JavierPerez24/Escaner3D/imagenes libro/comparacion de caracteristicas.PNG

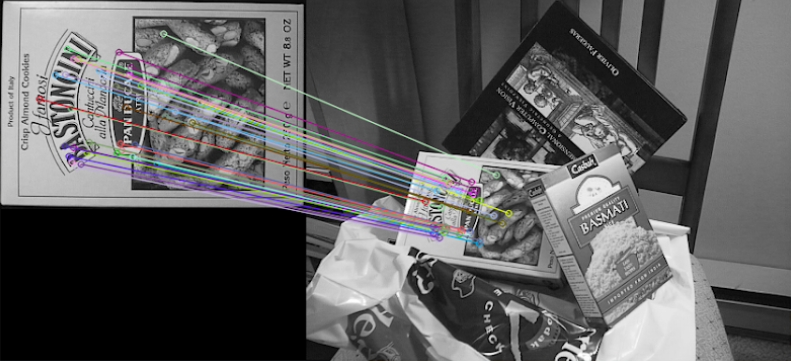
imagenes libro/comparacion de caracteristicas.PNG
