JavierPerez24/Escaner3D/imagenes libro/cnc_shield_v3_para_arduino_mexico_jalisco_guadalajara_1800x1800.jpg

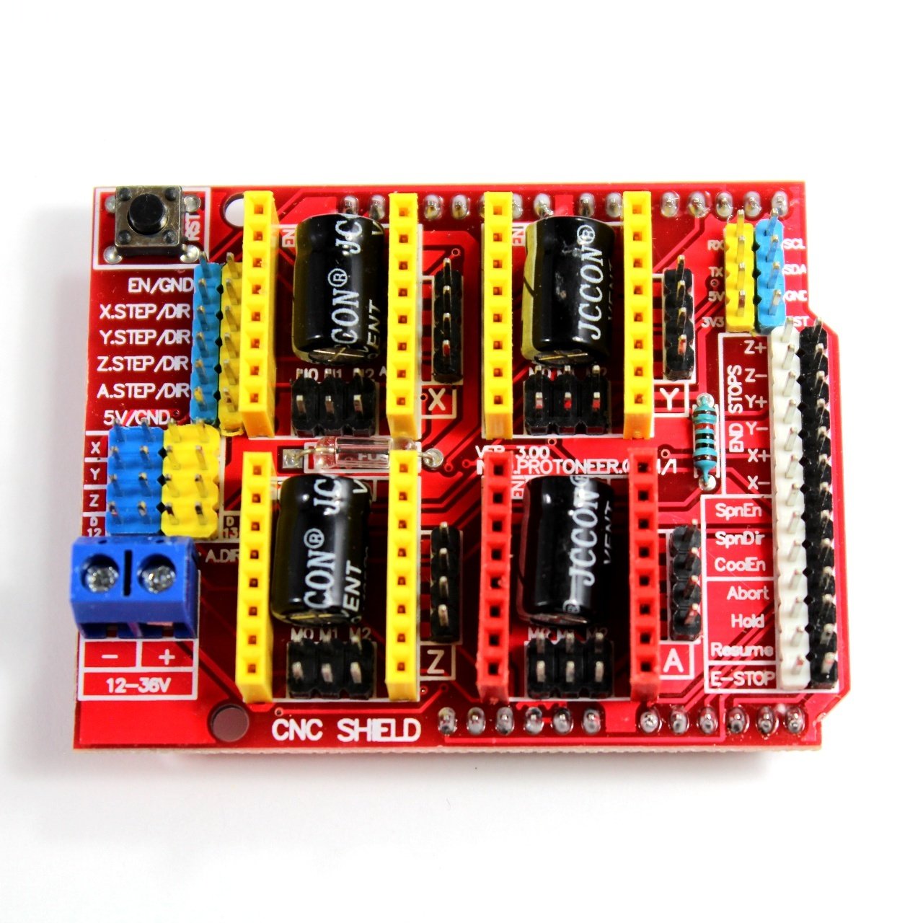
imagenes libro/cnc_shield_v3_para_arduino_mexico_jalisco_guadalajara_1800x1800.jpg
