JavierPerez24/Escaner3D/documentación/Nueva carpeta/Plantilla_Apa/Plantilla_UIS.tex

% ------------------------------------------------------------------------
%
% -------------------      Plantilla_UIS.tex       -----------------------
%
% ------------------------------------------------------------------------
% ------------------------------------------------------------------------
% ------------------------------------------------------------------------
% Versión de plantilla para realización de informes de trabajo de grado
% construida para uso de la Universidad Industrial de Santander.
%
% Reservados todos los derechos
%
% Bucaramanga, Colombia
%
% Febrero 03 de 2019
%
% ------------------------------------------------------------------------
% ------------------------------------------------------------------------
% ------------------------------------------------------------------------
%
% ------------------------------------------------------------------------
\documentclass[letter,oneside,12pt,spanish]{report}          % Encabezados
% ------------------------------------------------------------------------
\usepackage{uislatexstyleAPA}                           % Libreria UIS APA
% ------------------------------------------------------------------------
% Ingrese en este punto las librerías específicas de usuario
% ------------------------------------------------------------------------
\usepackage{epsfig}
\usepackage{amsmath}
\usepackage{amssymb}
\usepackage{subfigure}
% ------------------------------------------------------------------------
\begin{document}                                     % Inicio de documento
% ------------------------------------------------------------------------
% Definición silábica de palabras
% ------------------------------------------------------------------------
\hyphenation{pro-por-cio-nal di-se-ño}
% ------------------------------------------------------------------------
% Titulo resumido del trabajo que aparecerá en cornisa
% ------------------------------------------------------------------------
\title{CONJUNTOS ESTABILIZANTES EN CONTROLADORES PI}
% ------------------------------------------------------------------------
% Elementos previos al contenido del trabajo
% ------------------------------------------------------------------------
\include{Secs/P0}             % Portadilla, formato de nota y autorización
% ------------------------------------------------------------------------
\include{Secs/dedicatoria}                                   % Dedicatoria
% ------------------------------------------------------------------------
\include{Secs/agradecimientos}                           % Agradecimientos
% ------------------------------------------------------------------------
\tableofcontents                                      % Tabla de contenido
% ------------------------------------------------------------------------
\listoffigures                         % Lista de figuras, tablas y anexos
\listoftables
\listofanexo
% ------------------------------------------------------------------------
\include{Secs/glosario}                             % Glosario de términos
% ------------------------------------------------------------------------
% Contenido del Informe
% ------------------------------------------------------------------------
\include{Secs/res}                                               % Resumen
\include{Secs/abs}                                              % Abstract
% ------------------------------------------------------------------------
% Capítulos
% ------------------------------------------------------------------------
\input{Secs/T0}   % Introducción
\include{Secs/T1}   % Objetivos
\include{Secs/T2}   % Conjunto estabilizante para sistemas LTI
\input{Secs/T3}   % Modelo matemático del DRON
\input{Secs/T4}   % Controladores PI y su conjunto estabilizante
\input{Secs/T5}   % Recomendaciones
\input{Secs/T6}   % Trabajo futuro
\input{Secs/T7}   % Conclusiones
% ------------------------------------------------------------------------
% Bibliografía
% ------------------------------------------------------------------------
\addcontentsline{toc}{chapter}{Referencias Bibliográficas}\newpage
\bibliographystyle{apalike}
\bibliography{xbib}
% ------------------------------------------------------------------------
% Anexos
% ------------------------------------------------------------------------
\input{Secs/anexoA} % Fundamentos de sólidos rígidos
\input{Secs/anexoB} % Función ode45 de MATLAB
\input{Secs/anexoC} % Interfaz de animación de la dinámica del sistema
% ------------------------------------------------------------------------
\end{document}                                          % Fin de documento
% ------------------------------------------------------------------------
