JavierPerez24/Escaner3D/documentación/Nueva carpeta/Plantilla_Apa/Secs/P0.tex

% ------------------------------------------------------------------------
%                               Portadilla
% ------------------------------------------------------------------------

\begin{center}

Verificación de Conjuntos Estabilizantes para el Método de Diseño de Controladores PI de Ziegler \& Nichols \vspace{2.3cm}

Emerson Rey Ardila\\ \vspace{2.3cm}

Trabajo de Grado para optar al título de Ingeniero Electrónico\\ \vspace{2.3cm}

Director\\
Ricardo Alzate Castaño\\
Doctorado en Ingeniería Informática y Automática \vspace{2.4cm}

Universidad Industrial de Santander\\
Facultad de Ingenierías Fisicomecánicas\\
Escuela de Ingenierías Eléctrica, Electrónica y de Telecomunicaciones\\
Bucaramanga\\
2019\\

\end{center}

% ------------------------------------------------------------------------
%                             Nota de proyecto
% ------------------------------------------------------------------------

\newpage

\begin{figure}
\begin{center}

\end{center}
\end{figure}

% ------------------------------------------------------------------------
%                             Autorización
% ------------------------------------------------------------------------

\newpage

\begin{figure}
\begin{center}

\end{center}
\end{figure}
% ------------------------------------------------------------------------
