JavierPerez24/Escaner3D/documentación/Nueva carpeta/Plantilla_Apa/Secs/agradecimientos.tex

% ------------------------------------------------------------------------
% ------------------------------------------------------------------------
% ------------------------------------------------------------------------
%                             AGRADECIMIENTOS
% ------------------------------------------------------------------------
% ------------------------------------------------------------------------
% ------------------------------------------------------------------------
\chapter*{Agradecimientos}

\noindent Agradezco a mi familia por el apoyo ecónomico y moral que tuvieron para conmigo
durante el desarrollo de mi carrera. También agradezco a mis amigos y
compañeros por las vivencias de estos inolvidables años de universidad.\\

Un reconocimiento y agradecimiento importante lo realizo a mi director de
trabajo de grado, por dedicar su tiempo, experiencia y conocimiento en la guía
de mi proyecto.
% ------------------------------------------------------------------------
\newpage
