JavierPerez24/Escaner3D/documentación/Nueva carpeta/Plantilla_Apa/Secs/dedicatoria.tex

% ------------------------------------------------------------------------
% ------------------------------------------------------------------------
% ------------------------------------------------------------------------
%                               Dedicatoria
% ------------------------------------------------------------------------
% ------------------------------------------------------------------------
% ------------------------------------------------------------------------
\chapter*{Dedicatoria}

\noindent Este trabajo viene dedicado para todas aquellas personas que apoyaron el desarrollo
y ejecución de este trabajo de grado.\\

En especial reconozco la permanente presencia de Dios en mi camino de vida.
% ------------------------------------------------------------------------
