JavierPerez24/Escaner3D/documentación/Nueva carpeta/Plantilla_Apa/Secs/res.tex

% ------------------------------------------------------------------------
% ------------------------------------------------------------------------
% ------------------------------------------------------------------------
%                                Resumen
% ------------------------------------------------------------------------
% ------------------------------------------------------------------------
% ------------------------------------------------------------------------
\chapter*{Resumen}

\footnotesize{
\begin{description}
  \item[Título:] Verificación de Conjuntos Estabilizantes para Diseño de Controladores PI de Ziegler \& Nichols \astfootnote{Trabajo de grado}
  \item[Autor:] Emerson Rey Ardila \asttfootnote{Facultad de Ingenierías Físico-Mecánicas. Escuela de Ingenierías Eléctrica, Electrónica y telecomunicaciones. Director: Ricardo Alzate Castaño, Doctorado en Ingeniería Informática y Automática.}
  \item[Palabras Clave:] Conjunto Estabilizante, Controladores PI, Diseño Gráfico de Compensadores, Método de Ziegler \& Nichols.
  \item[Descripción:] El presente proyecto presenta el cálculo de conjuntos estabilizantes para sistemas SISO LTI controlados por compensadores de estructura simple. Se estudia la fragilidad de controladores PI calculados empleando el método \emph{Ziegler \& Nichols}, técnica de referencia en múltiples aplicaciones de ambito industrial. A partir de la definición para una métrica basada en la interpretación geométrica para los márgenes de estabilidad del sistema controlado, se verifica que el controlador diseñado con el método en cuestión no necesariamente tolera variaciones significativas en sus valores de parámetro. Por el contrario, asume comportamientos cercanos a los límites de estabilidad proporcionados mediante el cálculo de su conjunto estabilizante. Lo anterior se convierte en información importante tomando en cuenta que generalmente los métodos de diseño se someten a un ajuste fino. Como métrica, se define el espacio planar correspondiente con la intersección entre una elipse y una línea recta que representan lugares geométricos de márgen de fase y/o ganancia constantes. Adicional a lo anterior, se desarrolló una interfaz en MATLAB que permite calcular gráficamente los parámetros del controlador a partir de un conjunto admisible de especificaciones con base en su conjunto estabilizante. Trabajo complementario incluye la utilización de técnicas computacionales para el cálculo de
conjuntos estabilizantes sobre plantas arbitrarias.
\end{description}}\normalsize
% ------------------------------------------------------------------------
