JavierPerez24/Escaner3D/documentación/Nueva carpeta/Plantilla_Apa/Secs/T1.tex

% ------------------------------------------------------------------------
% ------------------------------------------------------------------------
% ------------------------------------------------------------------------
%                              Objetivos
% ------------------------------------------------------------------------
% ------------------------------------------------------------------------
% ------------------------------------------------------------------------

\chapter{Objetivos}
% ------------------------------------------------------------------------
% ------------------------------------------------------------------------

\section*{Objetivo general}

\begin{itemize}
   \item[ ] Analizar las condiciones de estabilidad del conjunto de parámetros PI calculados
   empleando el método de diseño de controladores de Ziegler \& Nichols.
\end{itemize}

\section*{Objetivos específicos}

\begin{itemize}
    \item[ ] Interpretar las tablas de diseño de parámetros PI de Ziegler \& Nichols en términos de conjuntos estabilizantes;
    \item[ ] Desarrollar un algoritmo que permita verificar las condiciones de estabilidad para controladores PI diseñados mediante dicho método;
    \item[ ] Implementar una interfaz para cálculo de controladores PI a partir de selección de parámetros en el dominio del tiempo, admisibles respecto al conjunto estabilizante correspondiente.
\end{itemize}
% ------------------------------------------------------------------------
% ------------------------------------------------------------------------
