JavierPerez24/Escaner3D/documentación/Nueva carpeta/Plantilla_Apa/Secs/T5.tex

% ------------------------------------------------------------------------
% ------------------------------------------------------------------------
% ------------------------------------------------------------------------
%                            Recomendaciones
% ------------------------------------------------------------------------
% ------------------------------------------------------------------------
% ------------------------------------------------------------------------

\chapter{Recomendaciones}
% ------------------------------------------------------------------------
\noindent Al momento de ejecutar la interfaz desarrollada es importante que el usuario tenga una noción respecto al rango de valores que desea visualizar, pues esto hace más fino el detalle de los puntos sobre los cuales se calcula el conjunto estabilizante y por ende, la exploración de los valores admisibles para el control en la práctica.
% ------------------------------------------------------------------------
