JavierPerez24/Escaner3D/documentación/Nueva carpeta/Plantilla_Apa/Secs/T6.tex

% ------------------------------------------------------------------------
% ------------------------------------------------------------------------
% ------------------------------------------------------------------------
%                            Trabajo futuro
% ------------------------------------------------------------------------
% ------------------------------------------------------------------------
% ------------------------------------------------------------------------

\chapter{Trabajo futuro}
% ------------------------------------------------------------------------
\noindent Actividades complementarias a los desarrollos presentados, incluyen el cálculo automático para conjuntos estabilizantes en plantas arbitrarias empleando el \emph{método de la signatura} desarrollado por Keel y Bhattacharyya en \citep{keel2008}.\\

Asimismo es importante explorar otras topologias de compensador y controladores PID, en sus versiones de tiempo continuo y discreto.
% ------------------------------------------------------------------------
