JavierPerez24/Escaner3D/Entrega/CartaAutorizacion.pdf

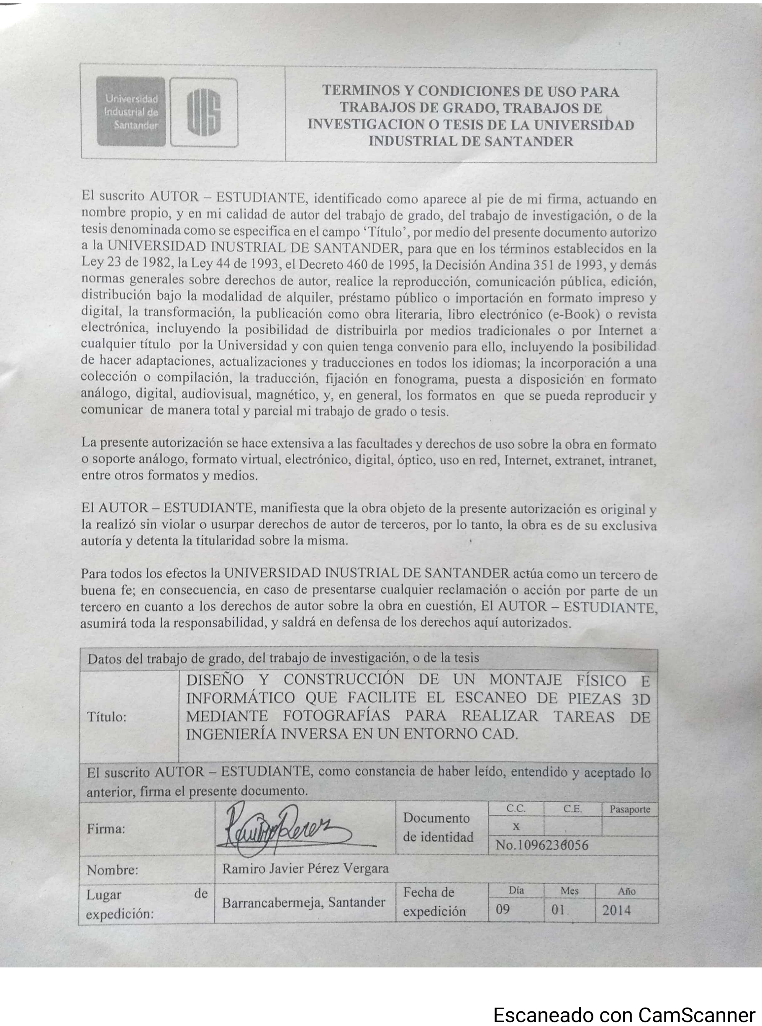
[picture p50: page 1]
