JavierPerez24/Escaner3D/Entrega/Ficha Ramiro Pérez.pdf

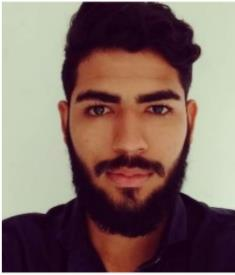
[picture p51: figure]

RAMIRO JAVIER PÉREZ VERGARA

3194591198
3214230738

Ramirojavierperezvergara@gmail.com

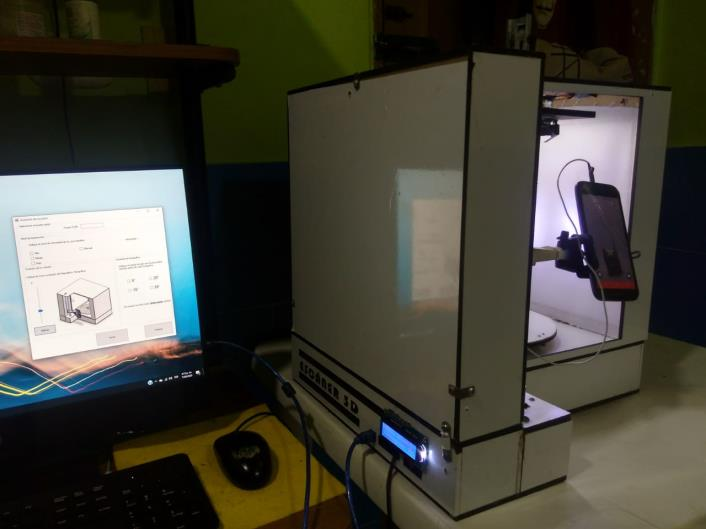
[picture p52: figure]

UNIVERSIDAD INDUSTRIAL DE SANTANDER

ESCUELA DE INGENIERÍA MECÁNICA

25 DE NOVIEMBRE DE 2020

DISEÑO Y CONSTRUCCIÓN DE UN MONTAJE FÍSICO E INFORMÁTICO QUE FACILITE EL ESCANEO DE PIEZAS 3D MEDIANTE FOTOGRAFÍAS PARA REALIZAR TAREAS DE INGENIERÍA INVERSA EN UN ENTORNO CAD.
