JavierPerez24/Escaner3D/documentación/Sistema de seguimiento de caras y estimación de pose con modelado automático 3D.pdf

## REF.: TRANSP_UAH_01

### SECTOR

INDUSTRIAL | Industria y Transporte
INVESTIGADOR | Luis Miguel Bergasa Pascual
DEPARTAMENTO | Electrónica
DATOS DE CONTACTO | + 34 91 885 65 69 + 34 91 885 65 41
| @ luism.bergasa@uah.es
PÁGINA WEB | Robótica de Servicios y Tecnologías para la
| Seguridad Vial (https://portal.uah.es/portal/page/portal/grupos_de_investigacion/83)

## DESCRIPCIÓN DEL RESULTADO DE INVESTIGACIÓN

### TÍTULO

Sistema de seguimiento de caras y estimación de pose con modelado automático 3D

### RESUMEN

El grupo Robesafe de la Universidad de Alcalá ha desarrollado un método que realiza el seguimiento y estimación de las poses de la cara de una persona, usando visión estéreo. Este método no necesita identificar previamente a la persona y no requiere un entrenamiento previo.

El modelo de cara se construye automáticamente on-line. Este método podría servir como la base de un sistema de supervisión de conducción o de análisis de la conducta de conductores y ha sido probado sobre secuencias registradas en un simulador naturalista y en un coche en movimiento.

El grupo está interesado en alcanzar acuerdos comerciales con asistencia técnica con empresas del sector de los componentes para la automoción, diseñadoras de simuladores y electrónica de entretenimiento (interfaces para PCs, TVs, videojuegos, etc).

### DESCRIPCIÓN Y CARACTERÍSTICAS FUNDAMENTALES

El modelo está formado por un conjunto de puntos tridimensionales 3D de la cara. Estos puntos son automáticamente seleccionados en la primera imagen obtenida por las cámaras. La cara es localizada usando el método de Viola&Jones y los puntos de la cara que presentan adecuadas características para el seguimiento se encuentran con el detector de puntos de Harris. Se usan hasta 30 puntos.

Los parches de imagen alrededor de las proyecciones 2D de estos puntos en cada cámara son rastreados en cada imagen usando el algoritmo Simultaneous Modelling and Tracking (SMAT). Este algoritmo construye un modelo con los cambios de la apariencia o la textura alrededor de cada punto.

La pose en 3D se obtiene de puntos en 2D usando el algoritmo POSIT de manera redundante por ambas cámaras con el fin de mejorar la solidez del sistema.

El tracking puede fallar para algunos puntos en cada frame. El algoritmo RANSAC se usa entonces para desechar puntos erróneos en la valoración de la pose. Después de obtener un set de puntos correctamente localizados (inliers), la posición de los puntos outlier es reinicializada en función de la pose estimada.

Algunos puntos se ocluyen cuando la cabeza de la persona gira y no pueden ser entonceslocalizados. Este sistema sin embargo es capaz de estimar la pose de la cara de manera fiable en giros de entre +/- 90º. Para ello utiliza una novedosa técnica que va completando el modelo según la cara va girando y emplea el método de bundle adjustment para ajustar el modelo.

El sistema funciona ya en condiciones reales y ha sido validado en un simulador naturalita y en un vehículo de demostración. Los resultados experimentales y el análisis del funcionamiento se encuentran listos para ser presentados.

### ASPECTOS INNOVADORES

Este sistema de visión artificial es capaz de reconocer por primera vez la orientación de la cara humana, sin necesidad de identificar previamente a la persona ni de realizar entrenamientos previos. Además, es capaz de realizar seguimiento con bajas condiciones de iluminación y alcanza un rango de funcionamiento entre +/- 90º.

Este sistema es innovador en cuanto a la forma de juntar los tres algoritmos con los que funciona: SMAT, RANSAC, Levenberg-Marquardt y Bundle Adjustment. Se desconoce la existencia de un sistema anterior que los haya utilizado de esta manera y que logre un rango de funcionamiento de giro total en condiciones de baja iluminación.

### PALABRAS CLAVE

Visión artificial, tracking 3D, seguimiento de caras, estimación de poses, seguridad transporte y conducción

### DISCIPLINAS CIENTÍFICAS EN LAS QUE SE ENCUADRA EL RESULTADO DE INVESTIGACIÓN

Tecnologías de la Información y las
Telecomunicaciones

Fabricación Industrial, tecnologías de los Materiales y el Transporte

Tecnologías Industriales

Energía

Ciencias Físicas y Exactas

Ciencias Biológicas

Agricultura y Recursos Marinos

Industria de la Agroalimentación

Medidas y estándares

Medioambiente y prevención de riesgos

Socioeconomía

### GRADO DE DESARROLLO DEL RESULTADO DE INVESTIGACIÓN

En fase de desarrollo

Desarrollada, lista para demostración

En el mercado

### FUENTE DE FINANCIACIÓN DE LA INVESTIGACIÓN

Proyecto Europeo

Proyecto Nacional

Proyecto Regional

Financiación Privada

## ASPECTOS COMERCIALES

### VENTAJAS COMPETITIVAS

Este método funciona en tiempo real (30 imágenes por segundo) y tarda 33 milisegundos para ejecutar los algoritmos.

Es un sistema muy robusto que continua funcionando incluso ante situaciones para las cuales el modelo no ha sido específicamente diseñado (contrates de luz, giros bruscos de cara, etc). El sistema funciona con más error pero sin perderse.

### ESTADO DE LA PROPIEDAD INDUSTRIAL E INTELECTUAL

Patente solicitada

Patente concedida

Software registrado

Derechos exclusivos

Secreto industrial

Copyright

### COMENTARIOS

El grupo de investigación posee el secreto industrial de la tecnología

### TIPO DE COLABORACIÓN SOLICITADA

Cooperación técnica

Acuerdo de joint venture

Acuerdo de fabricación

Acuerdo comercial con asistencia técnica

Acuerdo de licencia

### COMENTARIOS

El grupo de investigación busca alcanzar acuerdos comerciales con asistencia técnica con empresas del sector de los componentes para automóviles, compañías que desarrollen video juegos, realidad virtual, interfaz de control de robots, simuladores de conducción para el sector aeronáutico, etc.

### INFORMACIÓN ADICIONAL

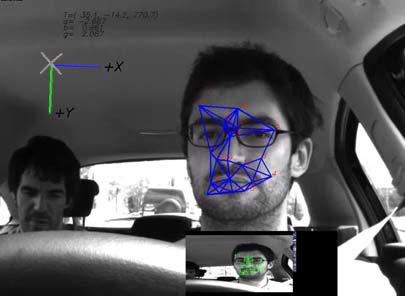
[picture p68: figure]
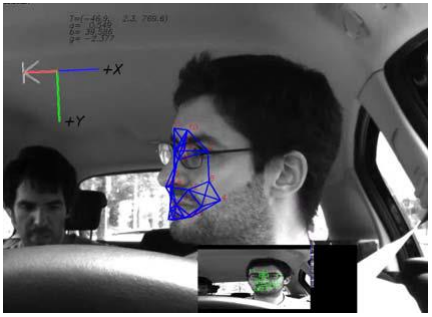
[picture p69: figure]

## DATOS DE CONTACTO OTRI

UNIVERSIDAD DE ALCALÁ-OFICINA DE TRANSFERENCIA DE RESULTADOS DE INVESTIGACIÓN (OTRI)

### - Edifício Politécnico Campus Externo UAH 28871 Alcalá de Henares (Madrid)

- + 34 91 885 45 68 / 45 61
- + 34 91 885 48 46

### @ otriuah@uah.es
