JavierPerez24/Escaner3D/cronograma etapa final.PNG

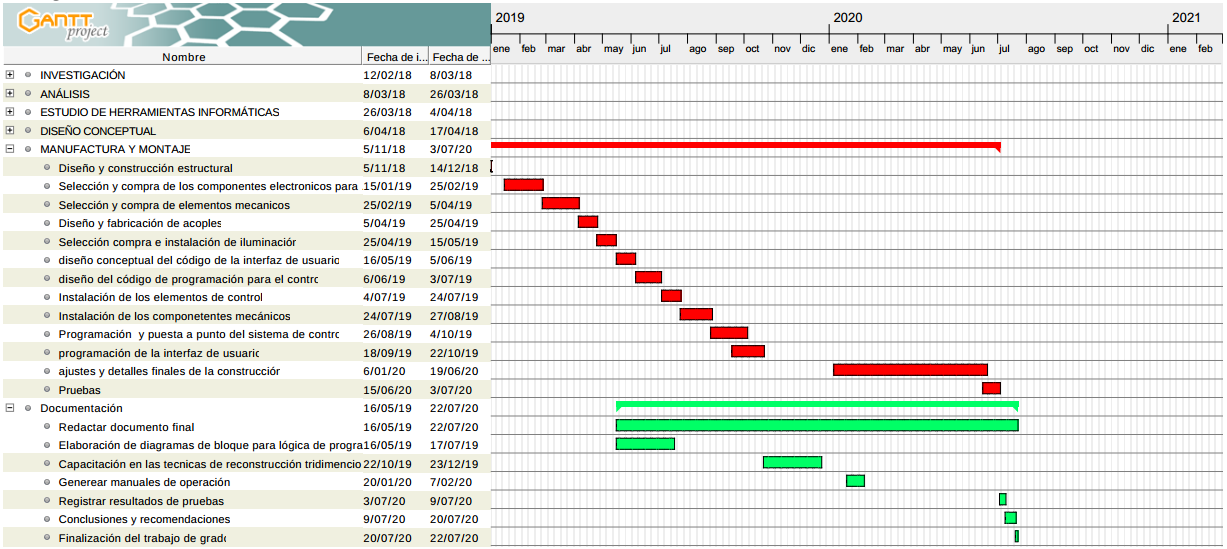
cronograma etapa final.PNG
