JavierPerez24/Escaner3D/Diagramas/4 iluminacion_ino.PNG

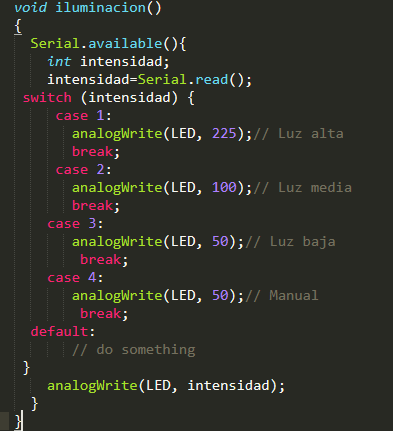
Diagramas/4 iluminacion_ino.PNG
