JavierPerez24/Escaner3D/Diagramas/Posición.png

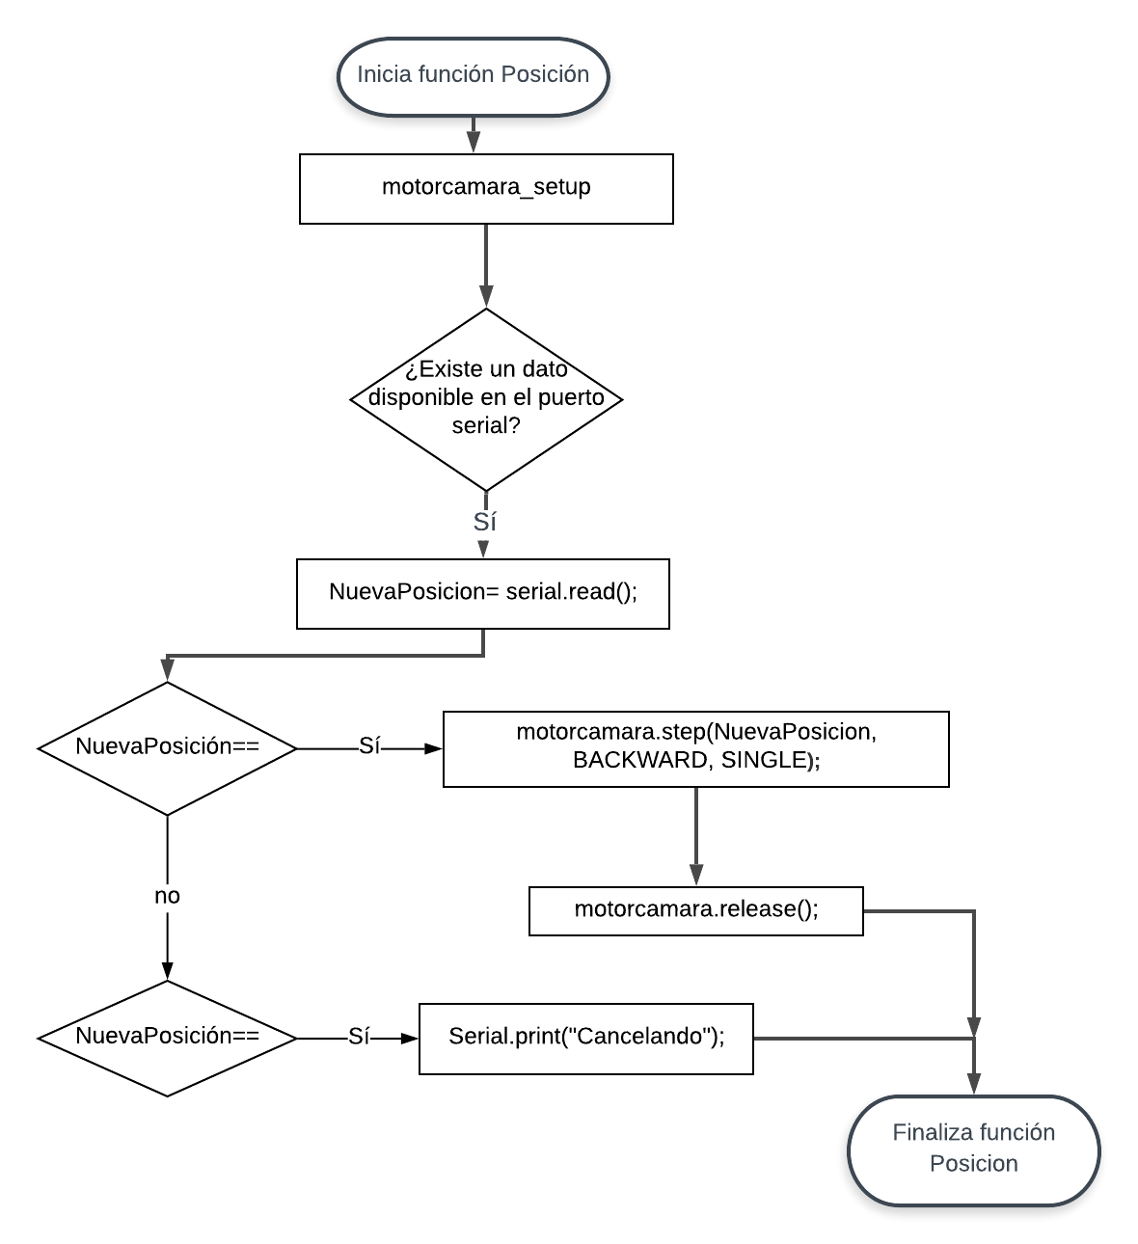
Diagramas/Posición.png
