JavierPerez24/Escaner3D/documentación/F0E7L8AIN9438H5.LARGE.jpg

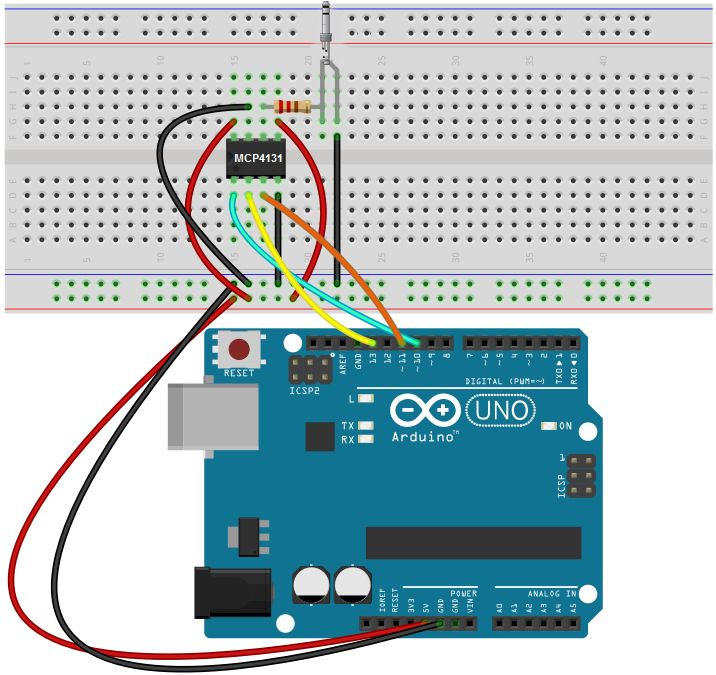
documentación/F0E7L8AIN9438H5.LARGE.jpg
