JavierPerez24/Escaner3D/imagenes libro/1 resumen rojo.png

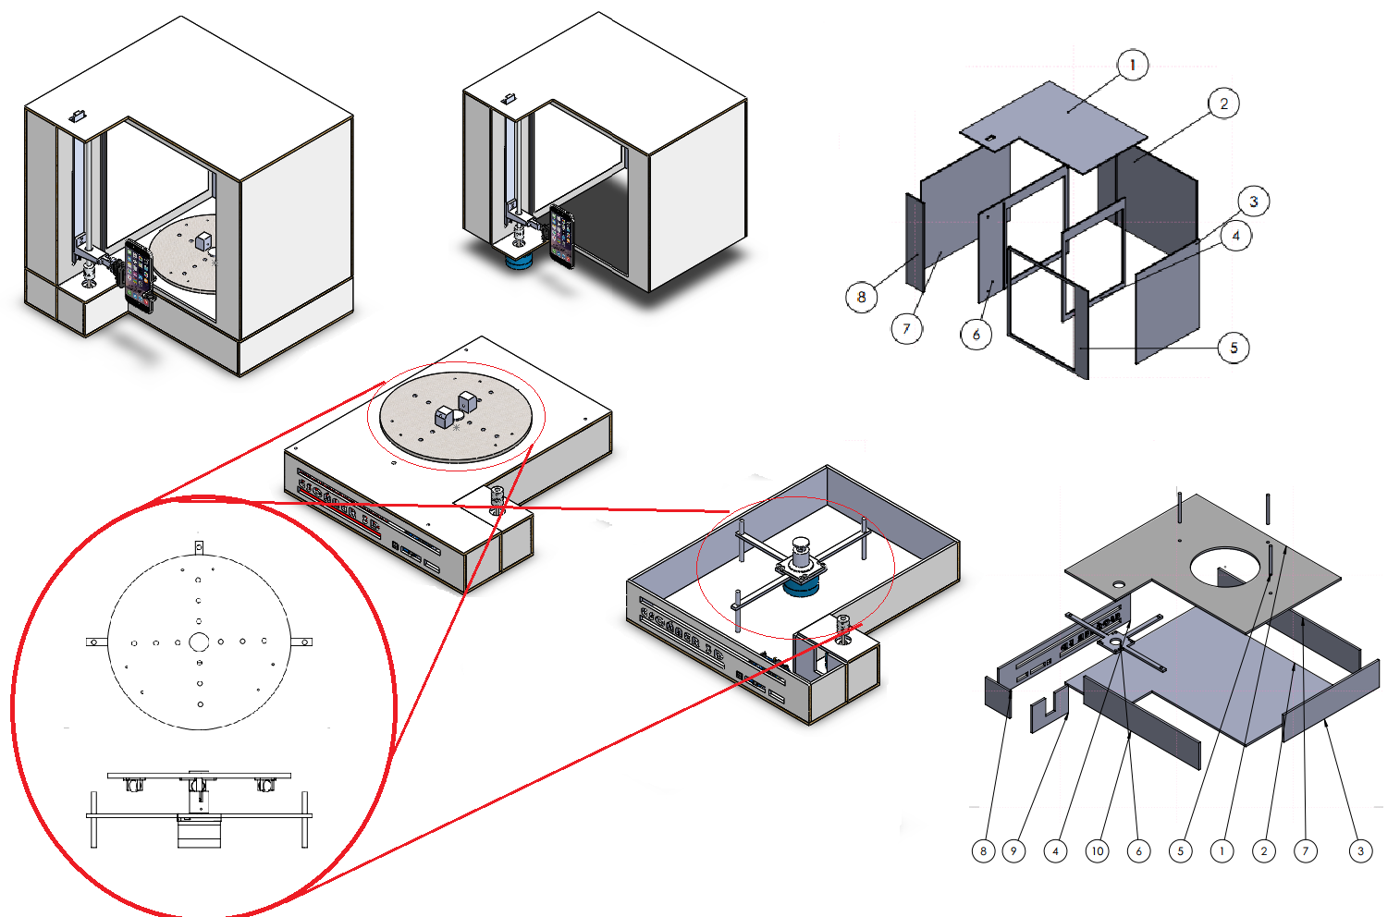
imagenes libro/1 resumen rojo.png
