JavierPerez24/Escaner3D/imagenes libro/4 sup.PNG

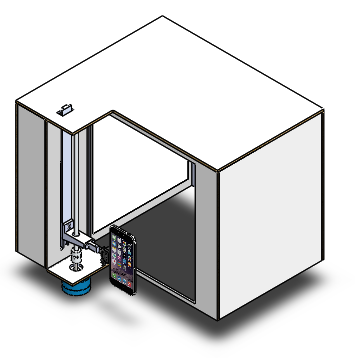
imagenes libro/4 sup.PNG
