JavierPerez24/Escaner3D/imagenes libro/5054-3-m-dulos-de-iluminaci-n-LED-para-se-al-DC12V-m-dulos-led-smd.jpg_q50.jpg

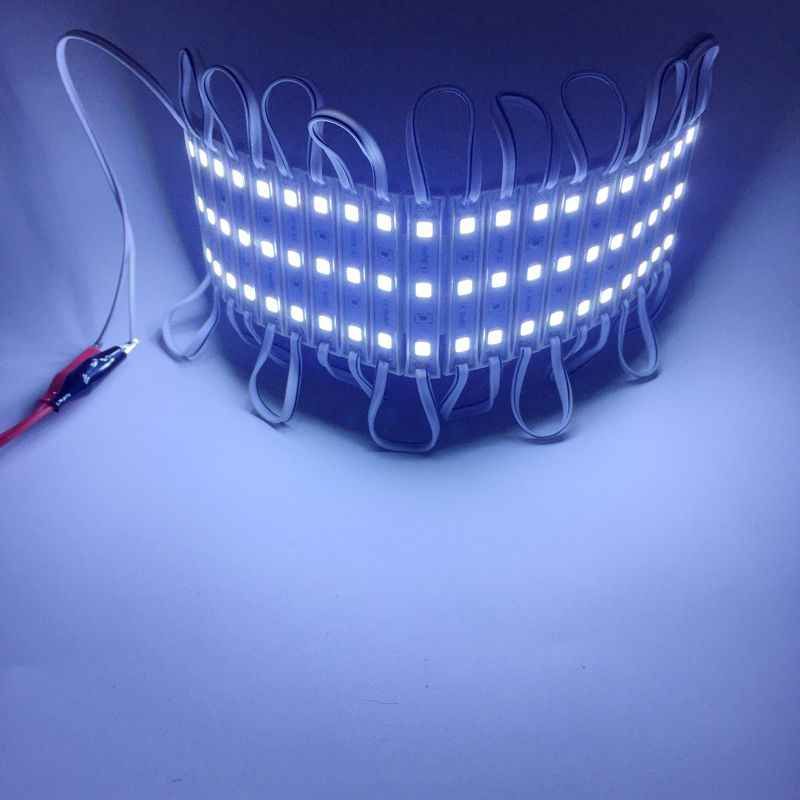
imagenes libro/5054-3-m-dulos-de-iluminaci-n-LED-para-se-al-DC12V-m-dulos-led-smd.jpg_q50.jpg
