JavierPerez24/Escaner3D/imagenes libro/a4988.PNG

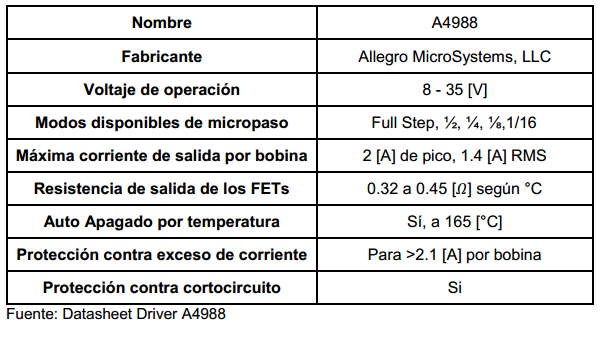
imagenes libro/a4988.PNG
