JavierPerez24/Escaner3D/imagenes libro/acople m ca1.PNG

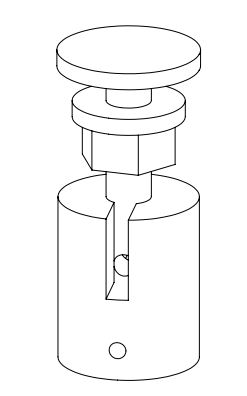
imagenes libro/acople m ca1.PNG
