JavierPerez24/Escaner3D/imagenes libro/acople m ca.PNG

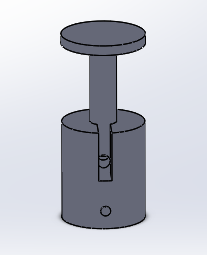
imagenes libro/acople m ca.PNG
