JavierPerez24/Escaner3D/imagenes libro/Acople motor camara.PNG

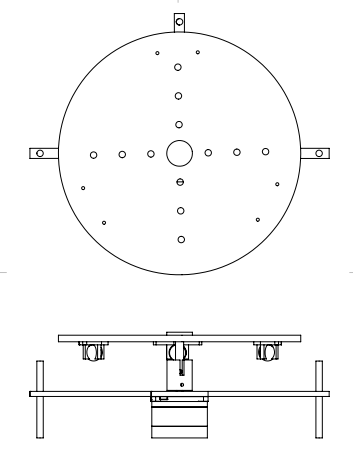
imagenes libro/Acople motor camara.PNG
