JavierPerez24/Escaner3D/imagenes libro/arduino-cnc-shield-v3.jpg

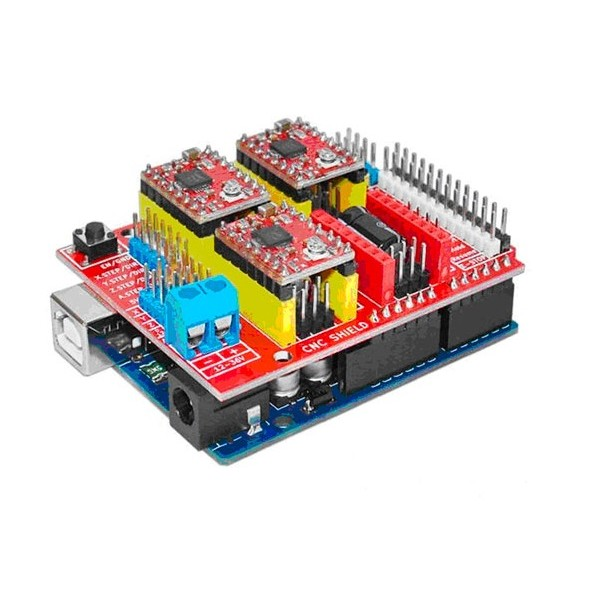
imagenes libro/arduino-cnc-shield-v3.jpg
