JavierPerez24/Escaner3D/imagenes libro/arduinounogbrl.png

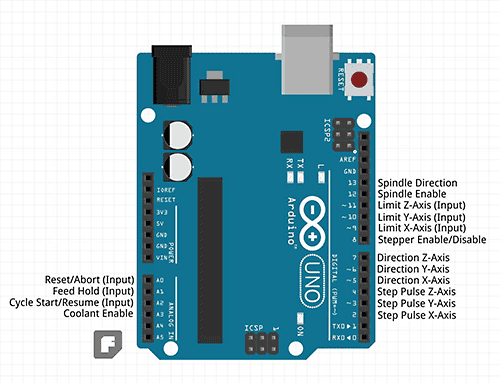
imagenes libro/arduinounogbrl.png
