JavierPerez24/Escaner3D/imagenes libro/base motorpi 2.PNG

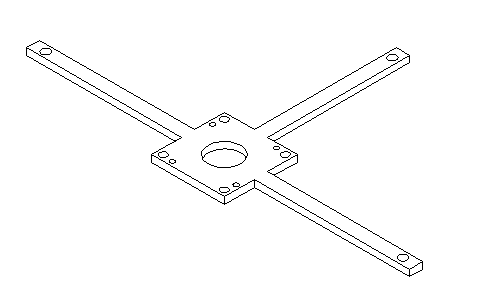
imagenes libro/base motorpi 2.PNG
