JavierPerez24/Escaner3D/imagenes libro/base motorpi.PNG

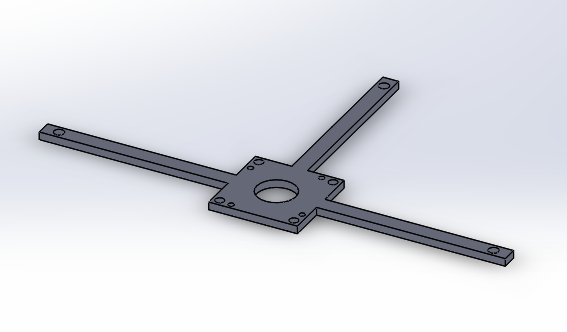
imagenes libro/base motorpi.PNG
