JavierPerez24/Escaner3D/imagenes libro/bordes.PNG

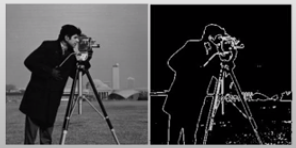
imagenes libro/bordes.PNG
