JavierPerez24/Escaner3D/imagenes libro/caracteristicas locales y globales.PNG

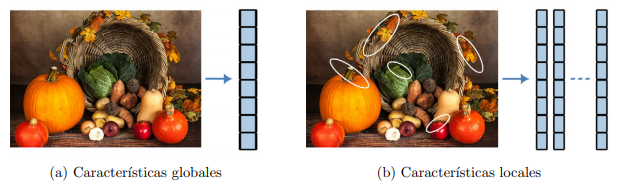
imagenes libro/caracteristicas locales y globales.PNG
