JavierPerez24/Escaner3D/imagenes libro/cnc-shield-NAYLAMP.jpg

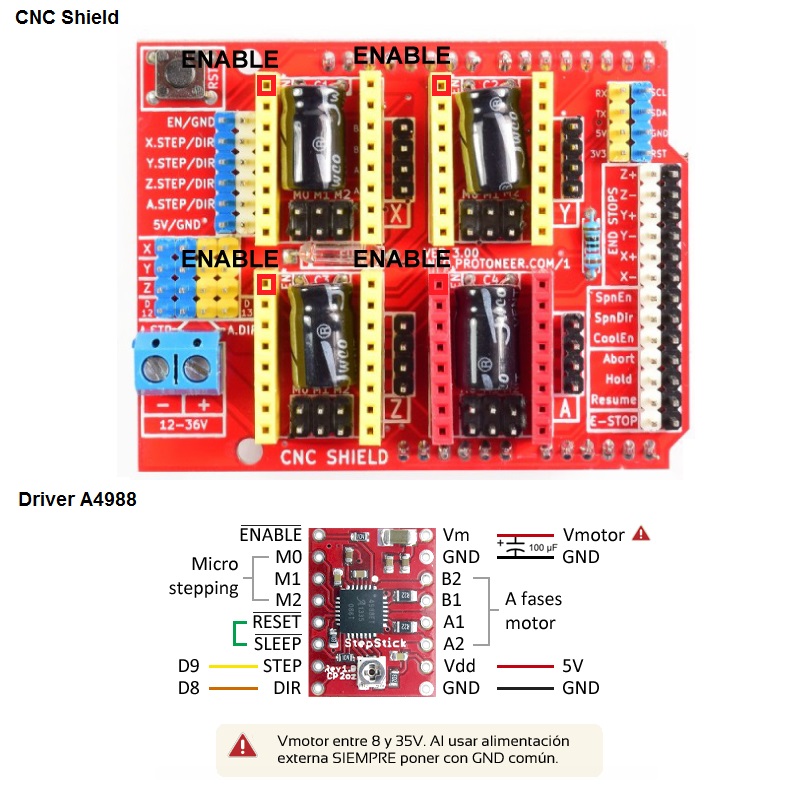
imagenes libro/cnc-shield-NAYLAMP.jpg
