JavierPerez24/Escaner3D/imagenes libro/correspondencia de puntos2.PNG

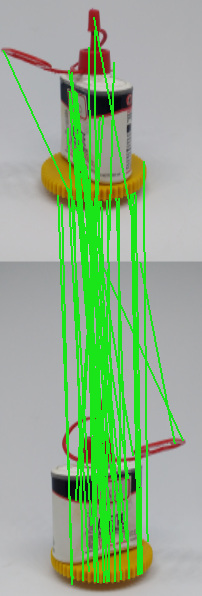
imagenes libro/correspondencia de puntos2.PNG
