JavierPerez24/Escaner3D/imagenes libro/corte plato motor 1.PNG

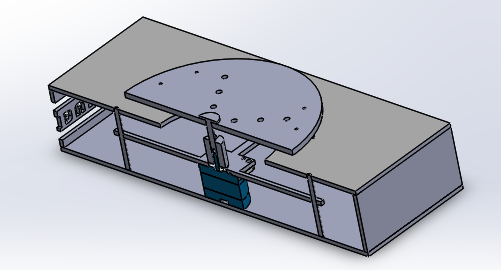
imagenes libro/corte plato motor 1.PNG
