JavierPerez24/Escaner3D/imagenes libro/corte plato motor.PNG

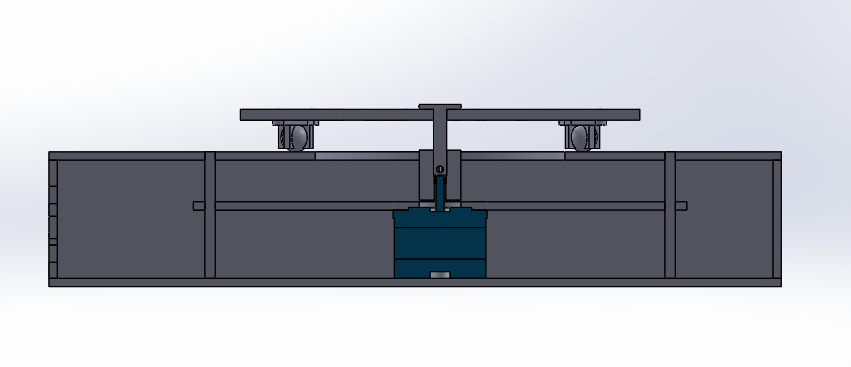
imagenes libro/corte plato motor.PNG
