JavierPerez24/Escaner3D/imagenes libro/cronograma2.PNG

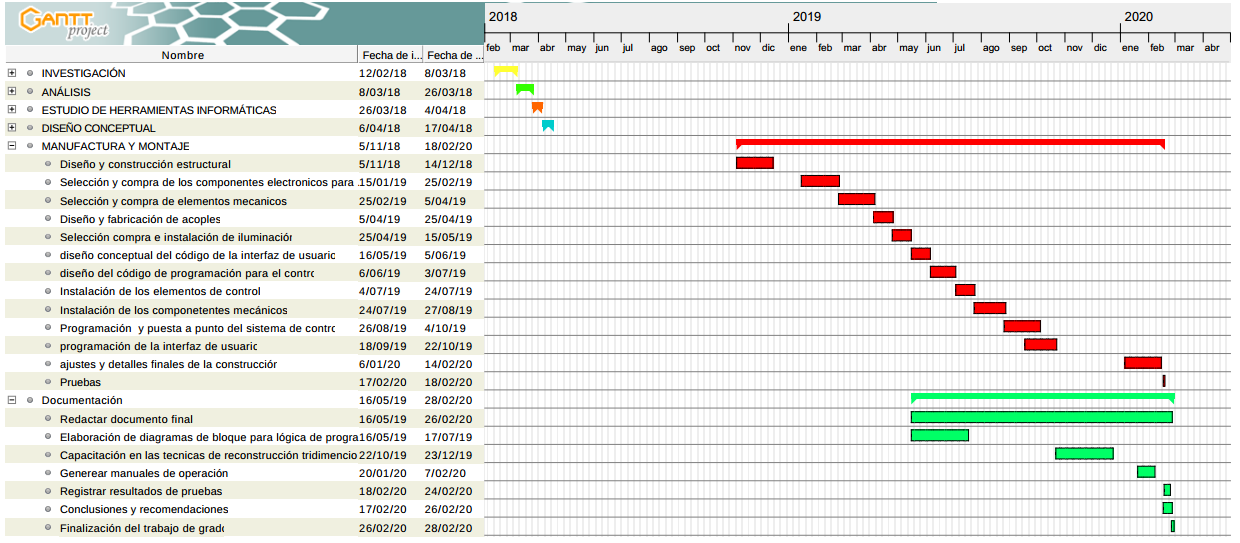
imagenes libro/cronograma2.PNG
