JavierPerez24/Escaner3D/imagenes libro/cronograma 3.PNG

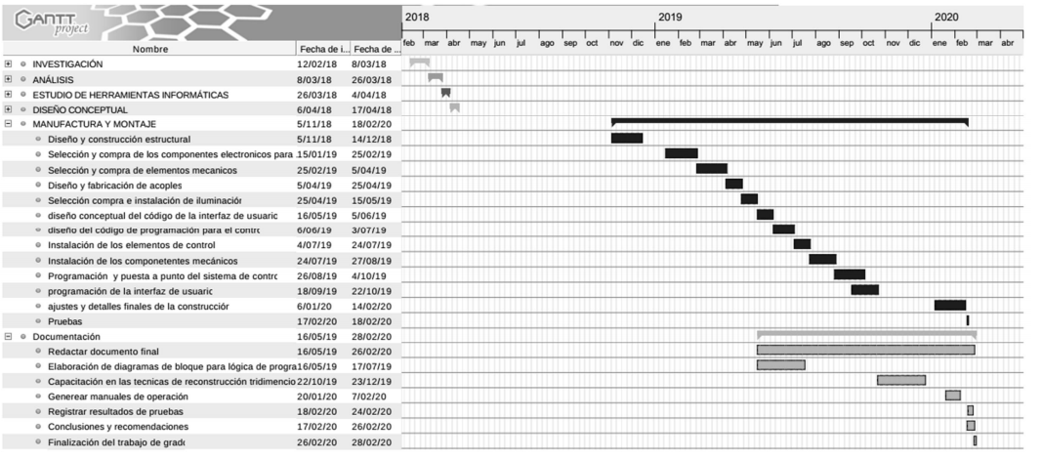
imagenes libro/cronograma 3.PNG
