JavierPerez24/Escaner3D/imagenes libro/cronograma actual.PNG

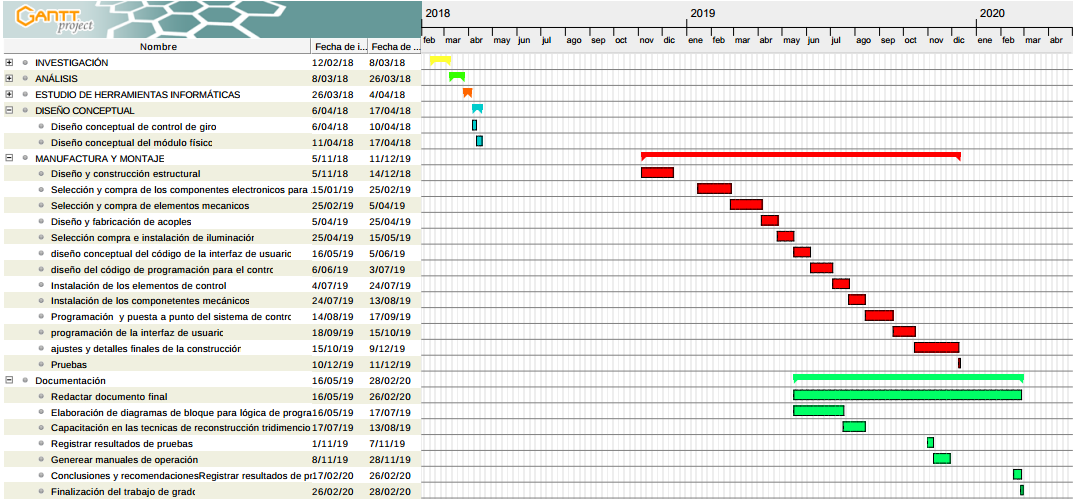
imagenes libro/cronograma actual.PNG
