JavierPerez24/Escaner3D/imagenes libro/cronograma.PNG

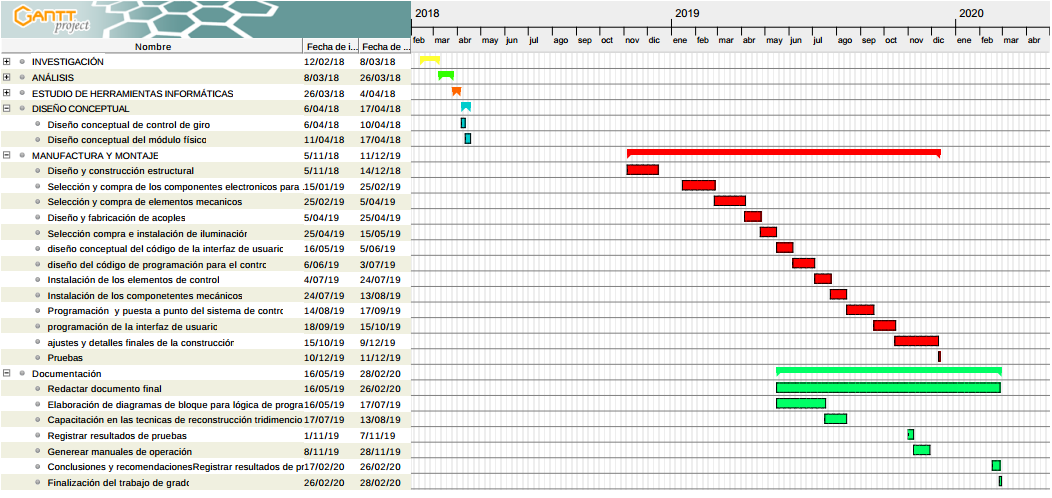
imagenes libro/cronograma.PNG
