JavierPerez24/Escaner3D/imagenes libro/esqueletonizacion.PNG

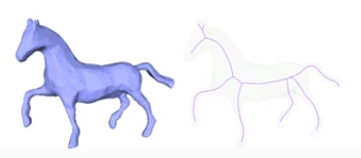
imagenes libro/esqueletonizacion.PNG
