JavierPerez24/Escaner3D/imagenes libro/estado de escaneo finalizado.PNG

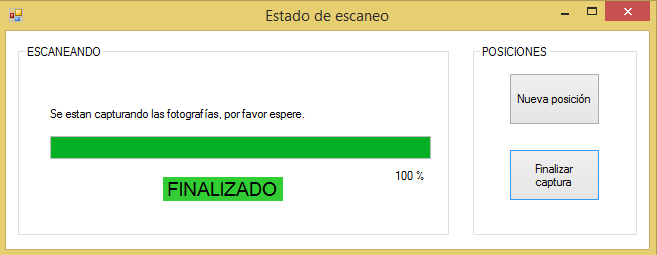
imagenes libro/estado de escaneo finalizado.PNG
