JavierPerez24/Escaner3D/imagenes libro/estado de escaneo.PNG

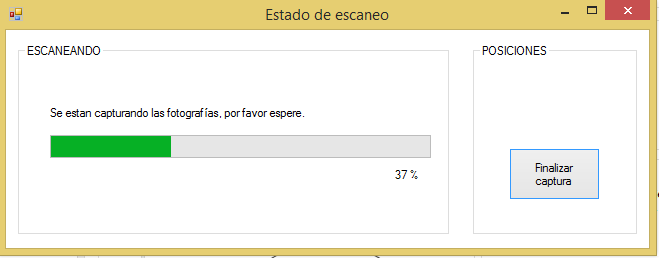
imagenes libro/estado de escaneo.PNG
