JavierPerez24/Escaner3D/imagenes libro/estructura completa 2.PNG

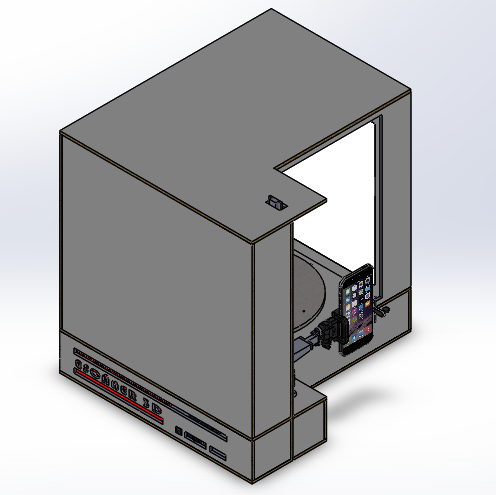
imagenes libro/estructura completa 2.PNG
