JavierPerez24/Escaner3D/imagenes libro/estructura completa 3.PNG

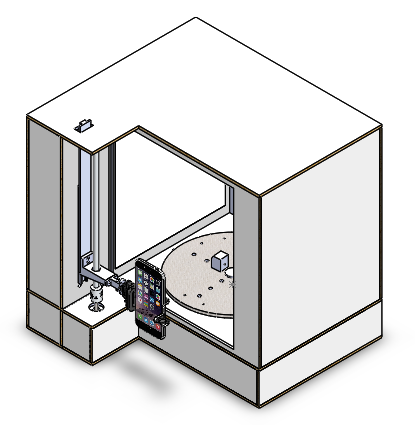
imagenes libro/estructura completa 3.PNG
