JavierPerez24/Escaner3D/imagenes libro/Extracccion de caracteristicas.PNG

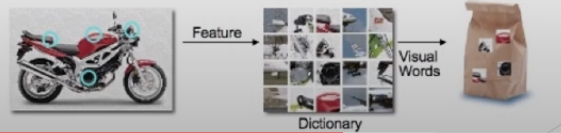
imagenes libro/Extracccion de caracteristicas.PNG
