JavierPerez24/Escaner3D/imagenes libro/final-de-carrera-con-palanca-3a-250v.jpg

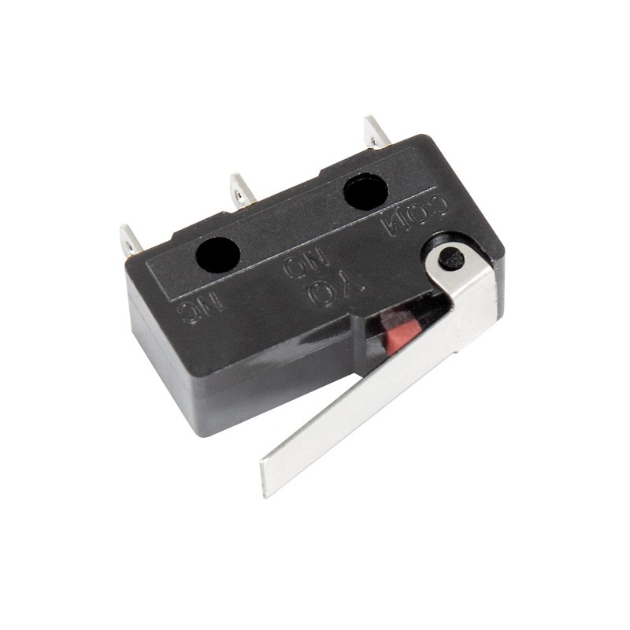
imagenes libro/final-de-carrera-con-palanca-3a-250v.jpg
