JavierPerez24/Escaner3D/imagenes libro/final.PNG

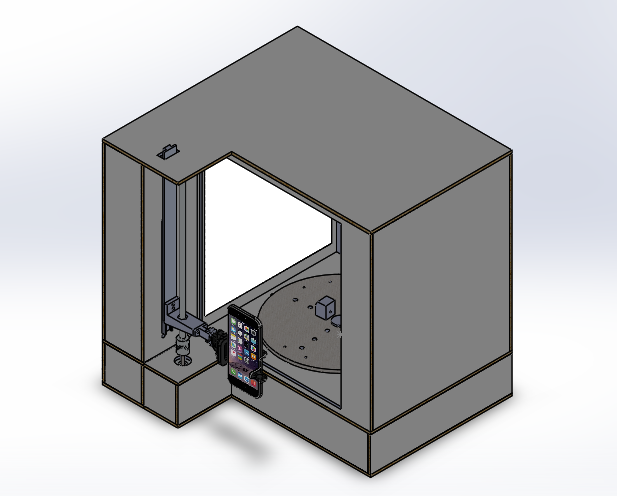
imagenes libro/final.PNG
