JavierPerez24/Escaner3D/imagenes libro/geometria epipolar.PNG

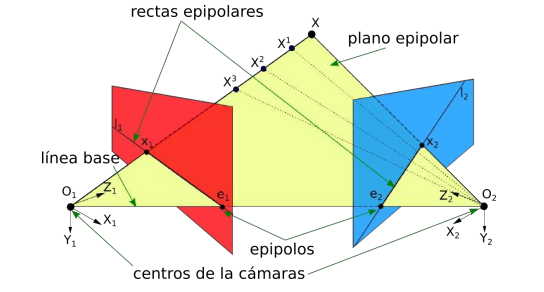
imagenes libro/geometria epipolar.PNG
