JavierPerez24/Escaner3D/imagenes libro/HTB1n6MdaE_rK1Rjy0Fcq6zEvVXac.jpg_q50.jpg

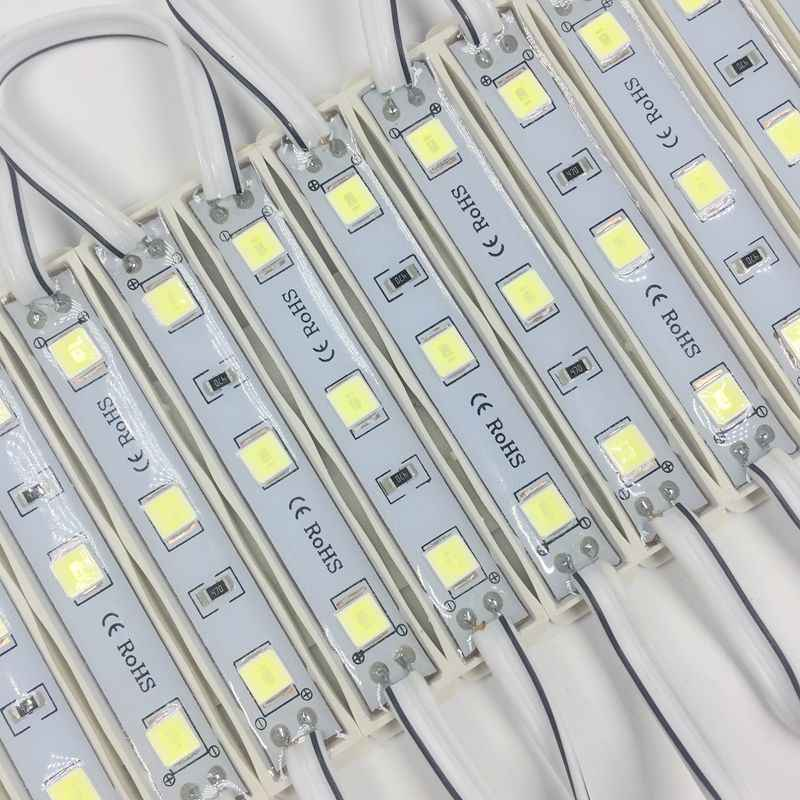
imagenes libro/HTB1n6MdaE_rK1Rjy0Fcq6zEvVXac.jpg_q50.jpg
