JavierPerez24/Escaner3D/imagenes libro/inf.PNG

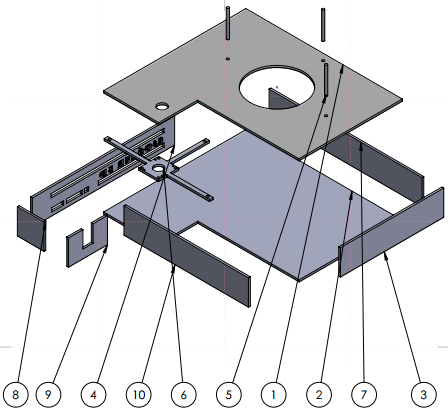
imagenes libro/inf.PNG
