JavierPerez24/Escaner3D/imagenes libro/infer blanco.PNG

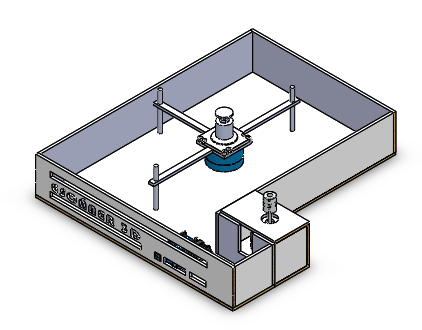
imagenes libro/infer blanco.PNG
