JavierPerez24/Escaner3D/imagenes libro/inferior blanco.PNG

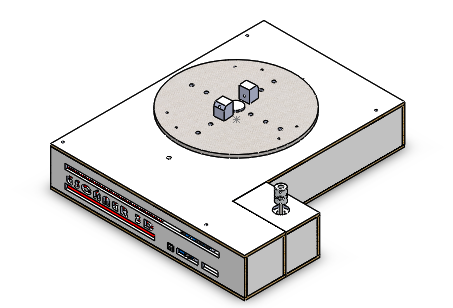
imagenes libro/inferior blanco.PNG
