JavierPerez24/Escaner3D/imagenes libro/inferior.PNG

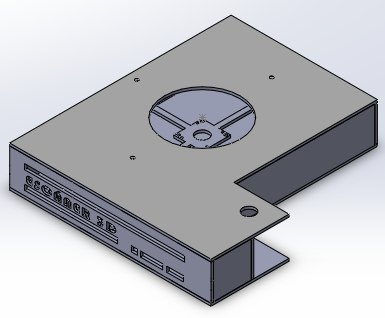
imagenes libro/inferior.PNG
