JavierPerez24/Escaner3D/imagenes libro/interfaz de usuario.PNG

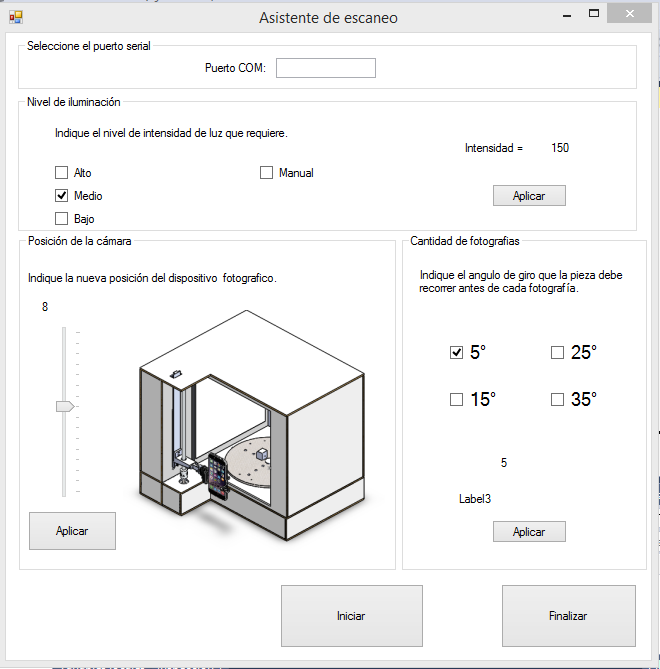
imagenes libro/interfaz de usuario.PNG
