JavierPerez24/Escaner3D/imagenes libro/interfaz.PNG

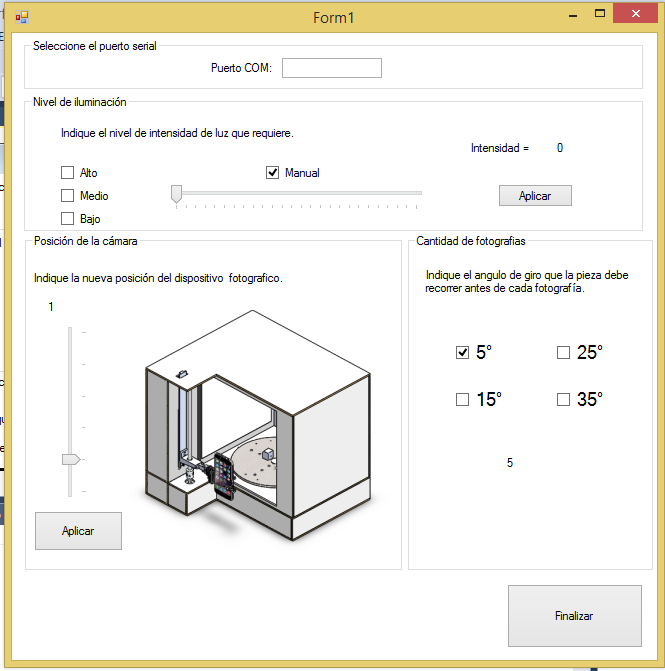
imagenes libro/interfaz.PNG
