JavierPerez24/Escaner3D/imagenes libro/MotorPP.jpg

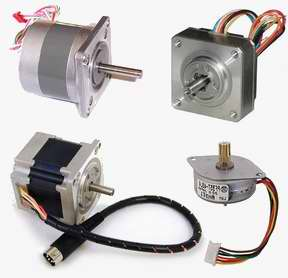
imagenes libro/MotorPP.jpg
