JavierPerez24/Escaner3D/imagenes libro/nube de puntos.PNG

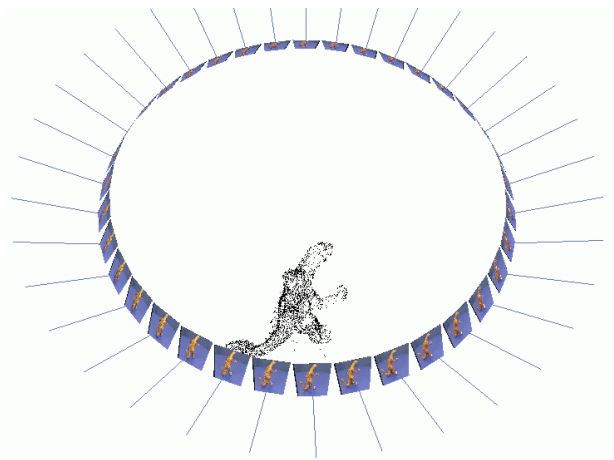
imagenes libro/nube de puntos.PNG
