JavierPerez24/Escaner3D/imagenes libro/resumen.png

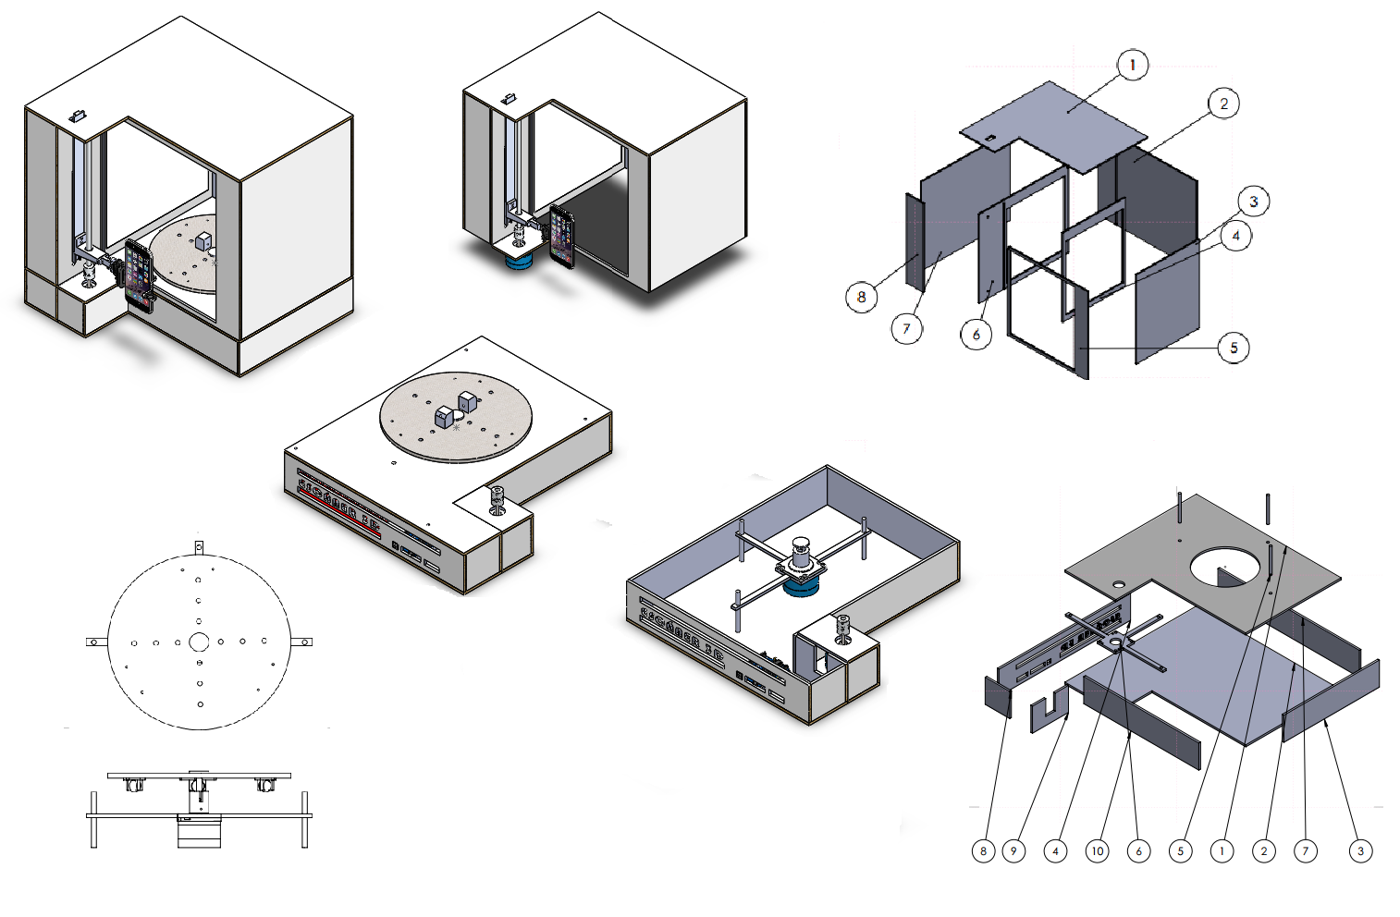
imagenes libro/resumen.png
