JavierPerez24/Escaner3D/imagenes libro/riel.PNG

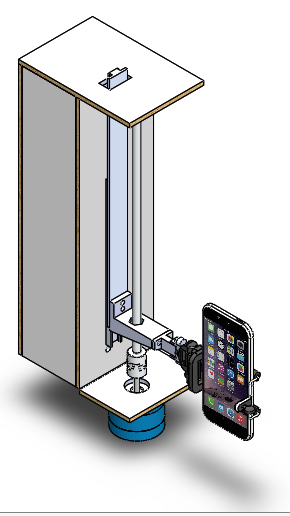
imagenes libro/riel.PNG
