JavierPerez24/Escaner3D/imagenes libro/rieles.PNG

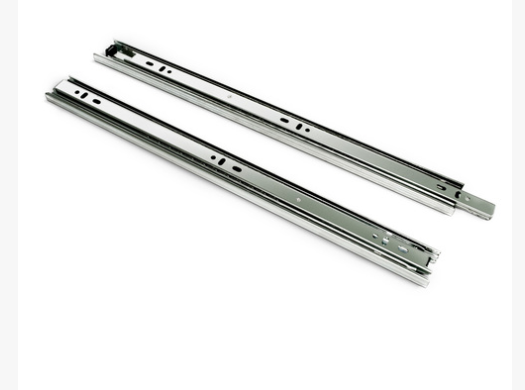
imagenes libro/rieles.PNG
