JavierPerez24/Escaner3D/imagenes libro/rodamiento 1.PNG

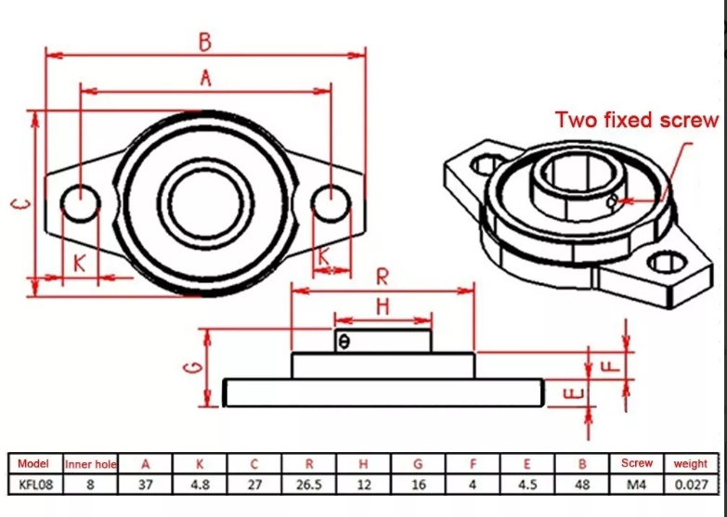
imagenes libro/rodamiento 1.PNG
