JavierPerez24/Escaner3D/imagenes libro/rodamiento 2.PNG

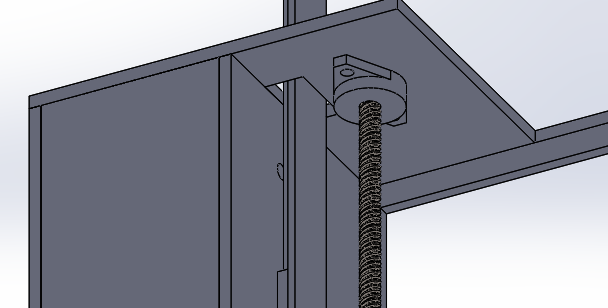
imagenes libro/rodamiento 2.PNG
