JavierPerez24/Escaner3D/imagenes libro/rosca1.PNG

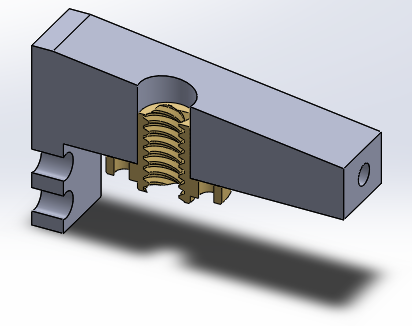
imagenes libro/rosca1.PNG
