JavierPerez24/Escaner3D/imagenes libro/rosca2.PNG

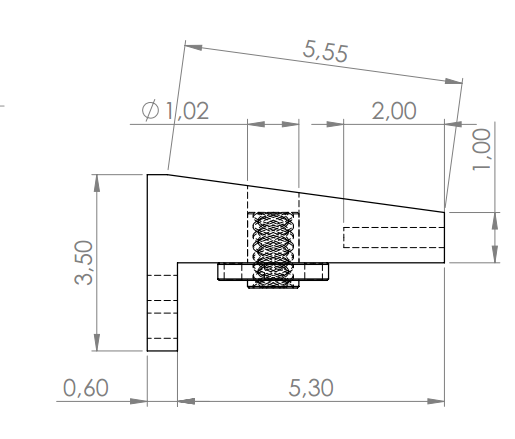
imagenes libro/rosca2.PNG
