JavierPerez24/Escaner3D/imagenes libro/rosca3.PNG

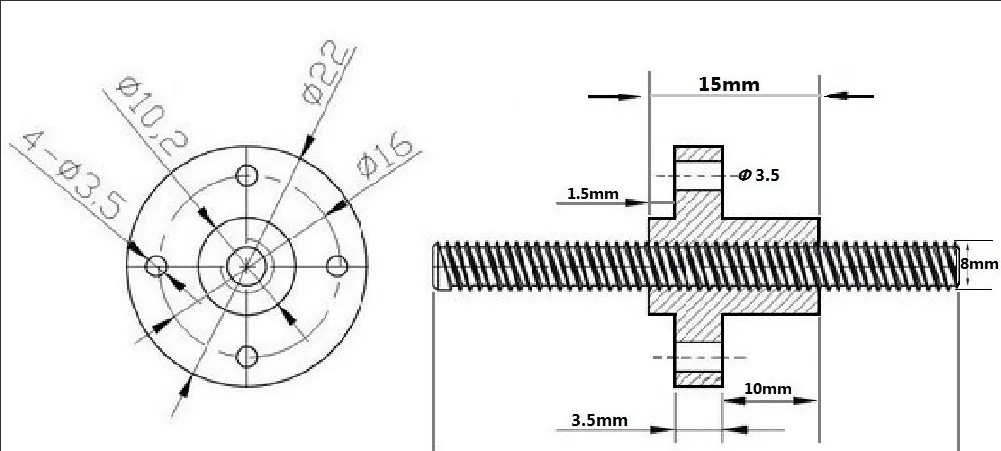
imagenes libro/rosca3.PNG
