JavierPerez24/Escaner3D/imagenes libro/rueda loca.PNG

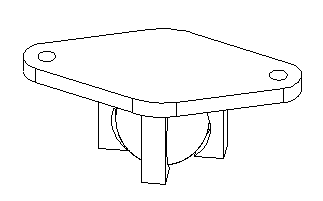
imagenes libro/rueda loca.PNG
