JavierPerez24/Escaner3D/imagenes libro/segmentacion.PNG

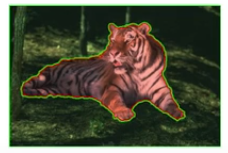
imagenes libro/segmentacion.PNG
