JavierPerez24/Escaner3D/imagenes libro/SFM.PNG

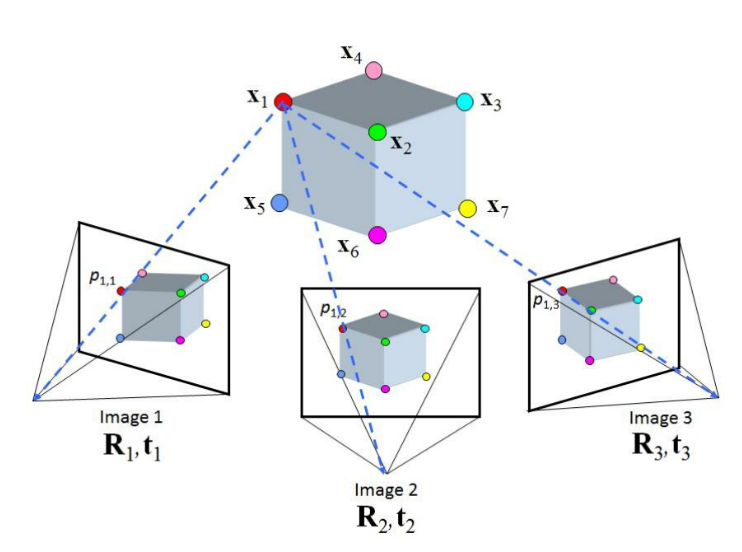
imagenes libro/SFM.PNG
