JavierPerez24/Escaner3D/imagenes libro/Sift.PNG

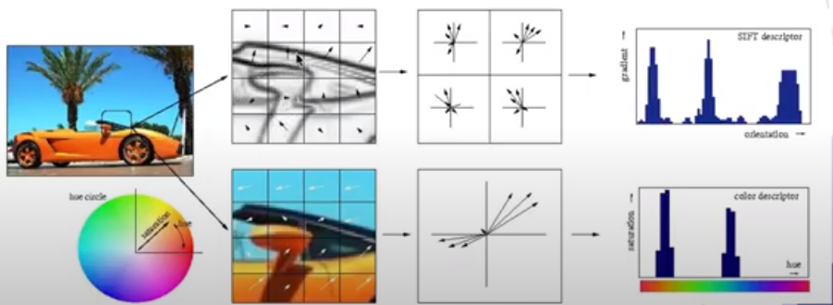
imagenes libro/Sift.PNG
