JavierPerez24/Escaner3D/imagenes libro/superior explo.PNG

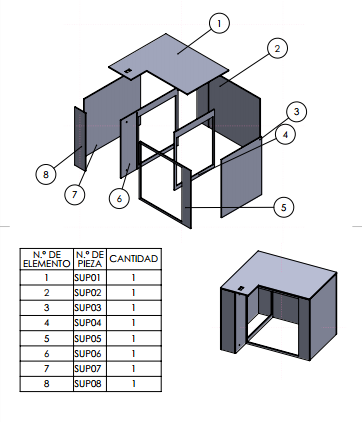
imagenes libro/superior explo.PNG
