JavierPerez24/Escaner3D/imagenes libro/supexplo.PNG

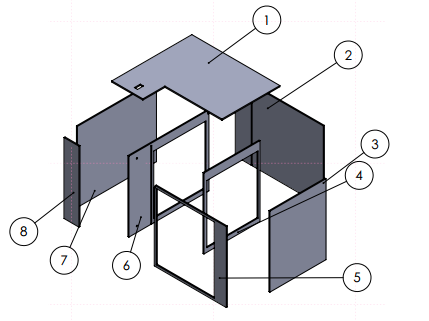
imagenes libro/supexplo.PNG
