JavierPerez24/Escaner3D/imagenes libro/Tecnicas de iluminación.PNG

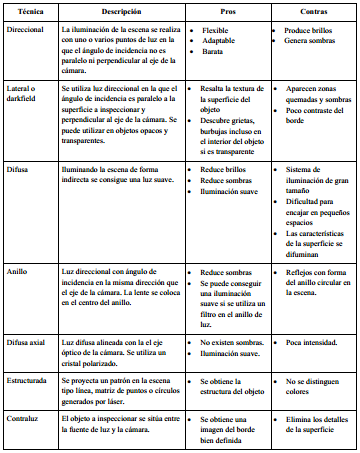
imagenes libro/Tecnicas de iluminación.PNG
