JavierPerez24/Escaner3D/imagenes libro/tipos de iluminación.PNG

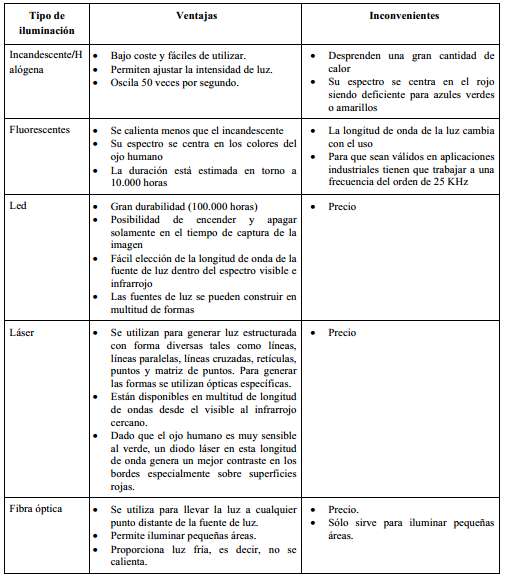
imagenes libro/tipos de iluminación.PNG
