JavierPerez24/Escaner3D/imagenes libro/vision estereo geometria.PNG

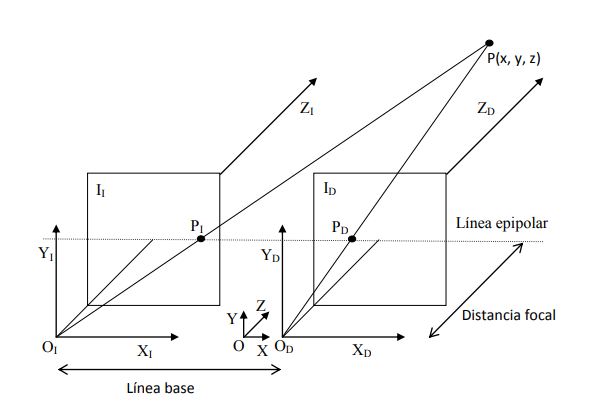
imagenes libro/vision estereo geometria.PNG
