JavierPerez24/Escaner3D/imagenes libro/VisualB.PNG

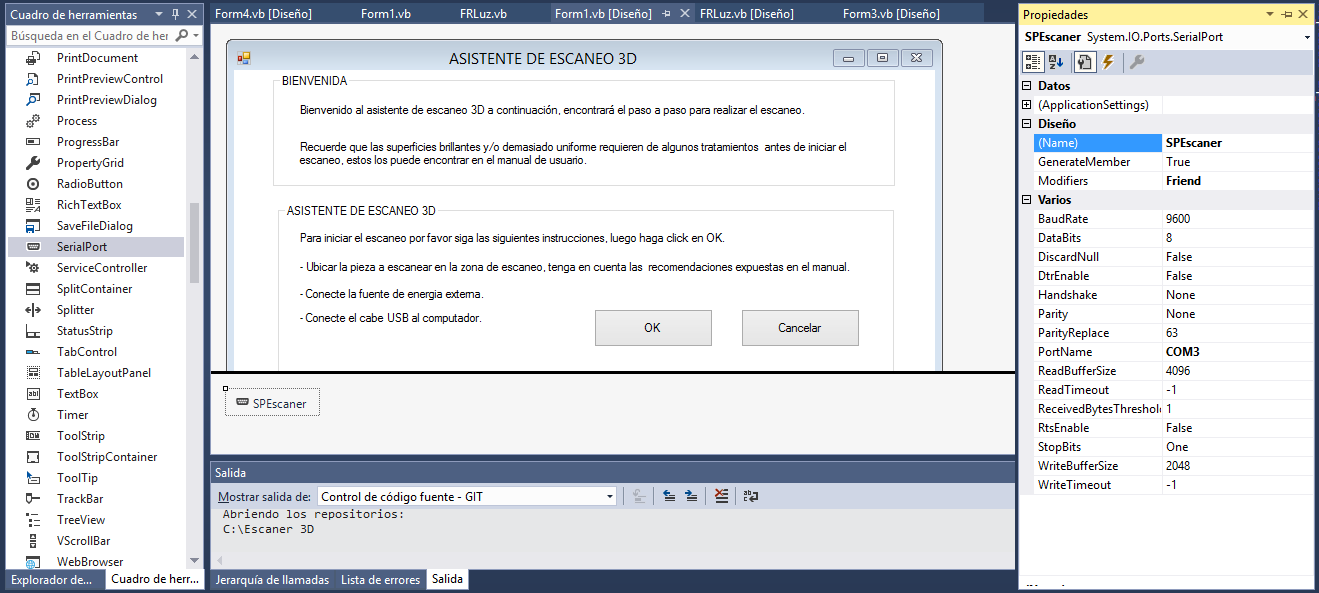
imagenes libro/VisualB.PNG
