JavierPerez24/Escaner3D/imagenes libro/WhatsApp Image 2019-11-23 at 7.57.34 PM.jpeg

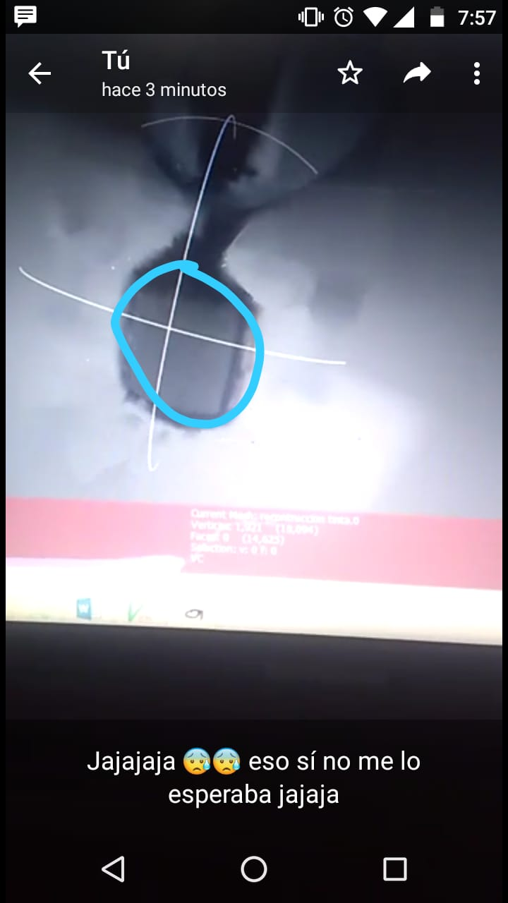
imagenes libro/WhatsApp Image 2019-11-23 at 7.57.34 PM.jpeg
