JavierPerez24/Escaner3D/imagenes libro/WhatsApp Image 2019-11-23 at 8.09.55 PM.jpeg

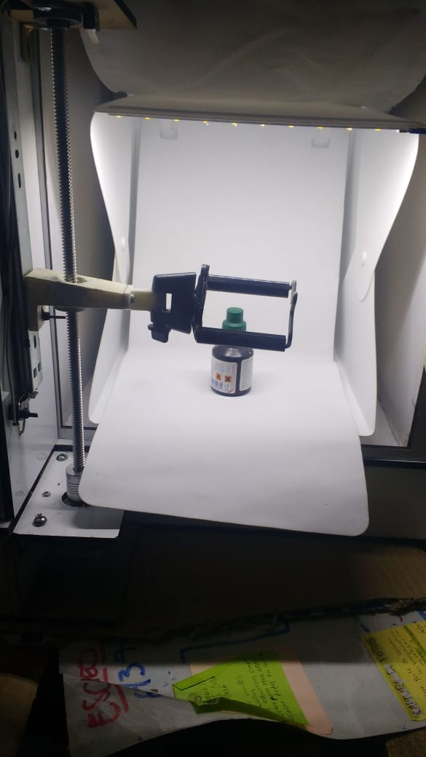
imagenes libro/WhatsApp Image 2019-11-23 at 8.09.55 PM.jpeg
