JavierPerez24/Escaner3D/Entrega/Anexos TG/ANEXO 1 MANUAL DE CONSTRUCCIÓN, PLANOS Y COMPONENTES ESTRUCTURALES.pdf

# MONTAJE FÍSICO PARA

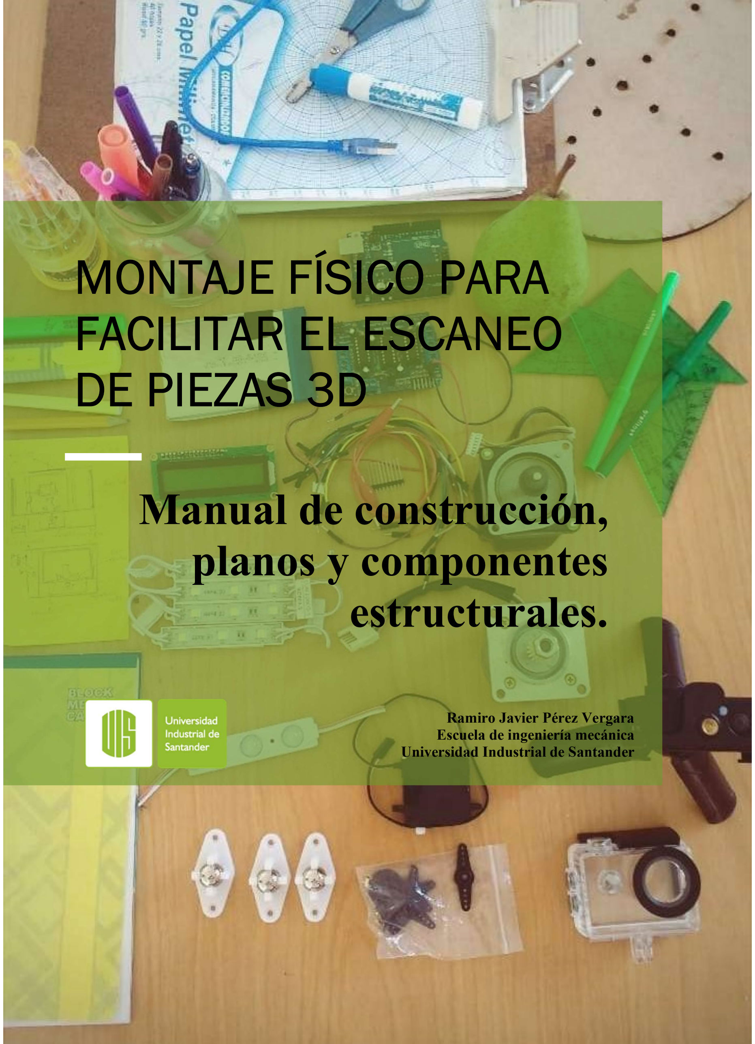
[picture p171: page 1]

1

Manual de construcción,

# planos y componentes

estructurales.

# FACILITAR EL ESCANEO DE PIEZAS 3D

Ramiro Javier Pérez Vergara Escuela de ingeniería mecánica Universidad Industrial de Santander

# MONTAJE FÍSICO PARA FACILITAR EL ESCANEO DE PIEZAS 3D

Consideraciones

En este documento se registran los planos utilizados para la construcción del módulo físico utilizado

para cumplir los objetivos del trabajo de grado para optar por el título de Ingeniero mecánico titulado

DISEÑO Y CONSTRUCCIÓN DE UN MONTAJE FÍSICO E INFORMÁTICO QUE

FACILITE EL ESCANEO DE PIEZAS 3D MEDIANTE FOTOGRAFÍAS PARA REALIZAR

TAREAS DE INGENIERÍA INVERSA EN UN ENTORNO CAD.

- Se presentarán vistas del dispositivo completo y ensamblado, posteriormente dividido en

módulos para observar con detalle cada una de las partes y componentes, mediante planos en

escala real utilizados para el proceso de corte laser, explosionados y planos acotados.

- Utilice los planos sin cotas en escala 1:1 para cortar sobre MDF de 3,5mm las partes para

construir la estructura, arme cada uno de los módulos según lo expuesto a continuación.

Modelo ensamblado

Figura 1
Ensamblaje final

Figura 2

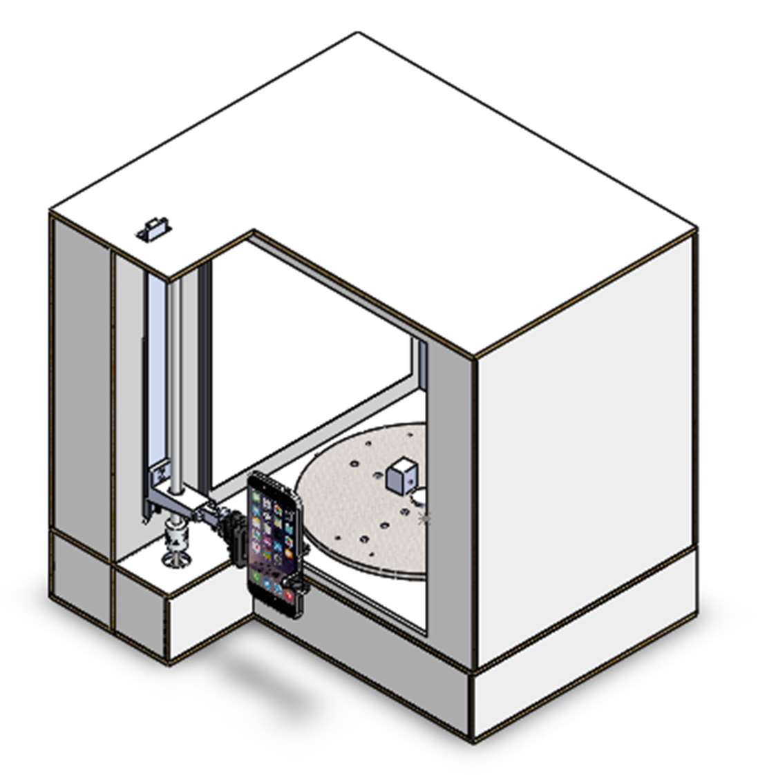
[picture p172: figure]

Detalle elementos de sujeción

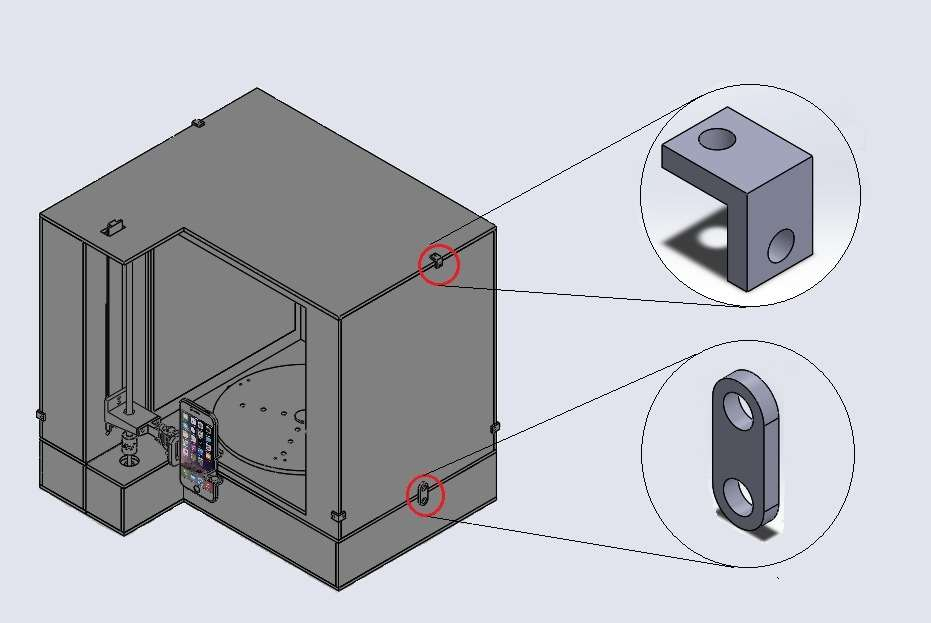
[picture p173: figure]

Nota. se utilizó pegamento y chapas metálicas en ángulo recto para unir las piezas de cada módulo,

la unión entre el modulo superior e inferior se hace por medio de una chapa metálica plana.

MÓDULO SUPERIOR

Figura 3 Módulo superior

Estructura

Figura 4 Estructura

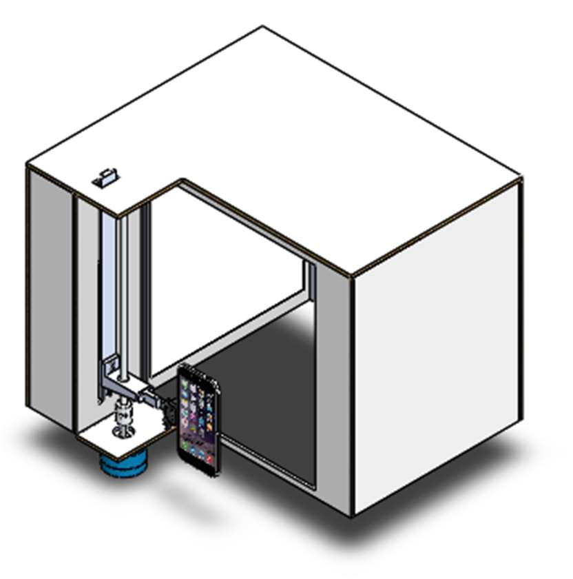
[picture p174: figure]
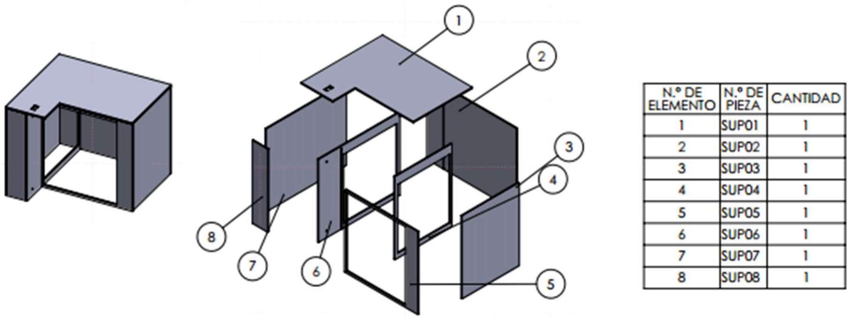
[picture p175: figure]

Planos para corte:

1

2

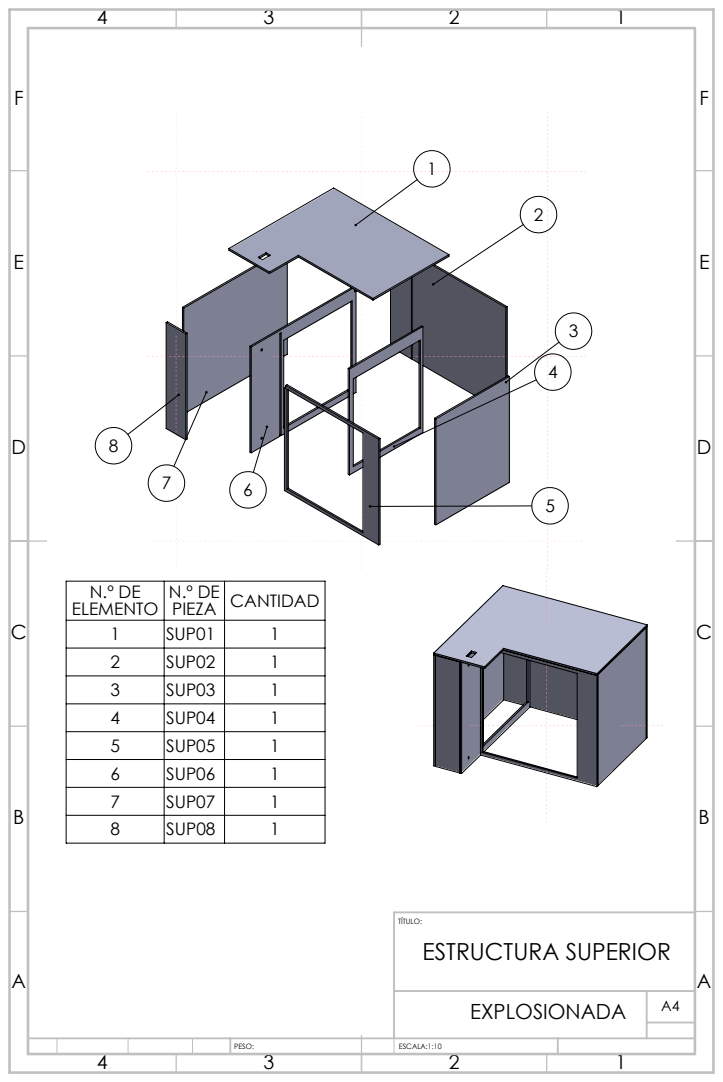
[picture p176: page 5]
TÍTULO:; ESCALA:1:10; PESO:; ESTRUCTURA SUPERIOR; EXPLOSIONADA

N.º DE ELEMENTO | N.º DE PIEZA | CANTIDAD
1 | SUP01 | 1
2 | SUP02 | 1
3 | SUP03 | 1
4 | SUP04 | 1
5 | SUP05 | 1
6 | SUP06 | 1
7 | SUP07 | 1
8 | SUP08 | 1

A | A
B | B
C | C
D | D
E | E
F | F
G | G
H | H
J | J
K | K
L | L
M | M
N | N
P | P
R | R
T | T

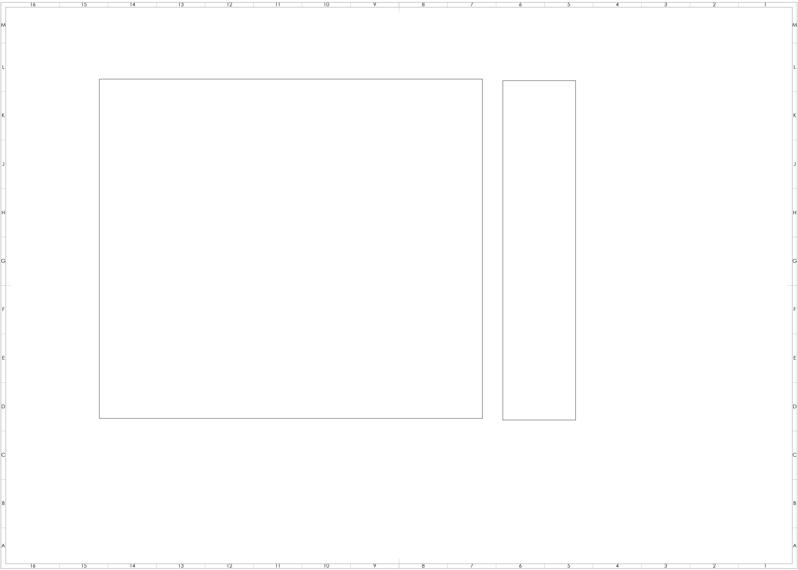
[picture p177: figure]

E | E
F | F

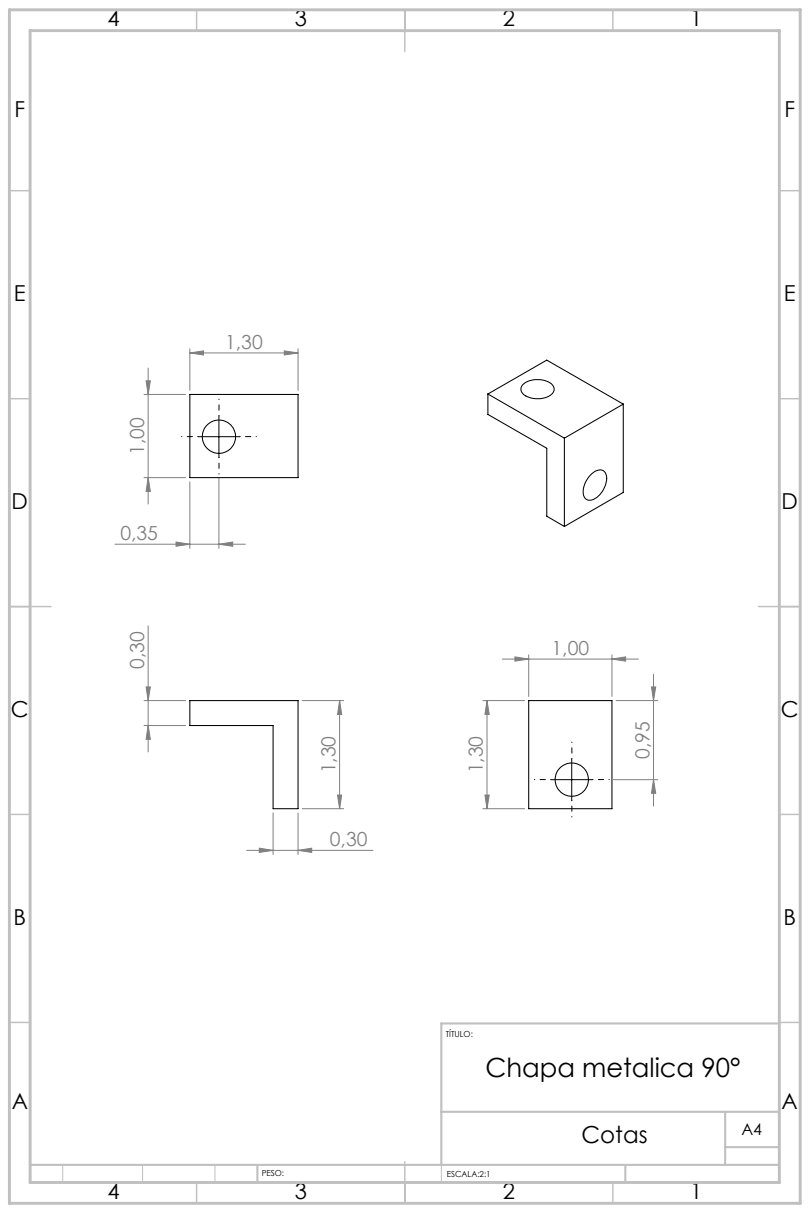
[picture p178: page 8]
TÍTULO:; ESCALA:2:1; PESO:; Chapa metalica 90°; Cotas

Riel de desplazamiento vertical

Figura 5 Riel de desplazamiento vertical

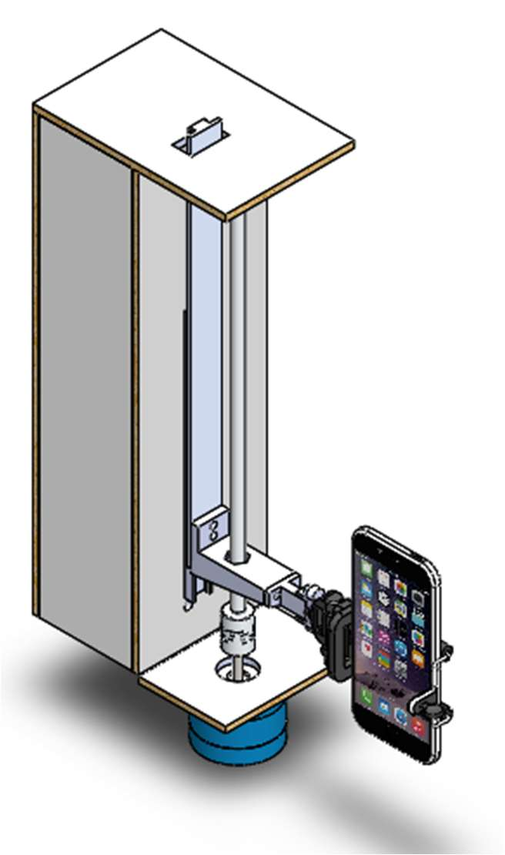
[picture p179: figure]

Detalles de construcción:

Figura 6 Riel guía extensible 45 cm

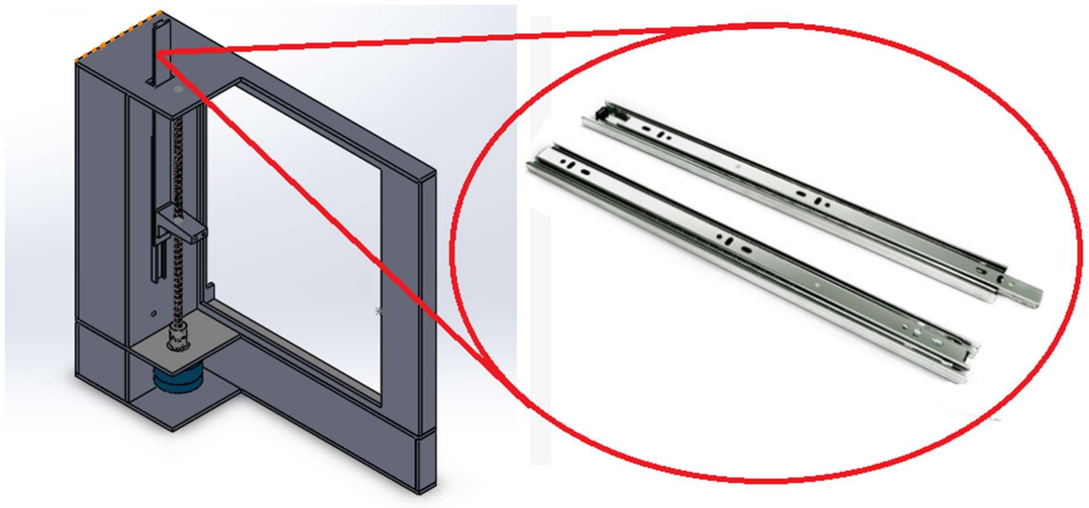
[picture p180: figure]
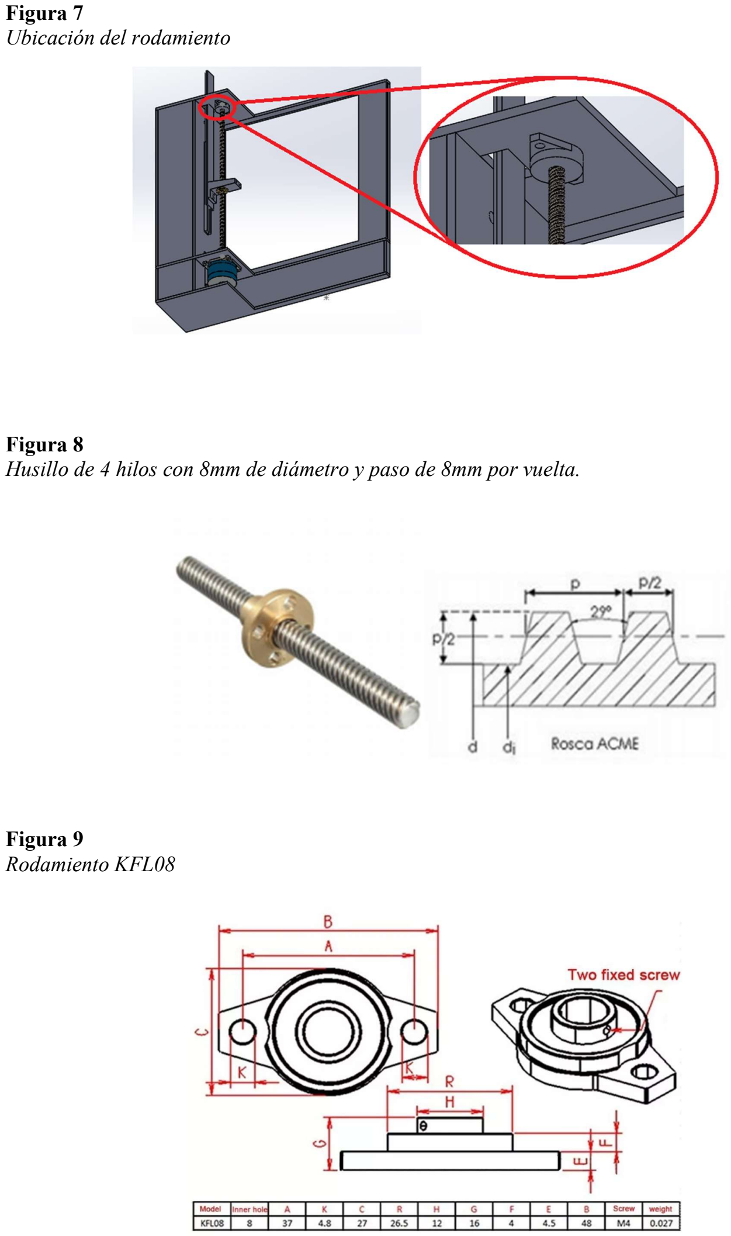
[picture p181: page 10]

Figura 7 Ubicación del rodamiento

Figura 8
Husillo de 4 hilos con 8mm de diámetro y paso de 8mm por vuelta.

Figura 9 Rodamiento KFL08

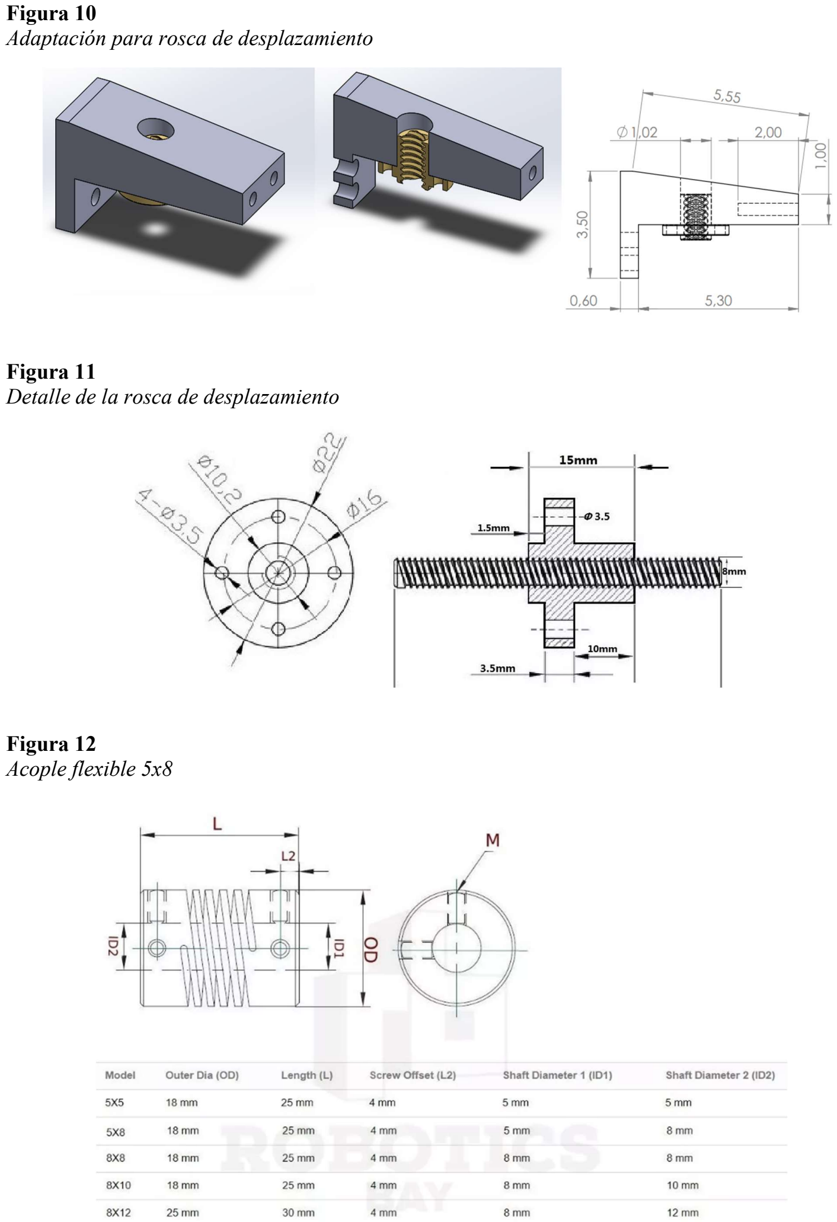
[picture p182: page 11]

Figura 10 Adaptación para rosca de desplazamiento

Figura 11 Detalle de la rosca de desplazamiento

Figura 12
Acople flexible 5x8

Figura 13
Detalle piezas para base del celular.

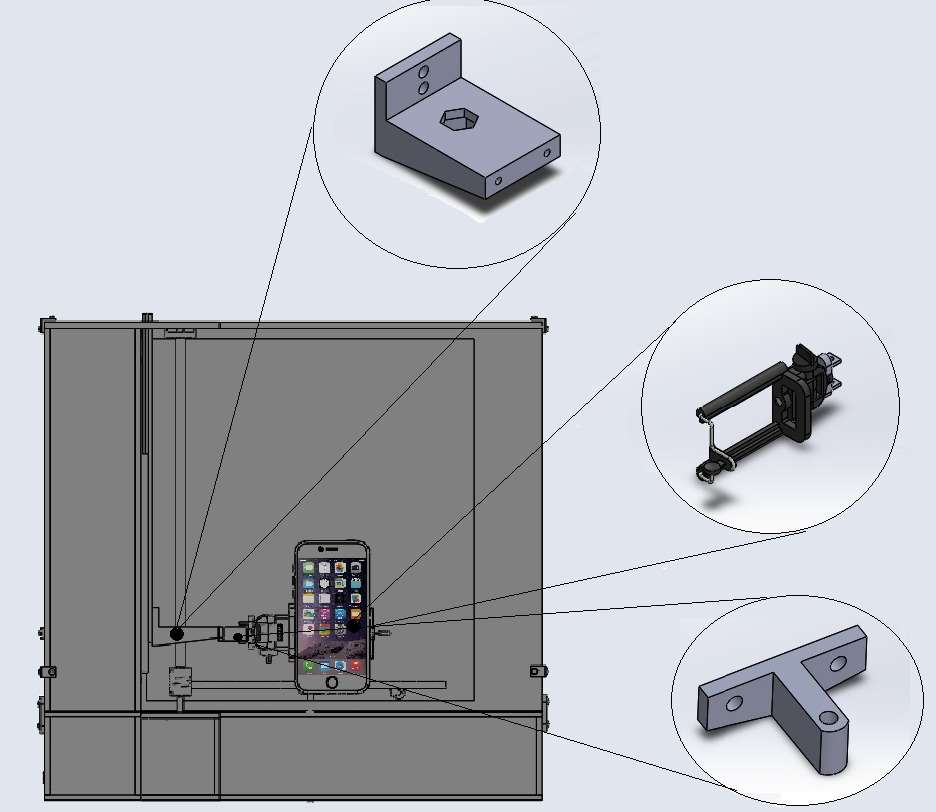
[picture p183: figure]

Resumen de piezas y componentes módulo superior

| Estructura | | Riel de desplazamiento vertical
1 | SUP01 | 1 | Riel guía extensible 45cm
1 SUP02 | 2 tornillos cabeza plana
1 | SUP03 | 1 | Rodamiento KFL08
1 SUP04 | 1 Adaptación para rosca de desplazamiento
1 | SUP05 | 1 | Rosca de desplazamiento
1 SUP06 | 1 Unión a base del celular
1 | SUP07 | 1 | Base comercial para celular, selfie Stick
1 SUP08 | 1 Husillo de 4 hilos, 8mm de diámetro
3 | Chapa metálica 90° | 1 | Acople flexible 5x8

### 2 Filtro de tela blanca 14 Tornillo M4x15 2 Tornillo autoperforante #8 1/2''

5,30
0,75

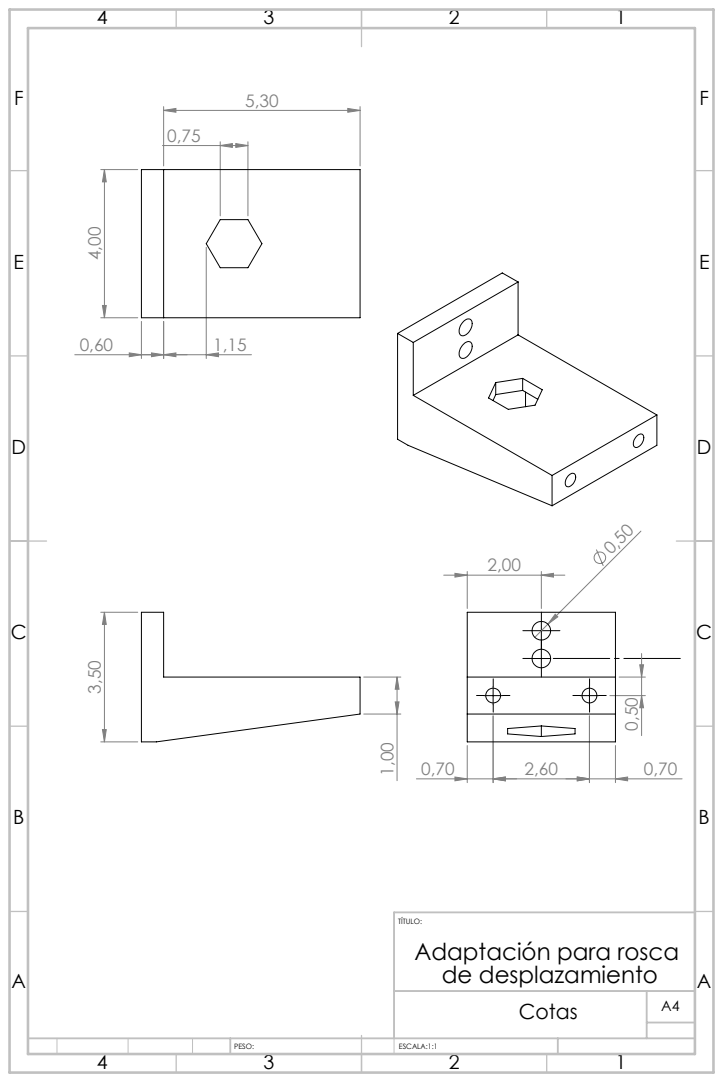
[picture p184: page 13]
PESO:

TÍTULO:
Adaptación para rosca
de desplazamiento
Cotas

0,40 | 2,07
E | E

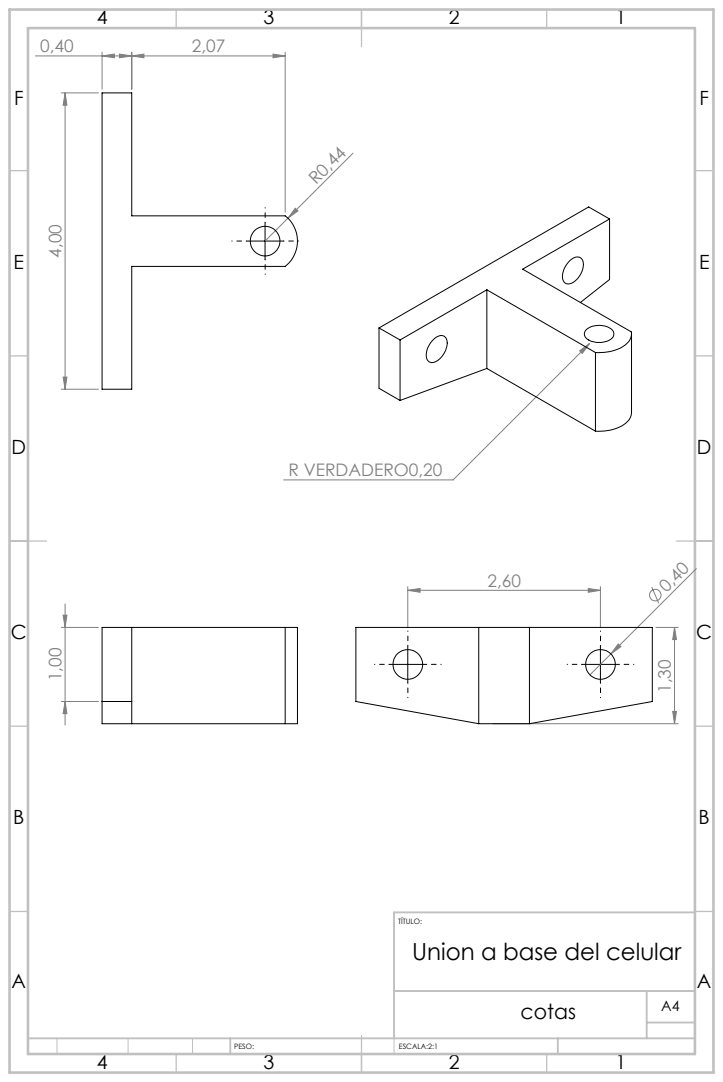
[picture p185: page 14]
R VERDADERO0,20; ESCALA:2:1; PESO:; cotas

TÍTULO:
Union a base del celular

E | E
F | F

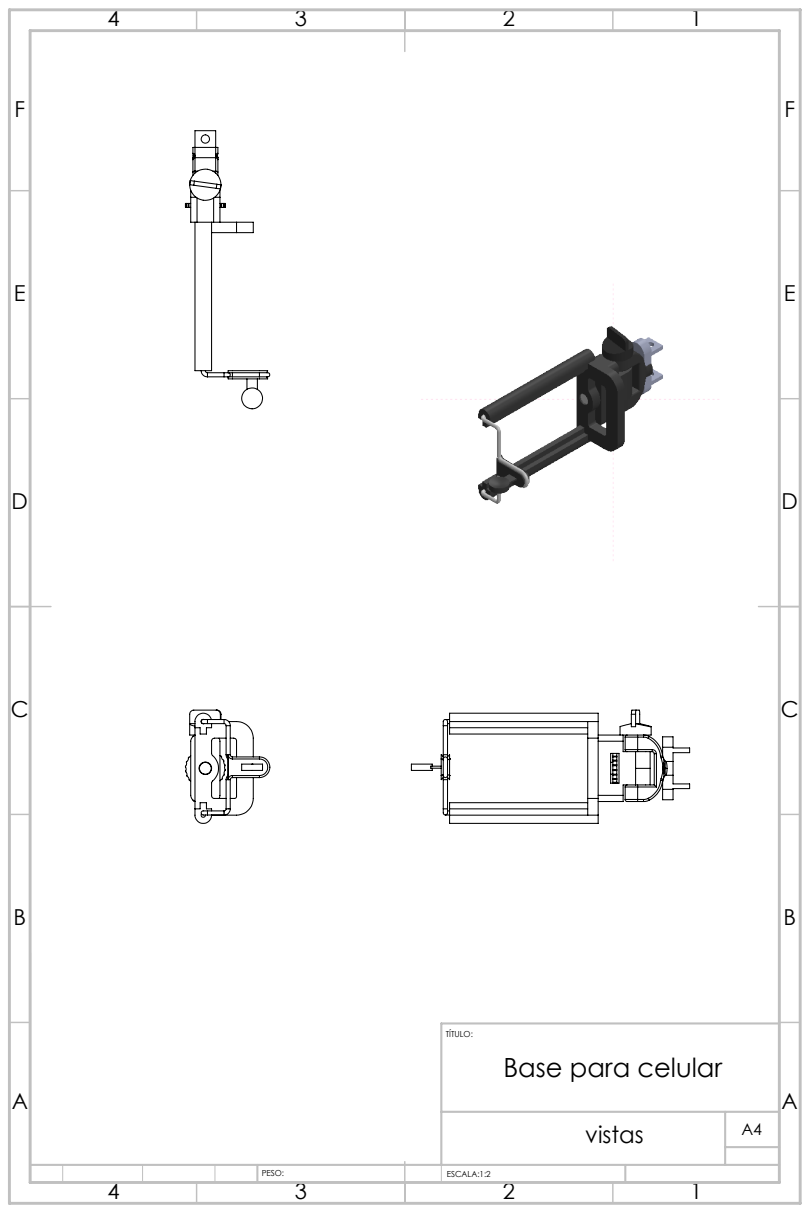
[picture p186: page 15]
PESO:; vistas

TÍTULO:
Base para celular

MÓDULO INFERIOR

Figura 14 Módulo inferior

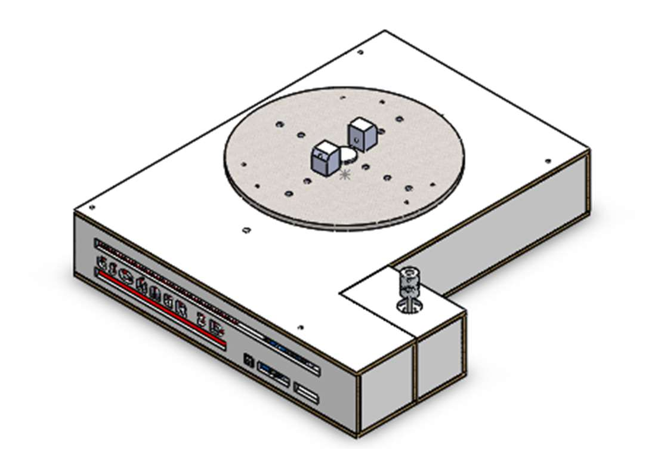
[picture p187: figure]

Estructura

Figura 15
Estructura

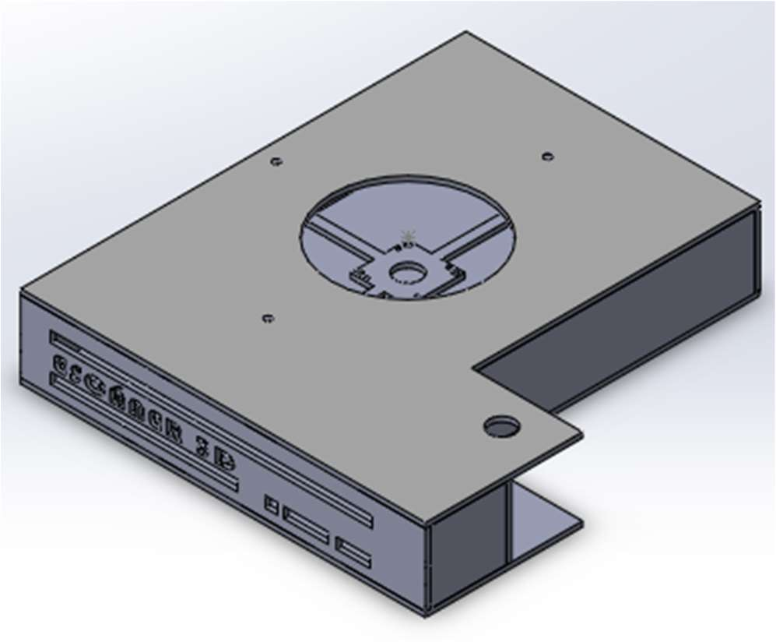
[picture p188: figure]

Planos para corte:

44,00
23,50

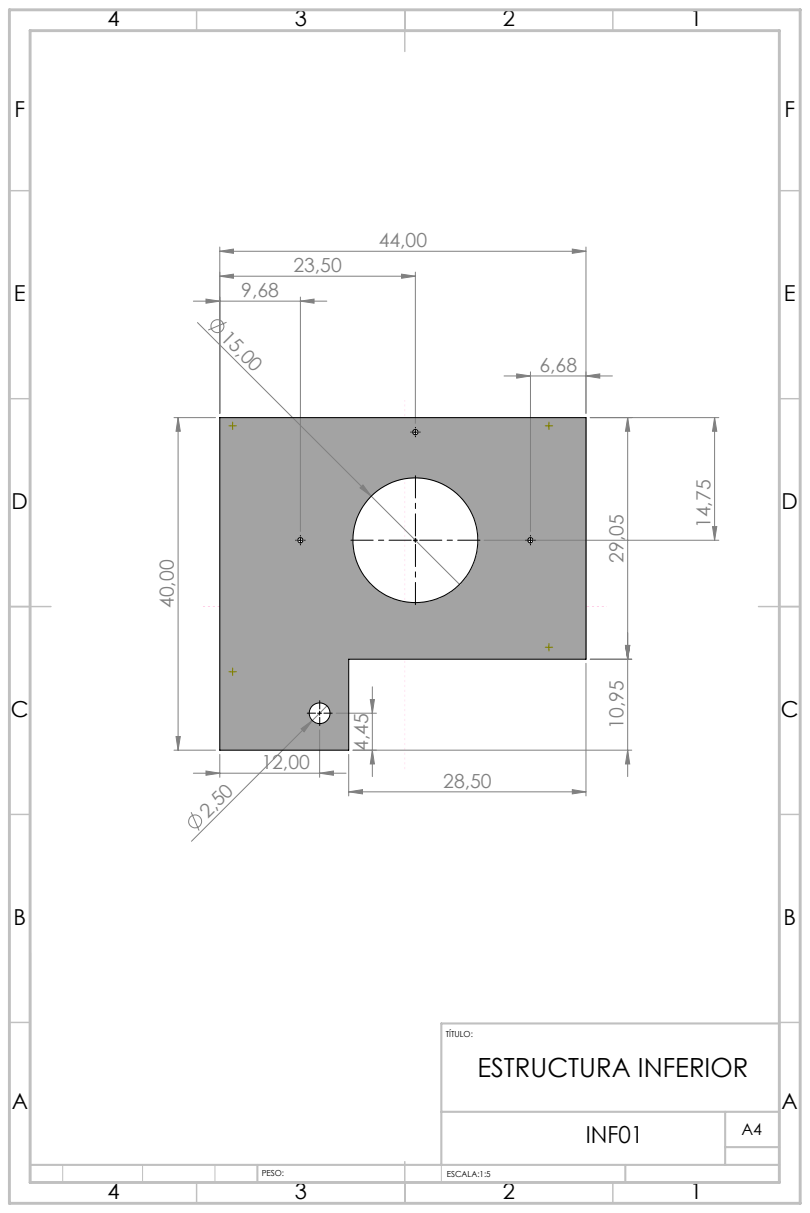
[picture p189: page 17]
TÍTULO:; PESO:; ESTRUCTURA INFERIOR; INF01

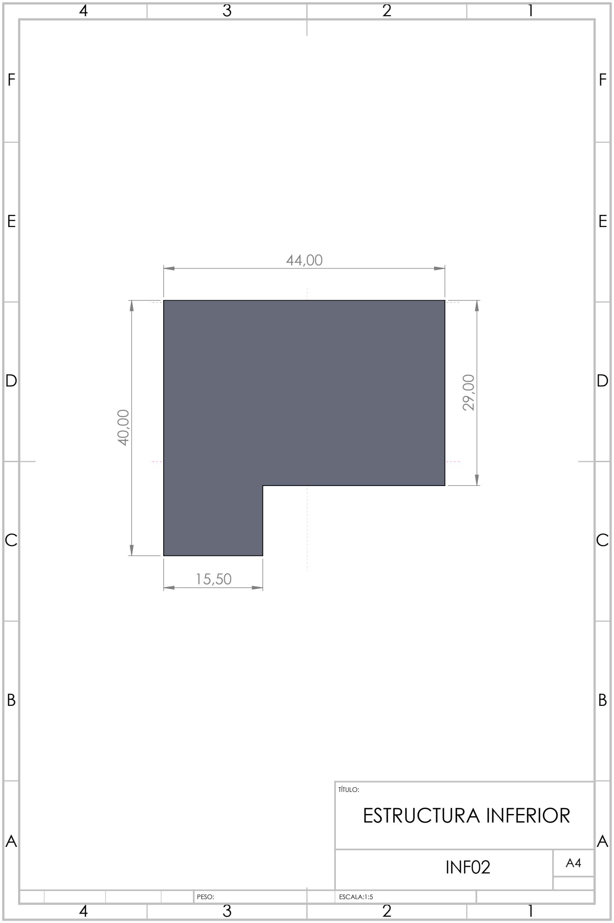
[picture p190: figure]
TÍTULO:; PESO:; ESTRUCTURA INFERIOR; INF02

29,05

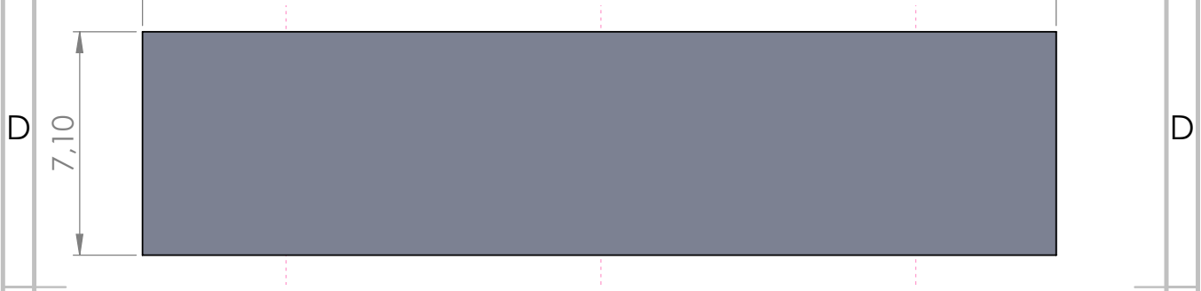
[picture p191: figure]

7,10

A | A
B | B
C | C
E | E
F | F

TÍTULO:

A4

PESO:

# ESTRUCTURA INFERIOR

# INF03

D | D

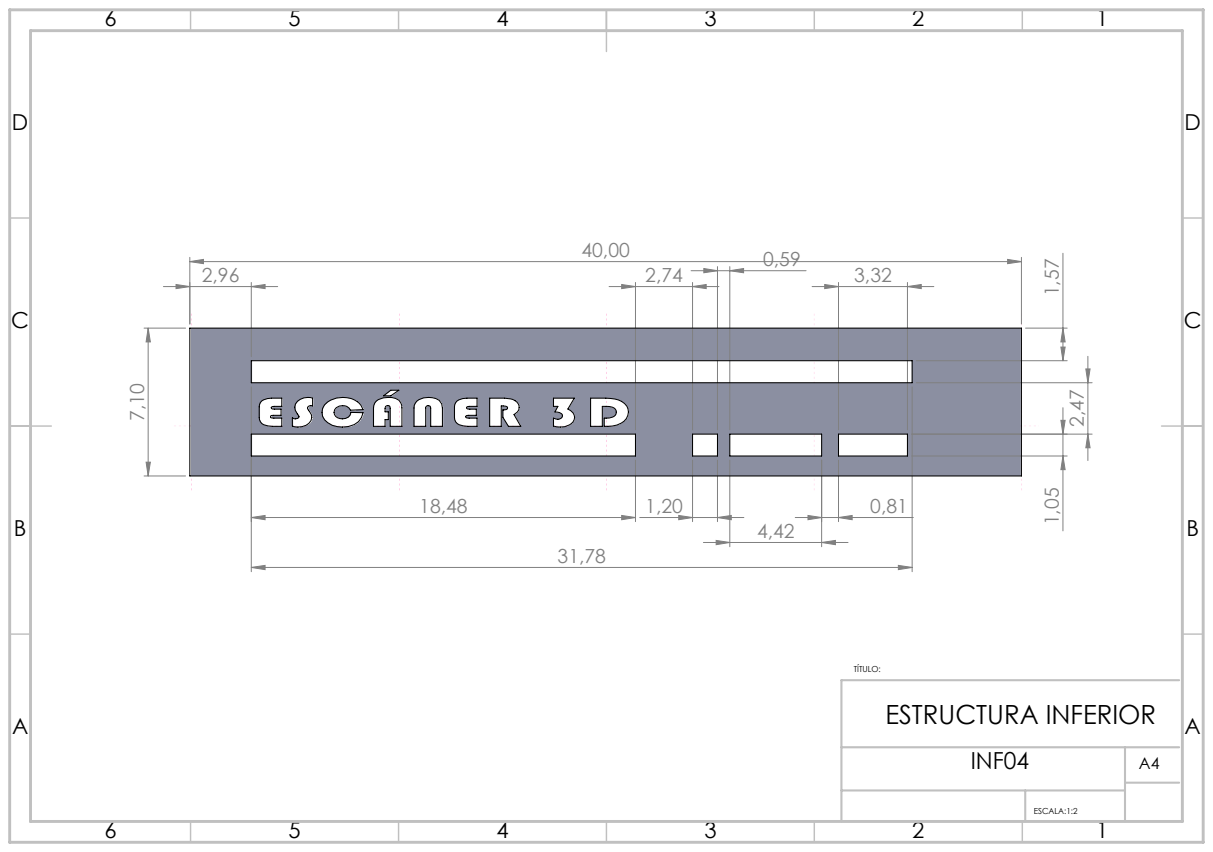
[picture p192: page 20]
TÍTULO:; ESTRUCTURA INFERIOR; INF04

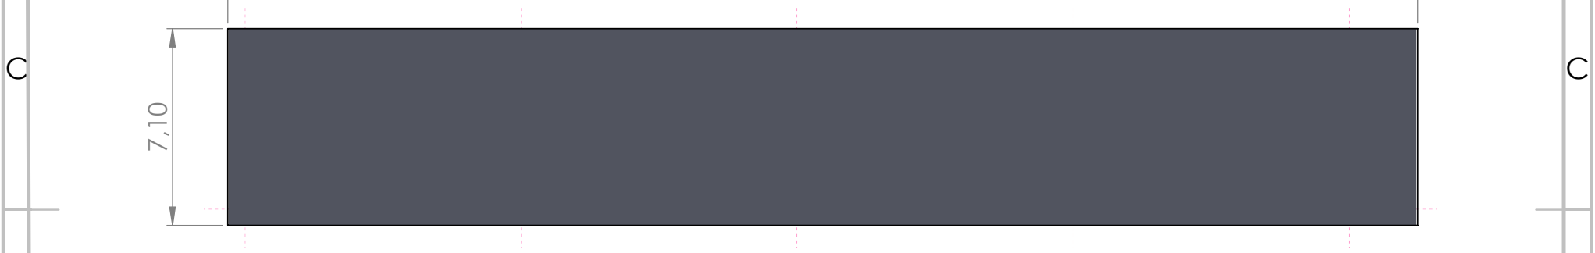
[picture p193: figure]

7,10

43,00

TÍTULO:

A4

# ESTRUCTURA INFERIOR

# INF07

A | A
B | B
D | D

7,50

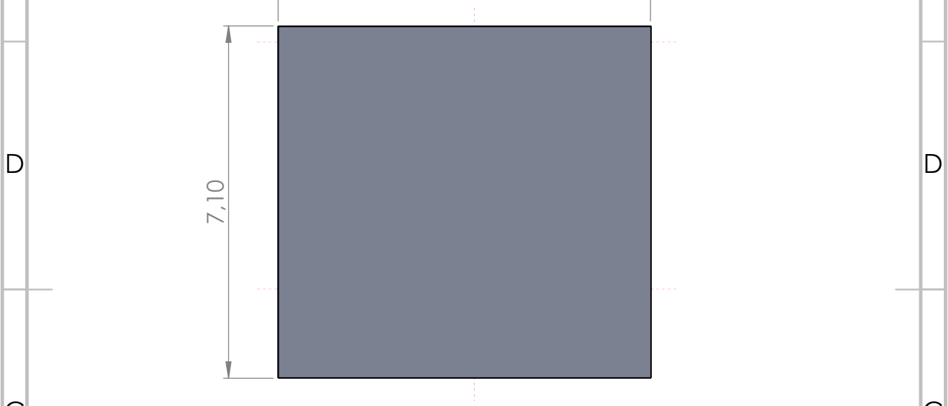
[picture p194: figure]

7,10

A | A
B | B
C | C
E | E
F | F

TÍTULO:

A4

PESO:

# ESTRUCTURA INFERIOR

# INF08

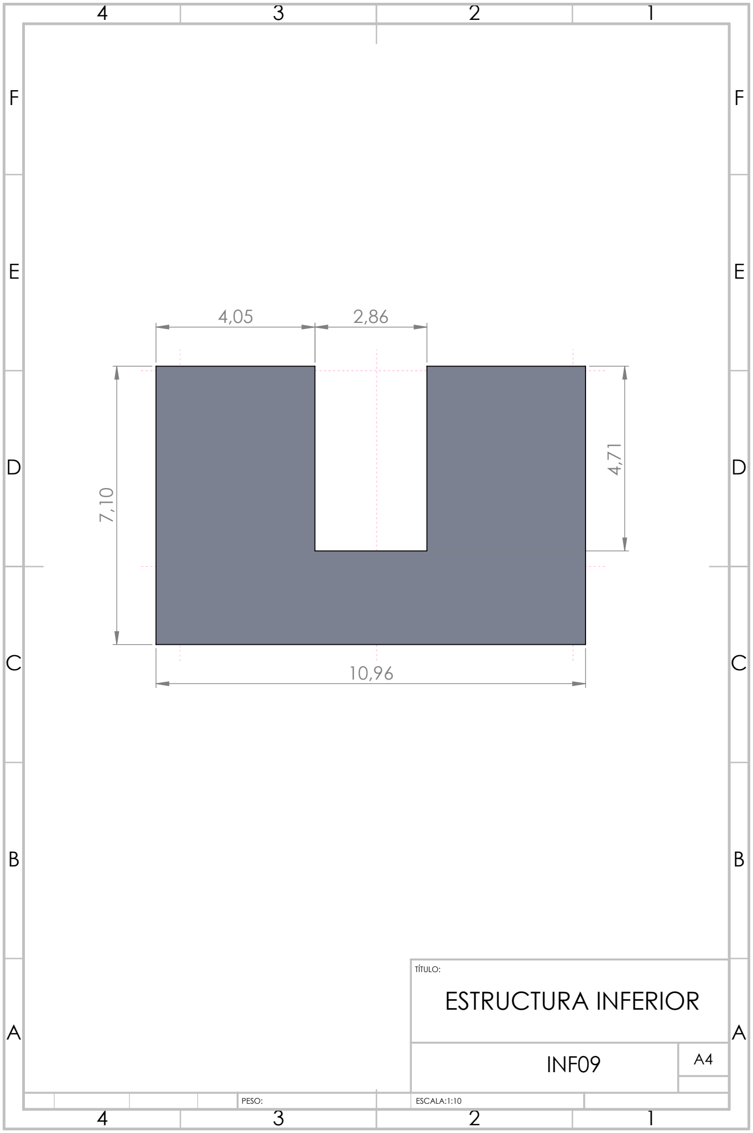
[picture p195: figure]
TÍTULO:; PESO:; ESTRUCTURA INFERIOR; INF09

35,00

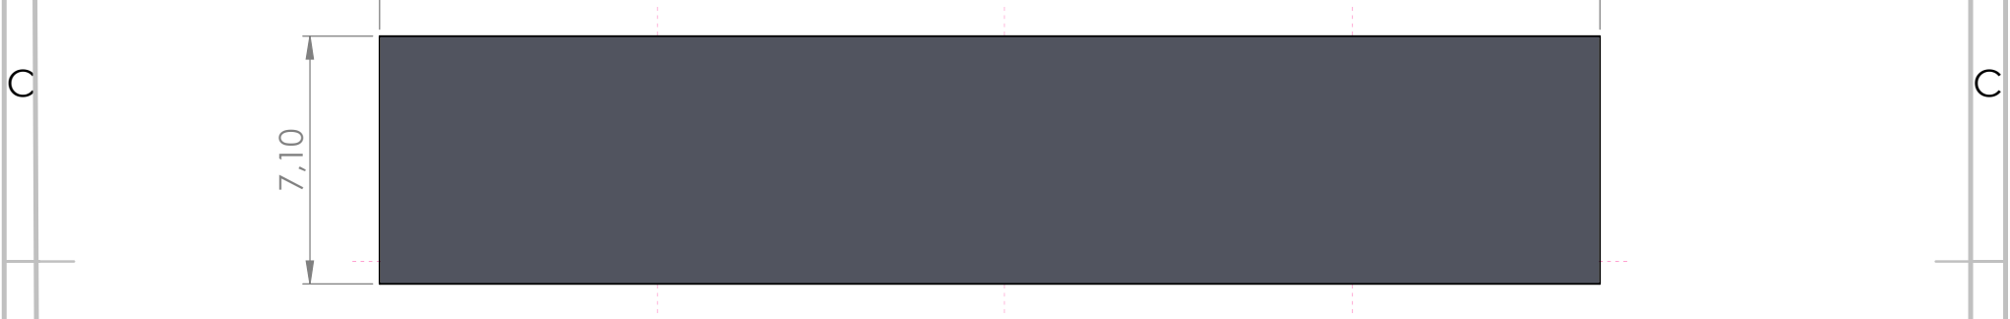
[picture p196: figure]

7,10

TÍTULO:

A4

# ESTRUCTURA INFERIOR

# INF10

A | A
B | B
D | D

Sistema de rotación

Figura 16
Sistema de rotación

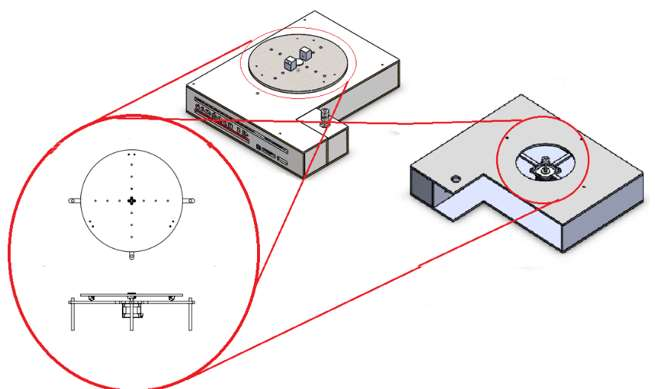
[picture p197: figure]

Detalles de construcción

Figura 17
Detalles plato giratorio

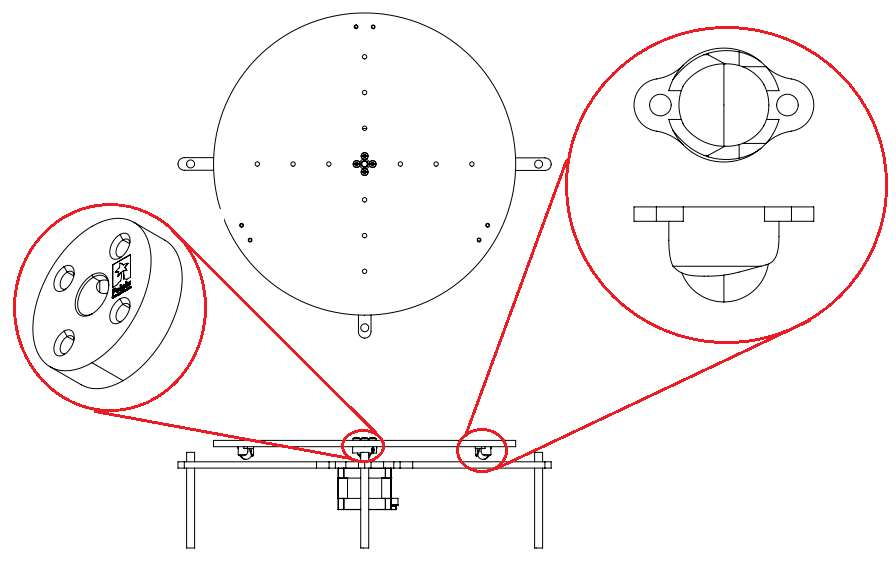
[picture p198: figure]

Nota. En detalle a la izquierda par hub 5mm, a la derecha rueda de apoyo

Planos para corte:

E | E
F | F

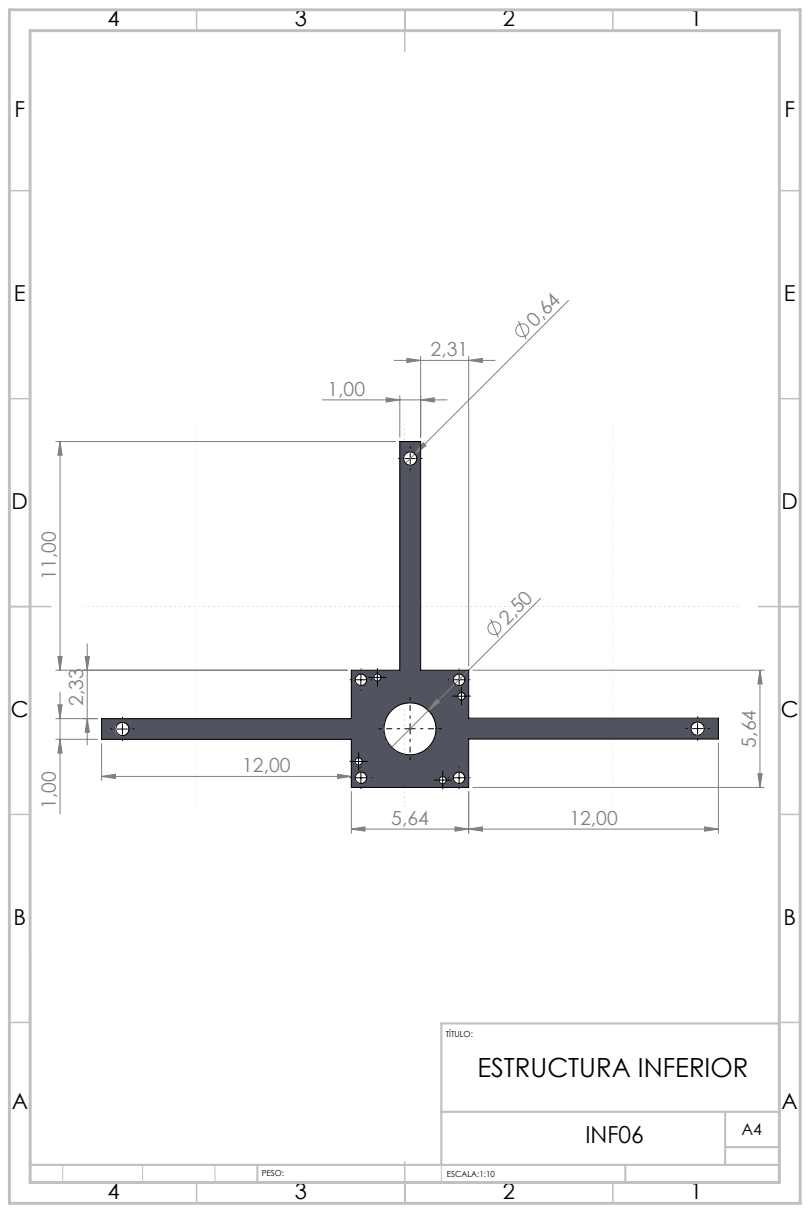
[picture p199: page 26]
TÍTULO:; PESO:; ESTRUCTURA INFERIOR; INF06

E

E

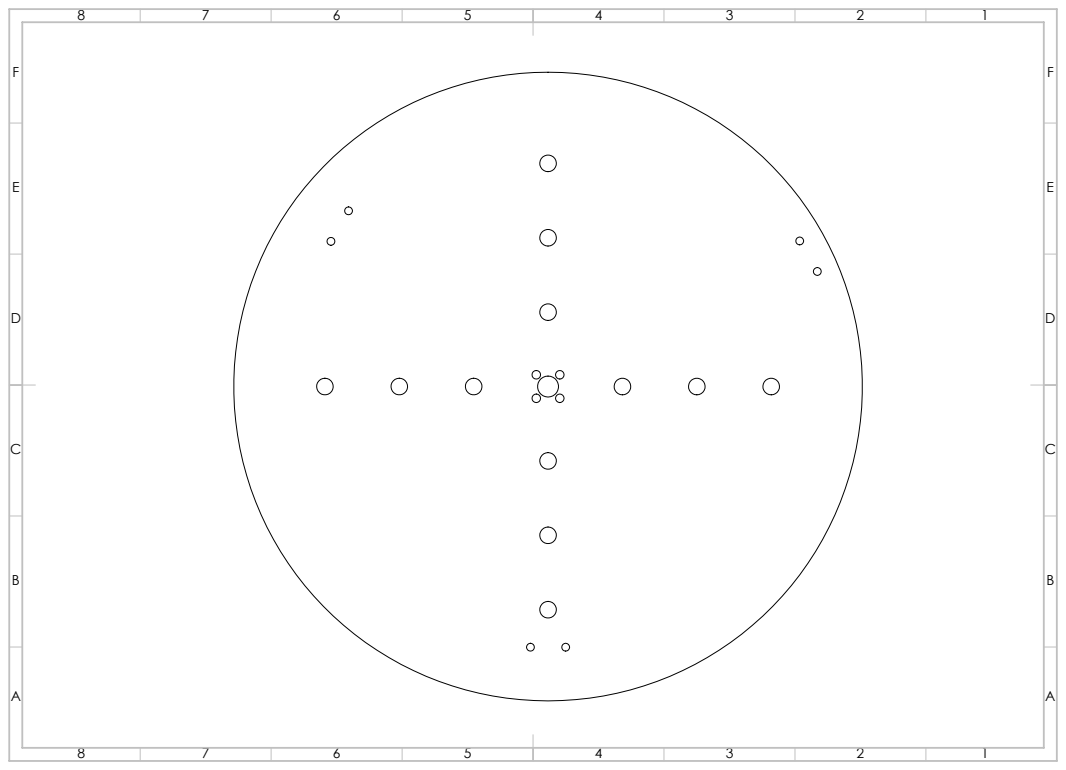
[picture p200: page 27]

Resumen de piezas y componentes módulo inferior

1 | INF01 | 1 | INF06
1 INF02 | 3 Tornillo cabeza hexagonal ¼’ x 2’
1 | INF03 | 1 | Plato perforado
1 INF04 | 1 Par hub 5mm
1 | INF05 | 3 | Ruedas de apoyo

### 1 INF07 1 INF08 1 INF09 1 INF10 2 Chapa metálica 90°
