JavierPerez24/Escaner3D/Modelado/mecanismo final escaner 3d.SLDASM

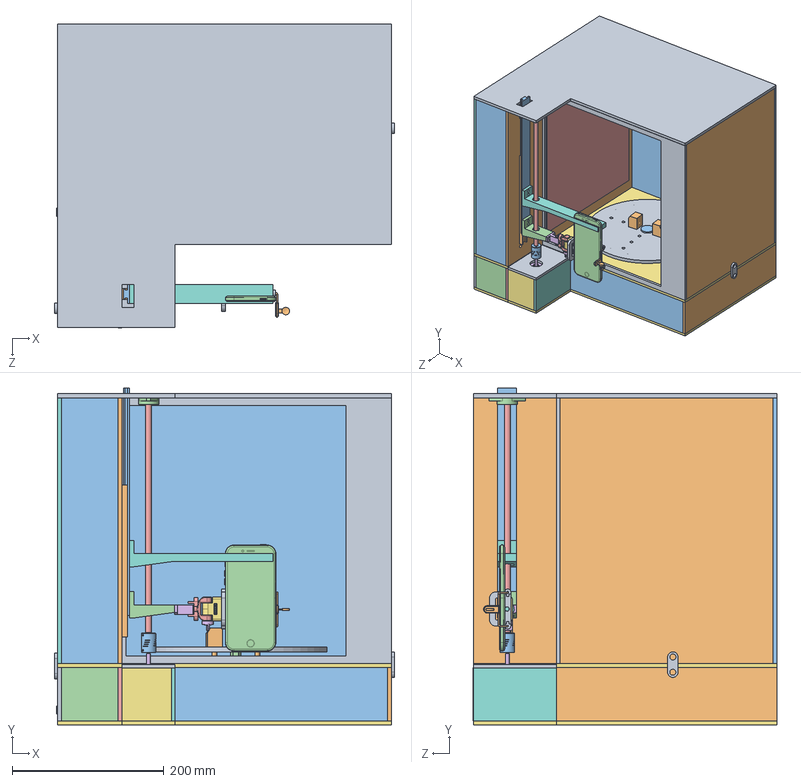
[picture p201: CAD file, 2020-03-01]
Modelado/mecanismo final escaner 3d.SLDASM
448.0 x 444.0 x 400.1 mm
gitproyectplato perforado
gitproyectbloque perforado x 2
gitproyectcentro plato
gitproyecttuerca1_4in
gitproyectacople 8mmx5mm
gitproyectNEMA Stepper x 2
gitproyectbase
gitproyectperno base motor x 3
A gitproyectfrontal
A gitproyectlateralderecha posiciones
A gitproyectposterior
gitproyectbase motor
gitproyectArduino UNO
gitproyectbase arduino
gitproyectbase mecanismo final
A gitproyectlateral ensamblajefinal
gitproyectparedbase
gitproyectlateral base derecha
gitproyectfrontal base
gitproyectfrontalpeqbase
gitproyectpared base
gitproyectposterior base
gitproyectbase motor tornillo
gitproyectlateral motor tornillo
gitproyectsuperior base motor tornillo
gitproyectguia riel
gitproyectRiel
gitproyectrosca con guia
gitproyecttornillo cnc
gitproyectpieza para celular
gitproyectfrontal motor cnc
A gitbase superior
SUP03
SUP08
iphone
pivot
clé de serrage
attache pivot
vis
support 1
support 2
Copple Flexible 5mm-8mm
rodamiento
difusor
SUP04
Pieza3
chapas x 2
