JavierPerez24/Escaner3D/Modelado/traslacion/Ensamblaje con riel.SLDASM

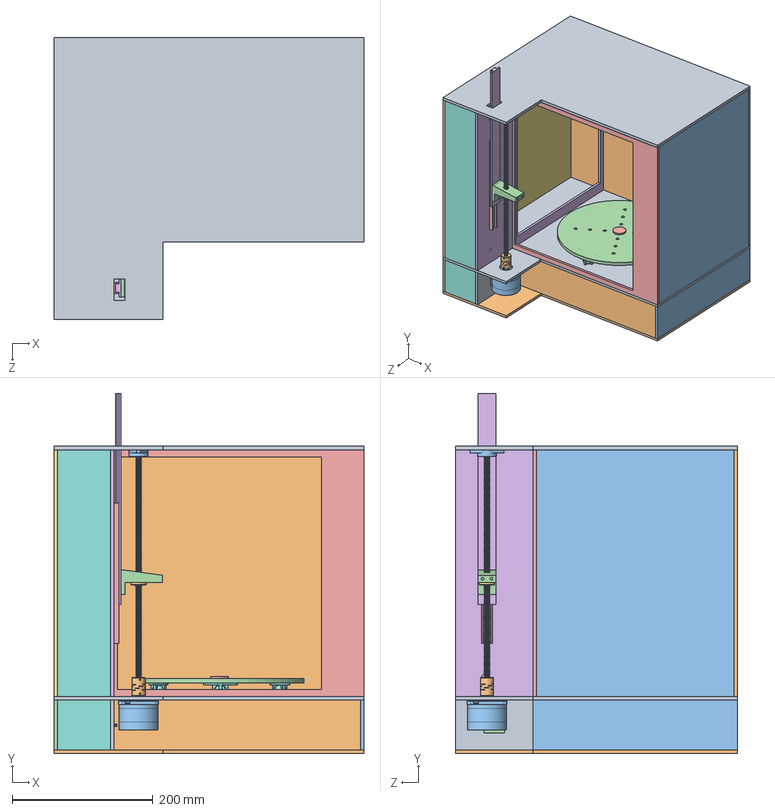
[picture p202: CAD file, 2020-02-08]
Modelado/traslacion/Ensamblaje con riel.SLDASM
440.0 x 511.3 x 400.0 mm
INF01
INF02
INF03
INF04
PERNO 8mm x 3
INF06
INF07
INF08
INF09
gitproyectNEMA Stepper x 2
gitproyectplato perforado
gitproyectcentro plato
ejemotor
acople motor pieza
rueda loca x 3
SUP02
SUP03
SUP04
SUP05
SUP06
SUP07
SUP08
Husillo ACME 5-16 (4 cuerdas) (200mm)
Copple Flexible 5mm-8mm
rodamiento
base rosca
gitproyectguia riel
gitproyectRiel
Tuerca ACME 5-16 (4 cuerdas)
SUP01
