JavierPerez24/Escaner3D/Modelado/traslacion/rosca.SLDASM

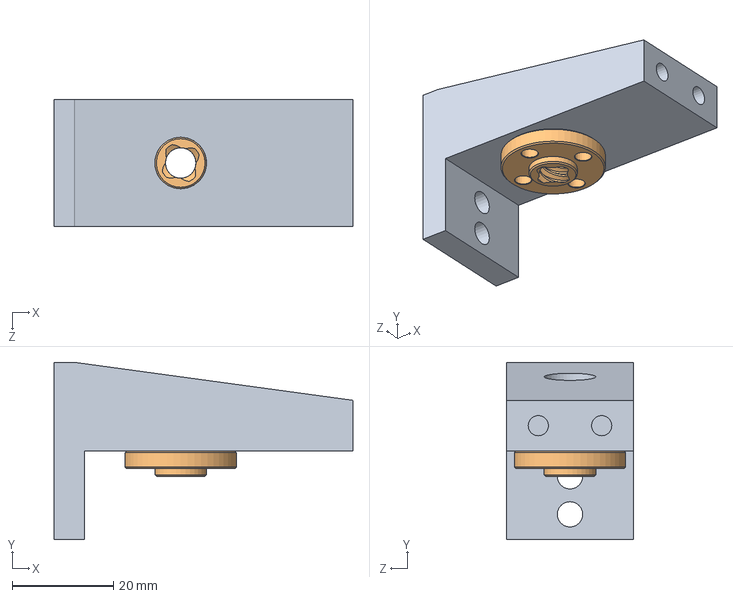
[picture p203: CAD file, 2019-11-04]
Modelado/traslacion/rosca.SLDASM
59.0 x 35.0 x 25.0 mm
base rosca
Tuerca ACME 5-16 (4 cuerdas)
