JavierPerez24/Escaner3D/Modelado/inferior/INFERIOR FINAL.SLDASM

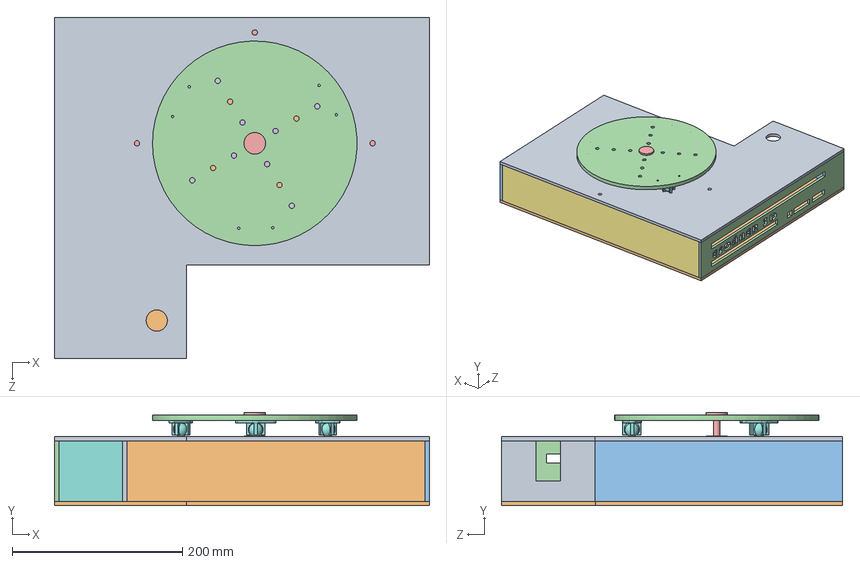
[picture p204: CAD file, 2019-11-13]
Modelado/inferior/INFERIOR FINAL.SLDASM
440.0 x 109.5 x 400.0 mm
INF01
INF02
INF03
INF04
PERNO 8mm x 3
INF06
INF07
INF08
INF09
gitproyectNEMA Stepper
gitproyectplato perforado
gitproyectcentro plato
ejemotor
acople motor pieza
rueda loca x 3
