JavierPerez24/Escaner3D/Modelado/superior/Ensamblaje1.SLDASM

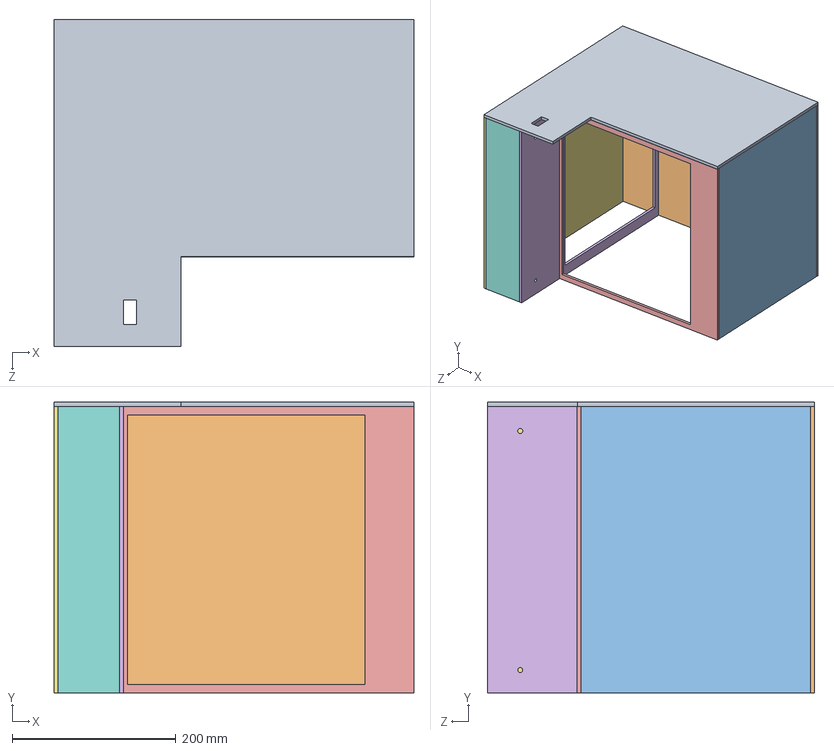
[picture p205: CAD file, 2019-11-02]
Modelado/superior/Ensamblaje1.SLDASM
440.0 x 355.5 x 400.0 mm
SUP01
SUP02
SUP03
SUP04
SUP05
SUP06
SUP07
SUP08
