JavierPerez24/Escaner3D/Modelado/inferior/Ensamblaje total.SLDASM

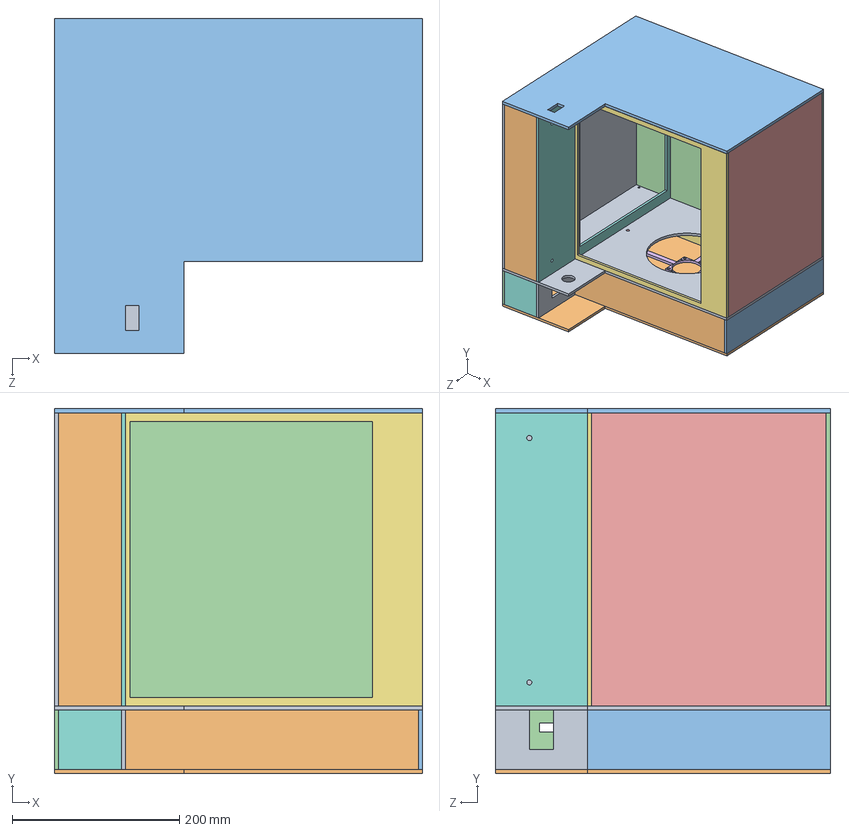
[picture p206: CAD file, 2019-11-02]
Modelado/inferior/Ensamblaje total.SLDASM
440.0 x 436.5 x 400.0 mm
INF01
INF02
INF03
INF04
PERNO 8mm x 3
INF06
INF07
INF08
INF09
INF10
SUP01
SUP02
SUP03
SUP04
SUP05
SUP06
SUP07
SUP08
