JavierPerez24/Escaner3D/Modelado/inferior/inferior.SLDASM

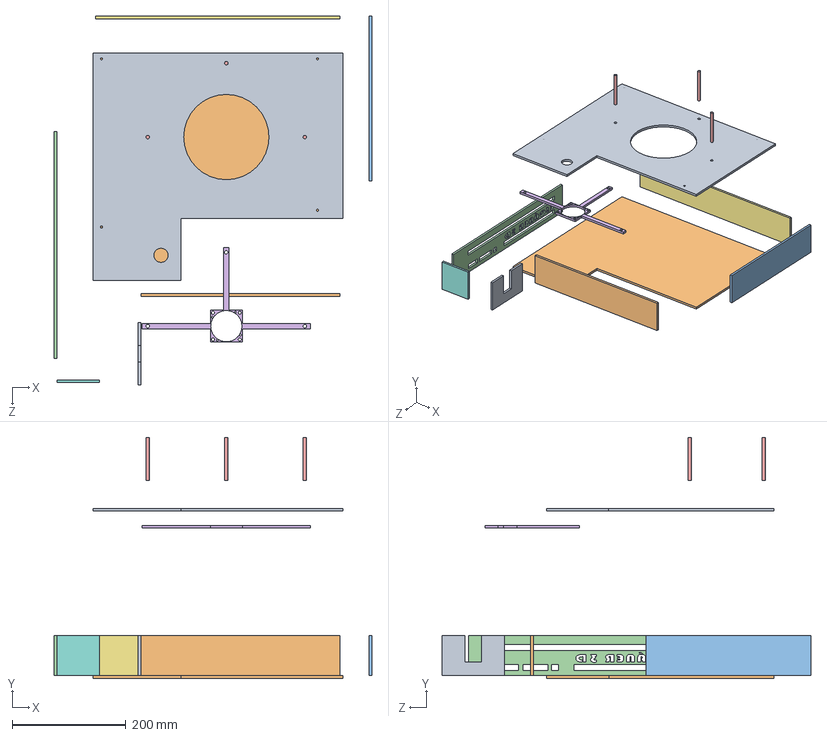
[picture p207: CAD file, 2019-11-02]
Modelado/inferior/inferior.SLDASM
559.2 x 424.2 x 649.2 mm
INF01gitproyectbase
INF01gitproyectbase mecanismo final
INF01gitproyectlateral base derecha
INF01gitproyectparedbase
INF01gitproyectperno base motor x 3
INF01gitproyectbase motor
INF01gitproyectposterior base
gitproyectfrontalpeqbase
INF01
INF01 frontal
