JavierPerez24/Escaner3D/Modelado/A gitproyectlateral ensamblajefinal.SLDPRT

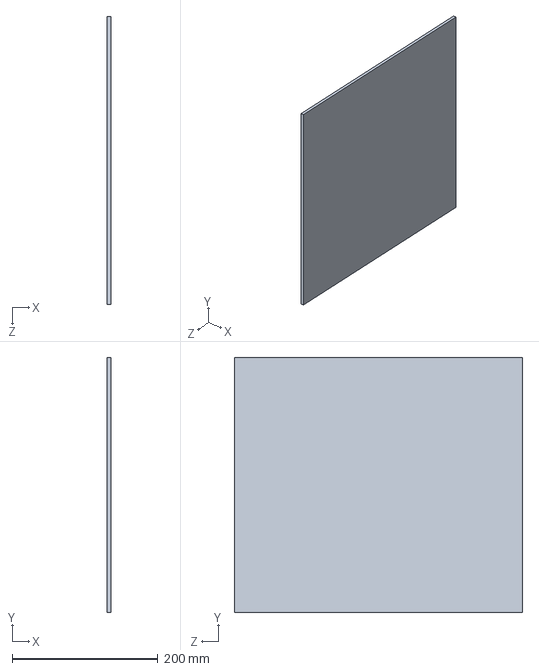
[picture p208: CAD file, 2020-02-08]
Modelado/A gitproyectlateral ensamblajefinal.SLDPRT
5.00 x 350.0 x 395.0 mm
