JavierPerez24/Escaner3D/Modelado/gitproyectlateral derecha ensamblaje final.SLDPRT

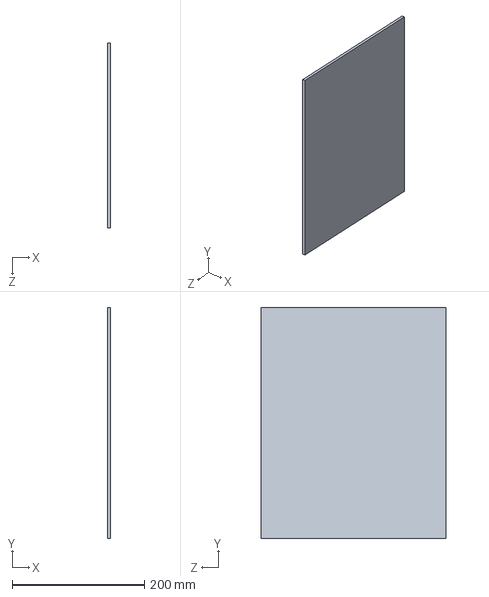
[picture p209: CAD file, 2019-11-02]
Modelado/gitproyectlateral derecha ensamblaje final.SLDPRT
5.00 x 350.0 x 280.5 mm
