JavierPerez24/Escaner3D/Modelado/inferior/INF10.SLDPRT

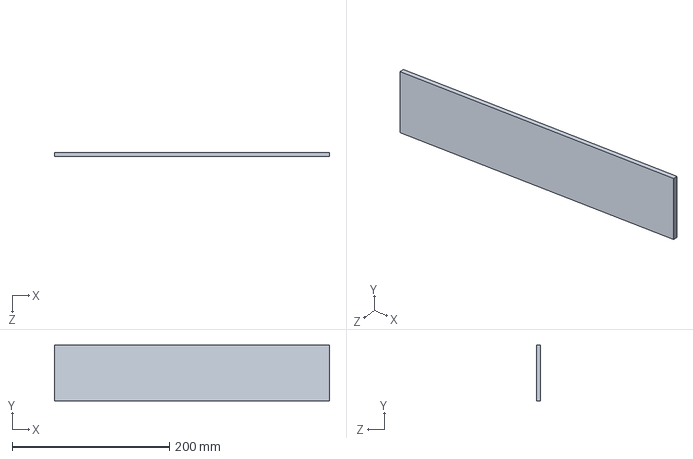
[picture p210: CAD file, 2019-11-13]
Modelado/inferior/INF10.SLDPRT
350.0 x 71.0 x 5.50 mm
