JavierPerez24/Escaner3D/Modelado/A gitbase superior.SLDPRT

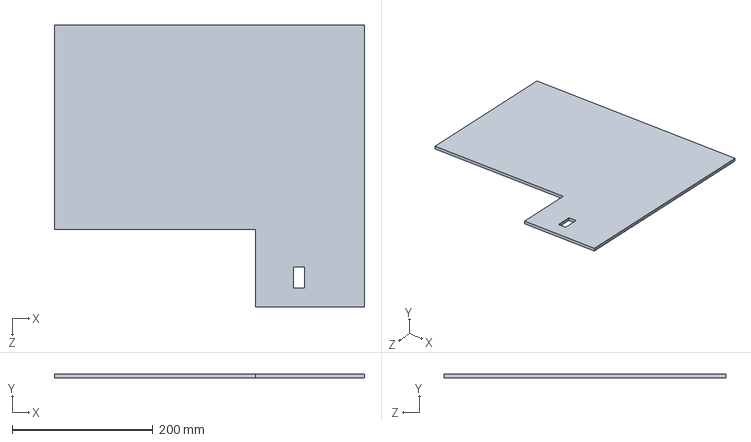
[picture p211: CAD file, 2020-03-01]
Modelado/A gitbase superior.SLDPRT
440.0 x 5.50 x 400.0 mm
