JavierPerez24/Escaner3D/Modelado/inferior/INF07.SLDPRT

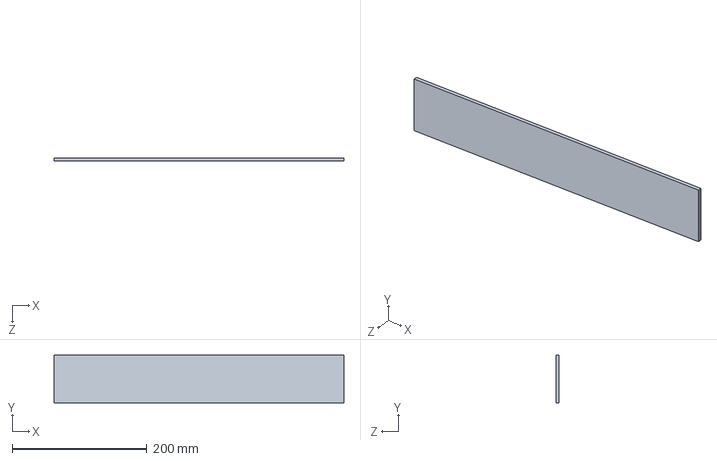
[picture p212: CAD file, 2019-11-13]
Modelado/inferior/INF07.SLDPRT
430.0 x 71.0 x 5.00 mm
