JavierPerez24/Escaner3D/Modelado/superior/SUP04.SLDPRT

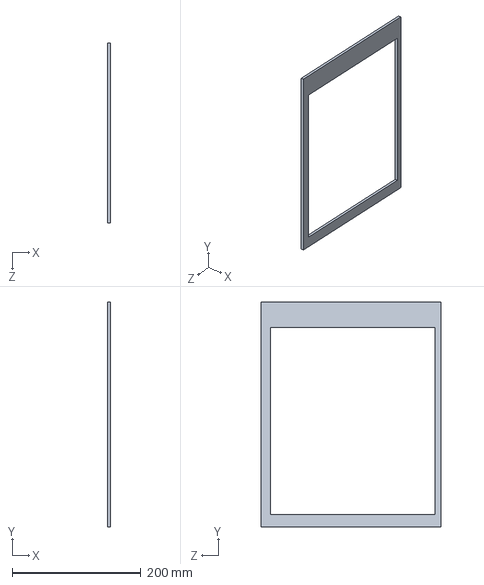
[picture p213: CAD file, 2020-02-08]
Modelado/superior/SUP04.SLDPRT
5.00 x 350.0 x 280.5 mm
