JavierPerez24/Escaner3D/Modelado/traslacion/Tuerca ACME 5-16 (4 cuerdas).SLDPRT

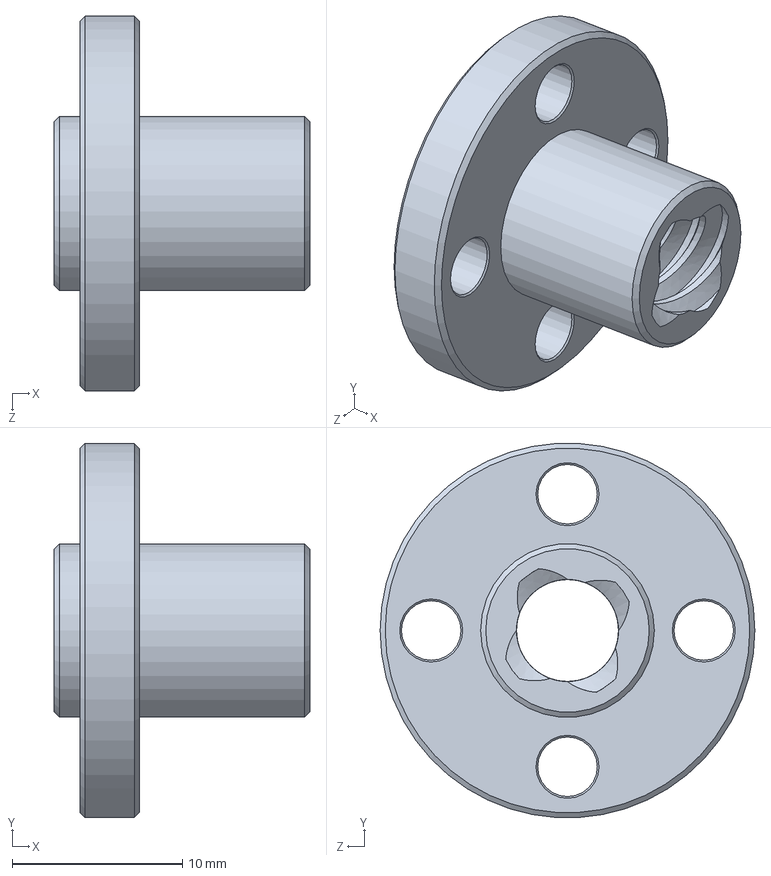
[picture p214: CAD file, 2019-11-04]
Modelado/traslacion/Tuerca ACME 5-16 (4 cuerdas).SLDPRT
15.0 x 22.0 x 22.0 mm
