JavierPerez24/Escaner3D/Modelado/gitproyectplato perforado.SLDPRT

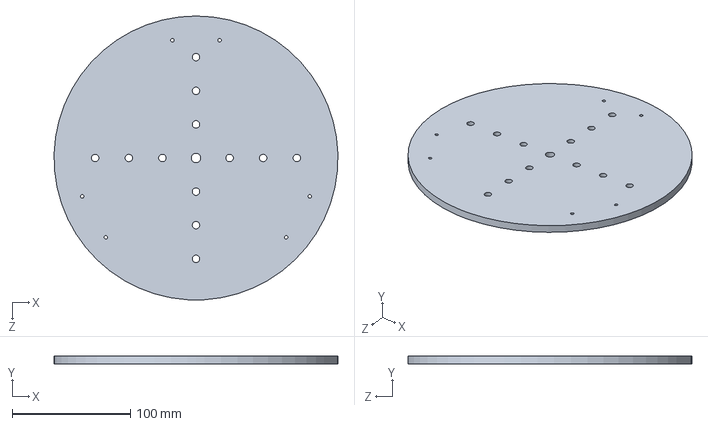
[picture p215: CAD file, 2020-02-08]
Modelado/gitproyectplato perforado.SLDPRT
239.9 x 6.50 x 240.0 mm
