JavierPerez24/Escaner3D/Modelado/inferior/ejemotor.SLDPRT

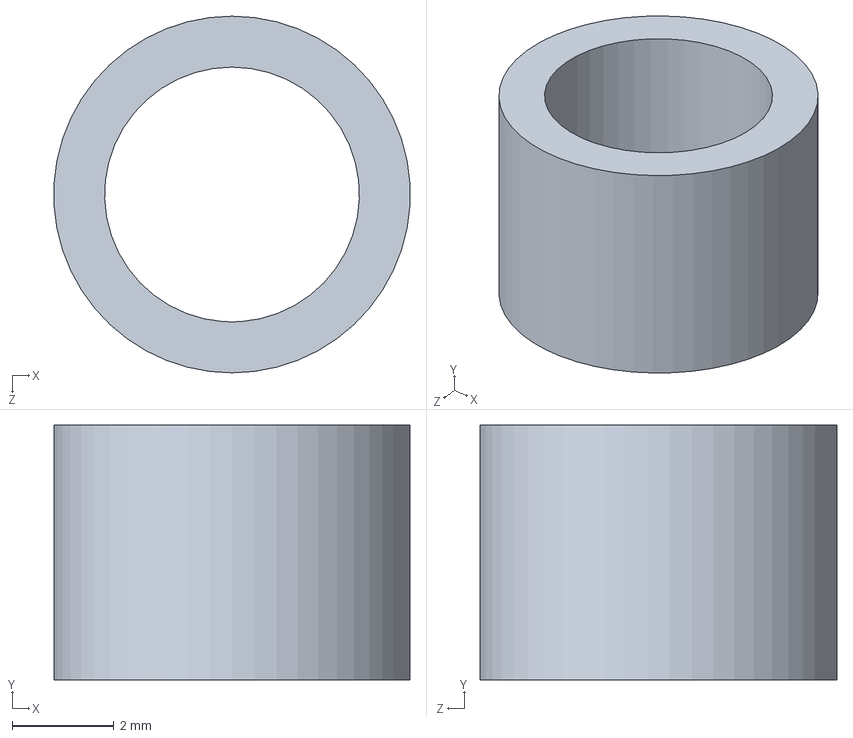
[picture p216: CAD file, 2019-11-13]
Modelado/inferior/ejemotor.SLDPRT
6.99 x 5.00 x 7.00 mm
