JavierPerez24/Escaner3D/Modelado/superior/SUP08.SLDPRT

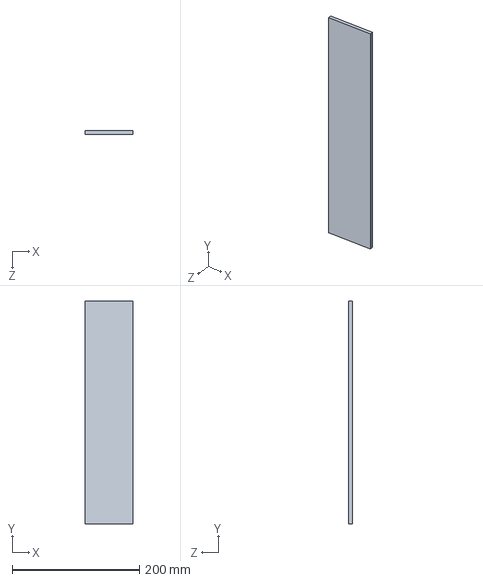
[picture p217: CAD file, 2020-02-08]
Modelado/superior/SUP08.SLDPRT
75.0 x 350.0 x 5.50 mm
