JavierPerez24/Escaner3D/Modelado/inferior/arandela.SLDPRT

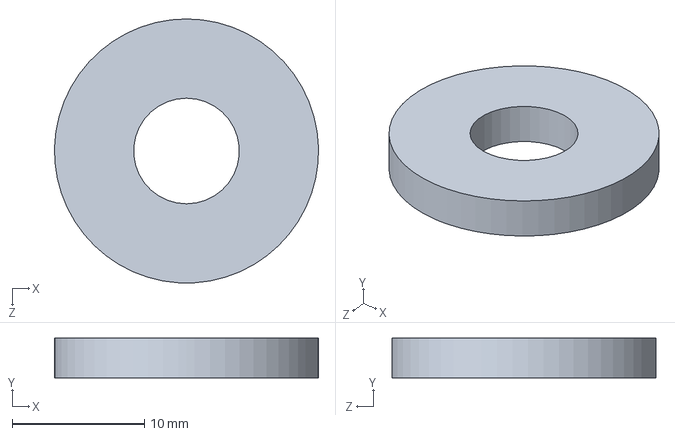
[picture p218: CAD file, 2019-11-13]
Modelado/inferior/arandela.SLDPRT
20.0 x 3.00 x 20.0 mm
