JavierPerez24/Escaner3D/Modelado/superior/SUP02.SLDPRT

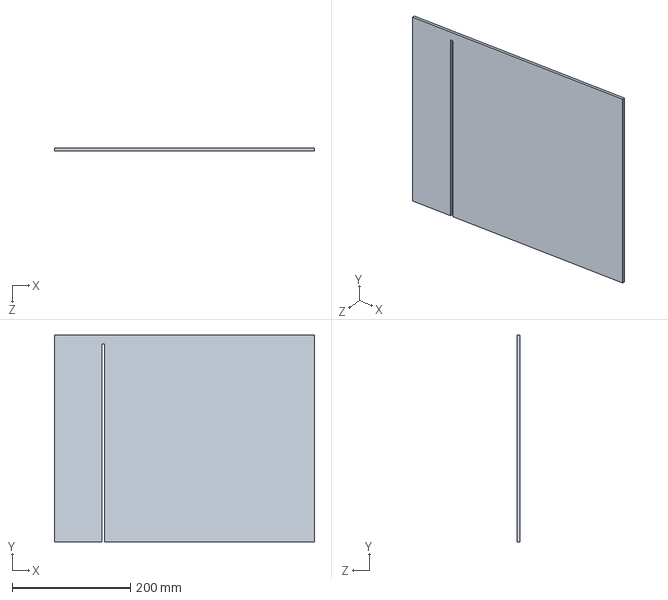
[picture p219: CAD file, 2019-11-02]
Modelado/superior/SUP02.SLDPRT
440.0 x 350.0 x 5.00 mm
