JavierPerez24/Escaner3D/Modelado/traslacion/rodamiento.SLDPRT

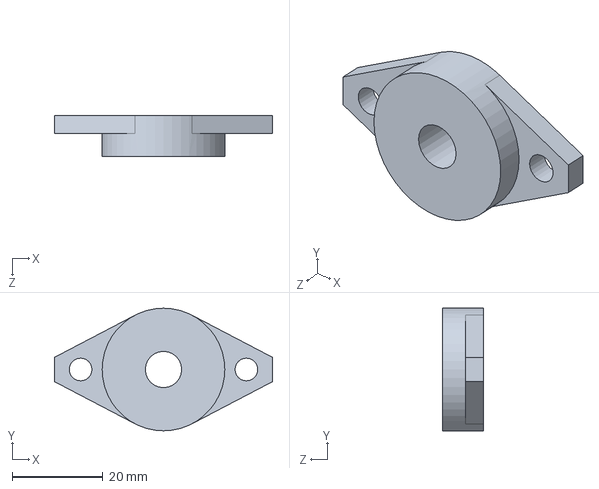
[picture p220: CAD file, 2019-11-03]
Modelado/traslacion/rodamiento.SLDPRT
48.0 x 27.0 x 9.00 mm
