JavierPerez24/Escaner3D/Modelado/gitproyectbloque perforado.SLDPRT

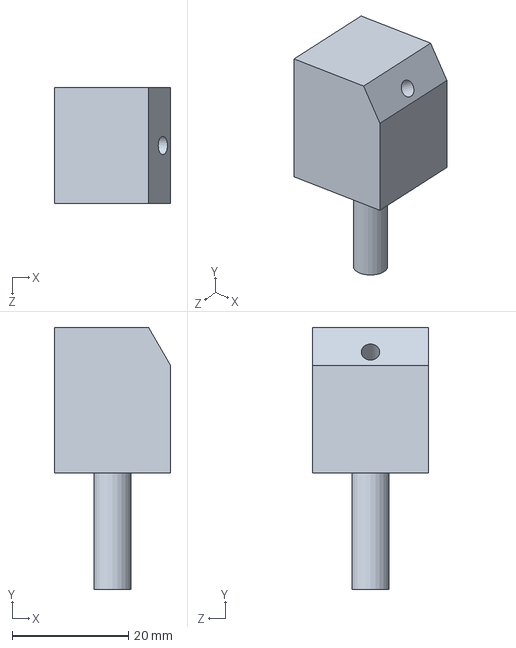
[picture p221: CAD file, 2020-02-08]
Modelado/gitproyectbloque perforado.SLDPRT
20.0 x 45.0 x 20.0 mm
