JavierPerez24/Escaner3D/Modelado/inferior/rueda loca.SLDPRT

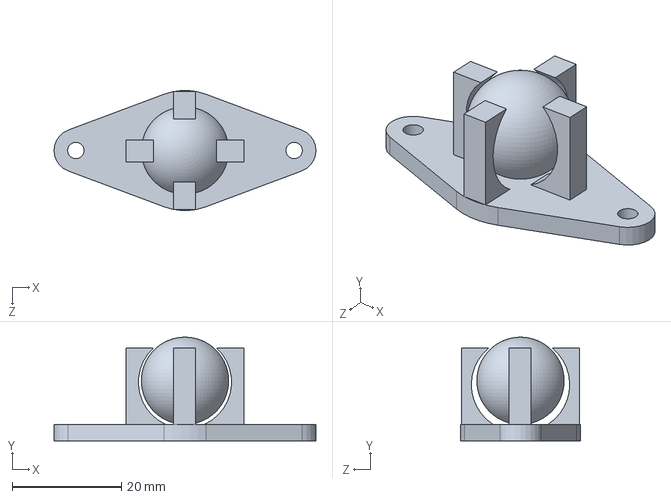
[picture p222: CAD file, 2019-11-13]
Modelado/inferior/rueda loca.SLDPRT
48.0 x 19.0 x 21.9 mm
