JavierPerez24/Escaner3D/Modelado/traslacion/base rosca.SLDPRT

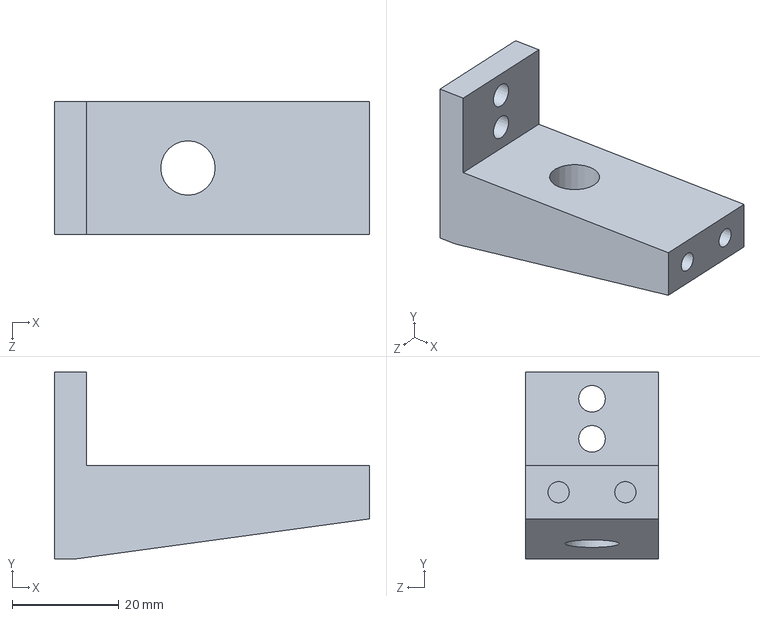
[picture p223: CAD file, 2019-11-03]
Modelado/traslacion/base rosca.SLDPRT
59.0 x 35.0 x 25.0 mm
