JavierPerez24/Escaner3D/Modelado/gitproyectfrontal motor cnc.SLDPRT

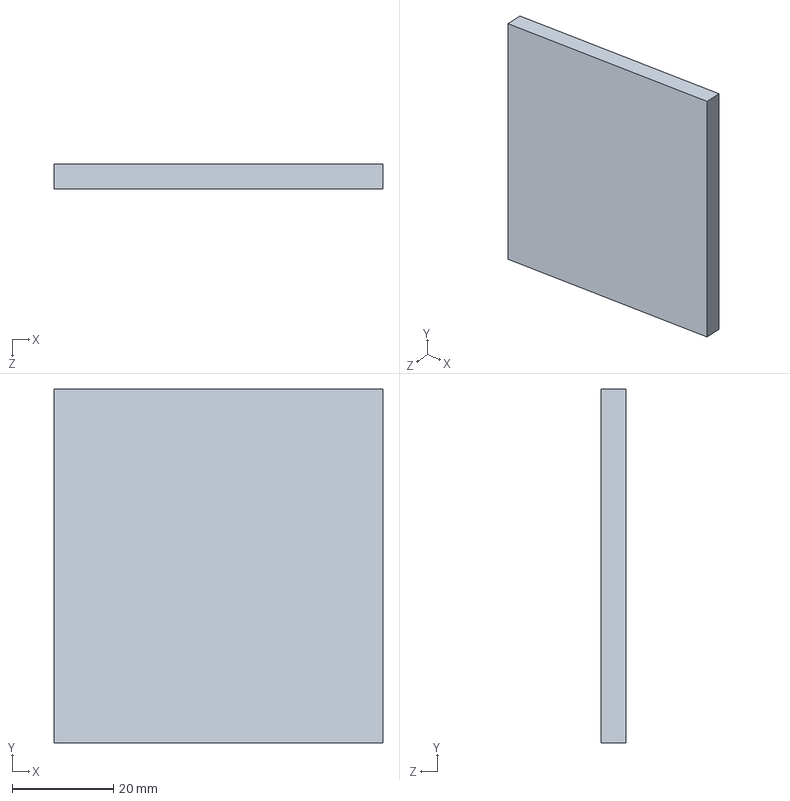
[picture p224: CAD file, 2020-02-08]
Modelado/gitproyectfrontal motor cnc.SLDPRT
65.0 x 70.0 x 5.00 mm
