JavierPerez24/Escaner3D/Modelado/inferior/acople motor pieza.SLDPRT

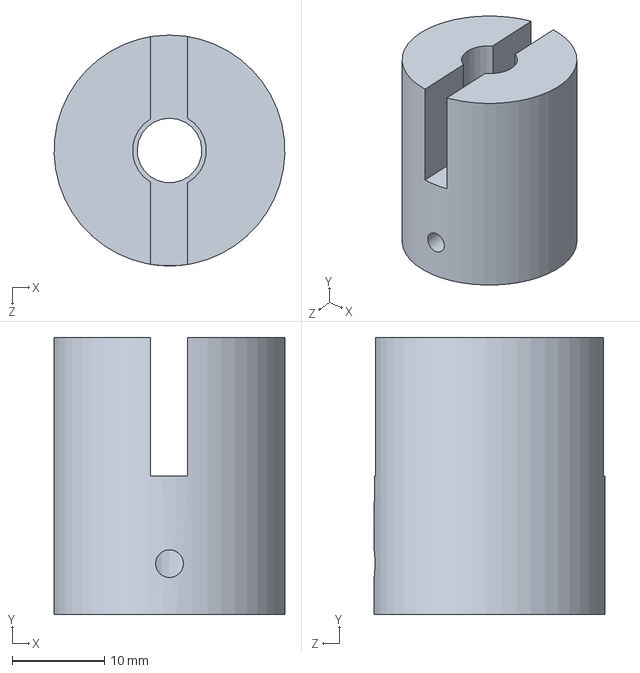
[picture p225: CAD file, 2019-11-13]
Modelado/inferior/acople motor pieza.SLDPRT
25.0 x 30.0 x 25.0 mm
