JavierPerez24/Escaner3D/Modelado/superior/SUP05.SLDPRT

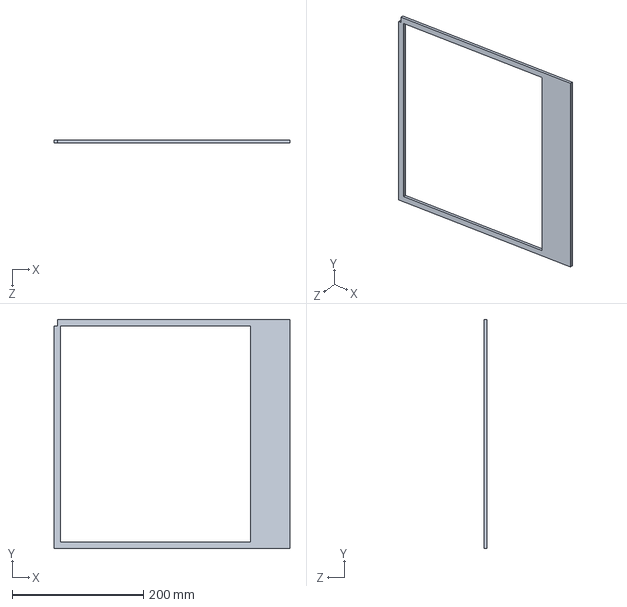
[picture p226: CAD file, 2019-11-02]
Modelado/superior/SUP05.SLDPRT
360.0 x 350.0 x 5.00 mm
