JavierPerez24/Escaner3D/Modelado/traslacion/gitproyectguia riel.SLDPRT

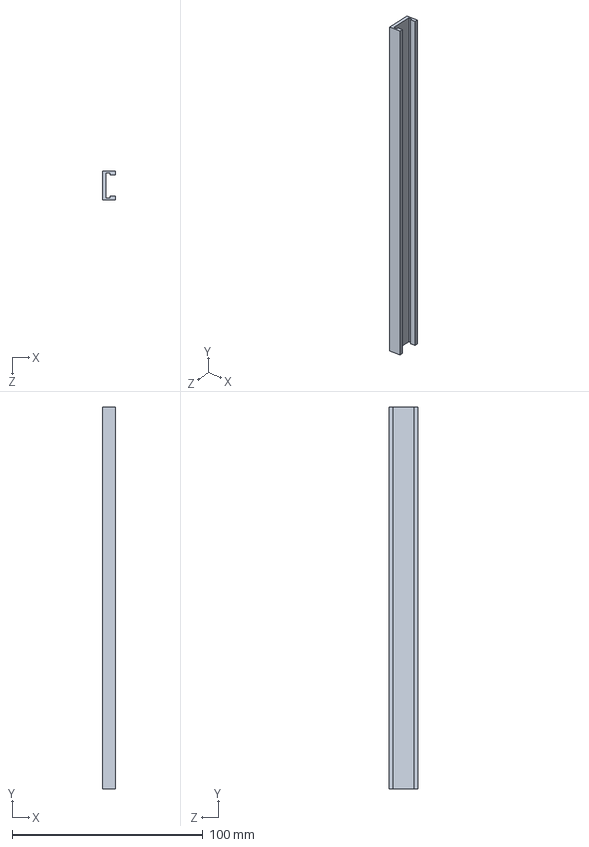
[picture p227: CAD file, 2019-11-02]
Modelado/traslacion/gitproyectguia riel.SLDPRT
7.00 x 200.0 x 15.0 mm
