JavierPerez24/Escaner3D/Modelado/gitproyectRiel.SLDPRT

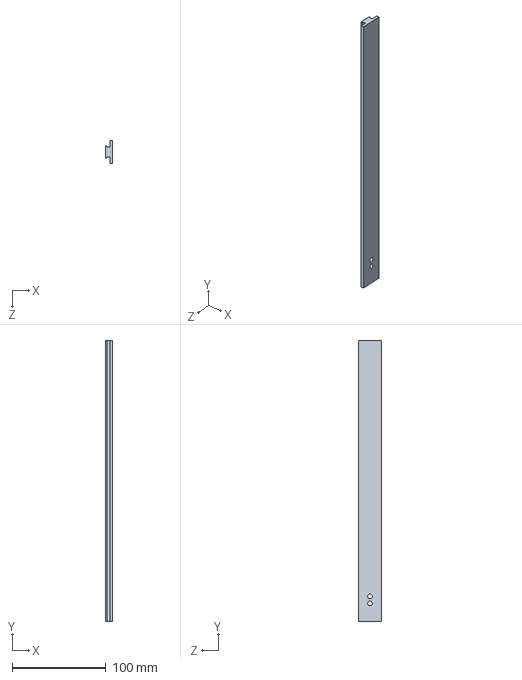
[picture p228: CAD file, 2020-02-08]
Modelado/gitproyectRiel.SLDPRT
8.00 x 300.0 x 25.0 mm
