JavierPerez24/Escaner3D/Modelado/difusor2.SLDPRT

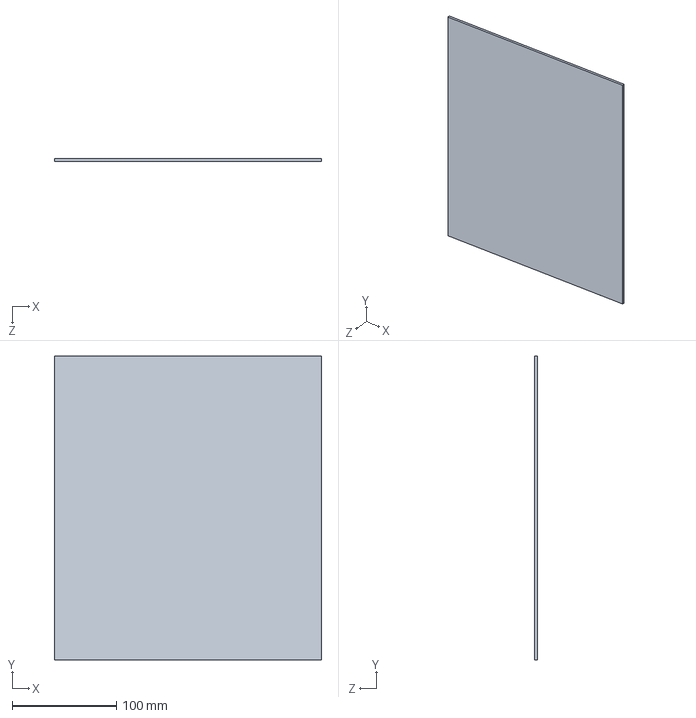
[picture p229: CAD file, 2020-02-08]
Modelado/difusor2.SLDPRT
255.9 x 291.1 x 3.00 mm
