JavierPerez24/Escaner3D/Modelado/inferior/INF09.SLDPRT

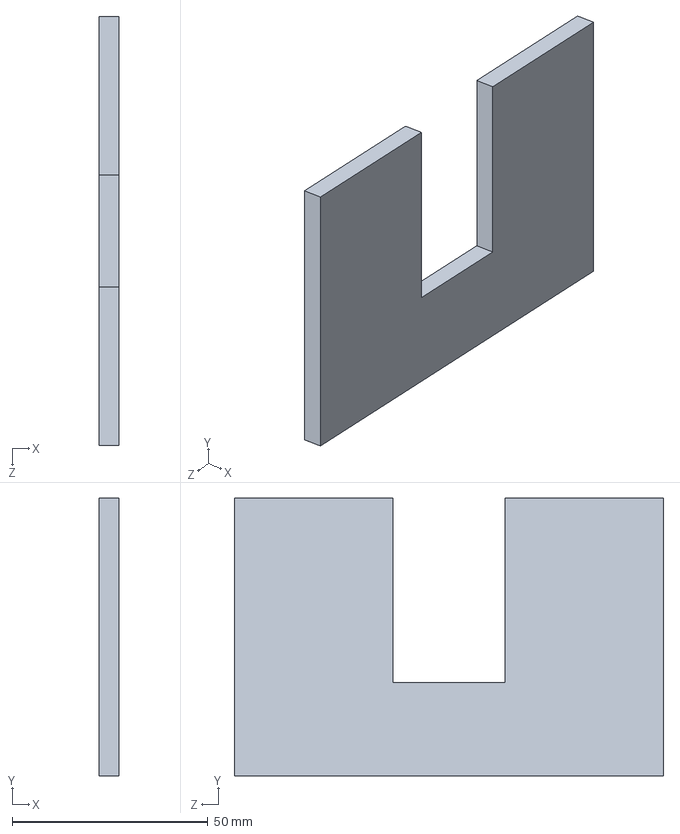
[picture p230: CAD file, 2019-11-13]
Modelado/inferior/INF09.SLDPRT
5.00 x 71.0 x 109.6 mm
