JavierPerez24/Escaner3D/Modelado/superior/SUP06.SLDPRT

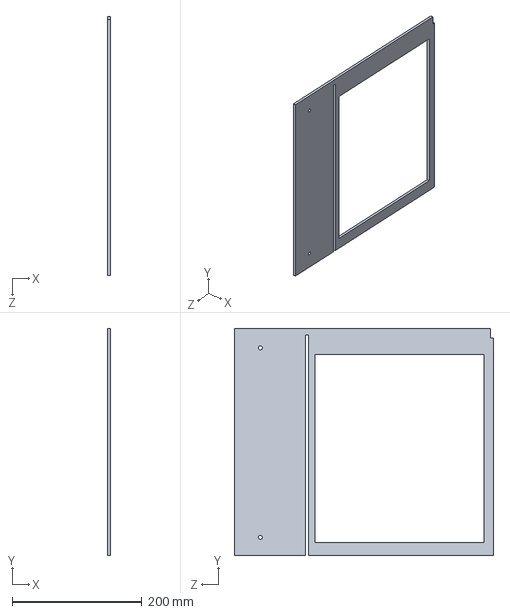
[picture p231: CAD file, 2019-11-02]
Modelado/superior/SUP06.SLDPRT
5.00 x 350.0 x 400.0 mm
