JavierPerez24/Escaner3D/Modelado/gitproyectfrontalpeqbase.SLDPRT

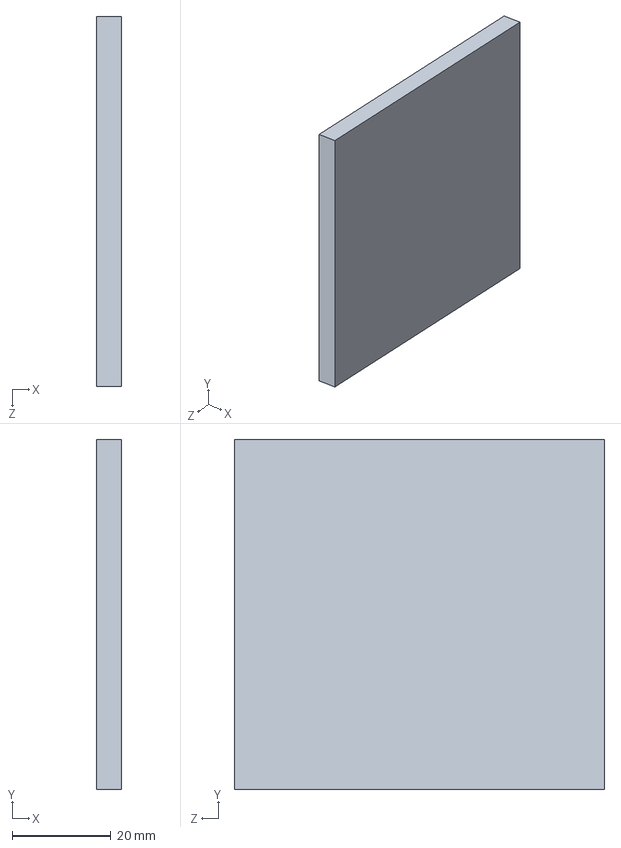
[picture p232: CAD file, 2020-02-08]
Modelado/gitproyectfrontalpeqbase.SLDPRT
5.00 x 71.0 x 75.0 mm
