JavierPerez24/Escaner3D/Modelado/inferior/INF04.SLDPRT

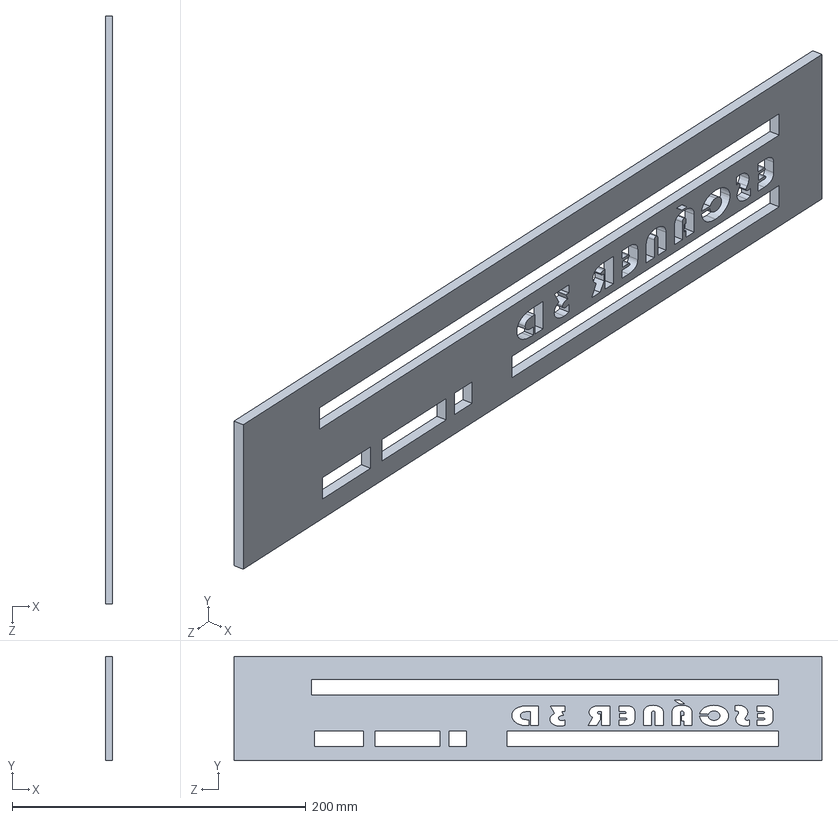
[picture p233: CAD file, 2019-11-13]
Modelado/inferior/INF04.SLDPRT
5.00 x 71.0 x 400.0 mm
