JavierPerez24/Escaner3D/Modelado/gitproyectbase mecanismo final.SLDPRT

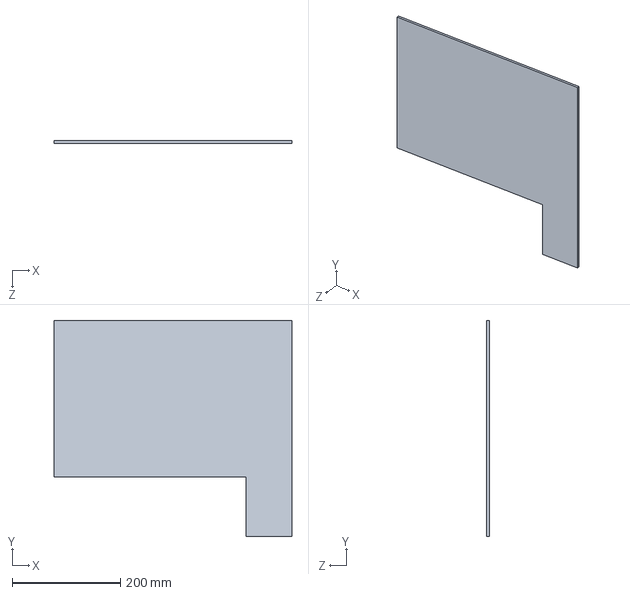
[picture p234: CAD file, 2020-02-08]
Modelado/gitproyectbase mecanismo final.SLDPRT
440.0 x 400.0 x 5.00 mm
