JavierPerez24/Escaner3D/Modelado/inferior/tuerca.SLDPRT

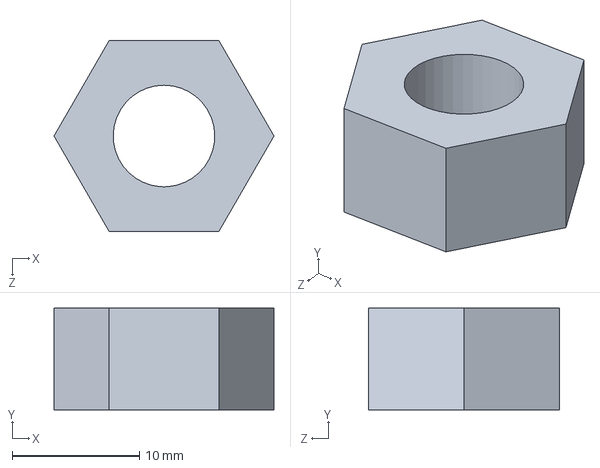
[picture p235: CAD file, 2019-11-13]
Modelado/inferior/tuerca.SLDPRT
17.3 x 8.00 x 15.0 mm
