JavierPerez24/Escaner3D/Modelado/inferior/INF01.SLDPRT

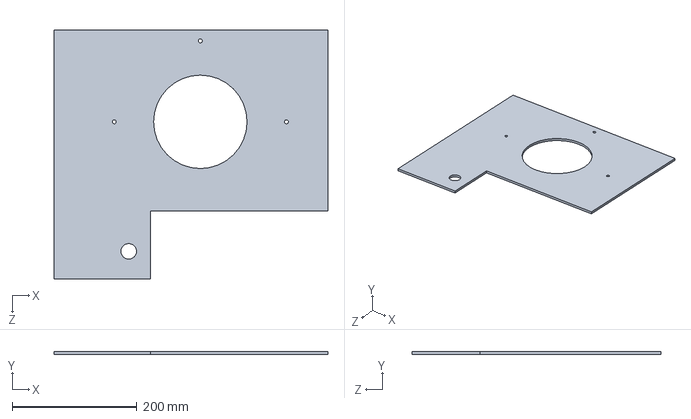
[picture p236: CAD file, 2019-11-13]
Modelado/inferior/INF01.SLDPRT
440.0 x 5.00 x 400.0 mm
