JavierPerez24/Escaner3D/Modelado/gitproyectbase.SLDPRT

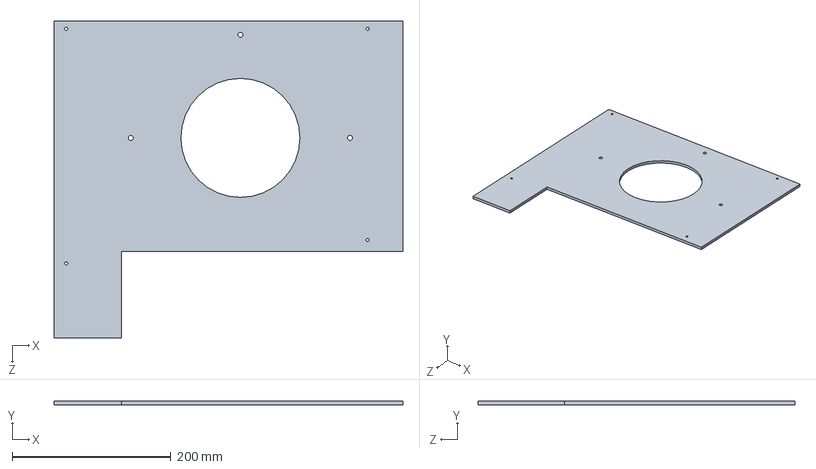
[picture p237: CAD file, 2020-02-08]
Modelado/gitproyectbase.SLDPRT
440.0 x 5.00 x 400.0 mm
