JavierPerez24/Escaner3D/Modelado/inferior/PERNO 8mm.SLDPRT

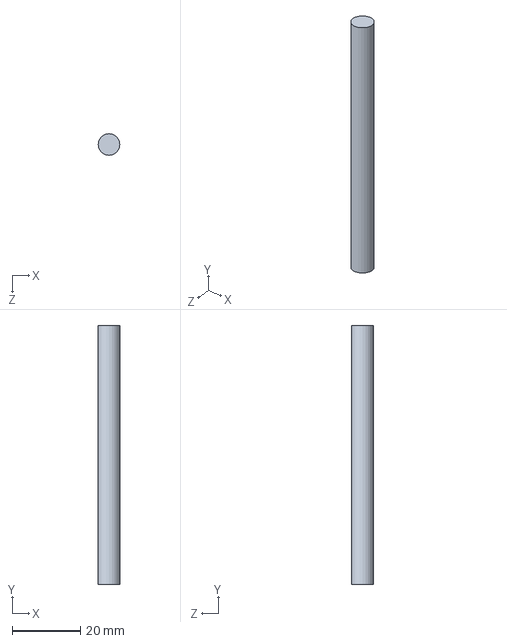
[picture p238: CAD file, 2019-11-13]
Modelado/inferior/PERNO 8mm.SLDPRT
6.35 x 76.0 x 6.35 mm
