JavierPerez24/Escaner3D/Modelado/gitproyectbase motor tornillo.SLDPRT

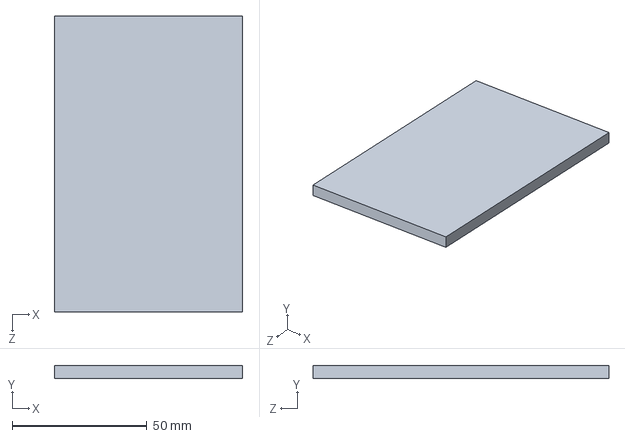
[picture p239: CAD file, 2020-02-08]
Modelado/gitproyectbase motor tornillo.SLDPRT
70.0 x 5.00 x 110.0 mm
