JavierPerez24/Escaner3D/Modelado/inferior/INF06.SLDPRT

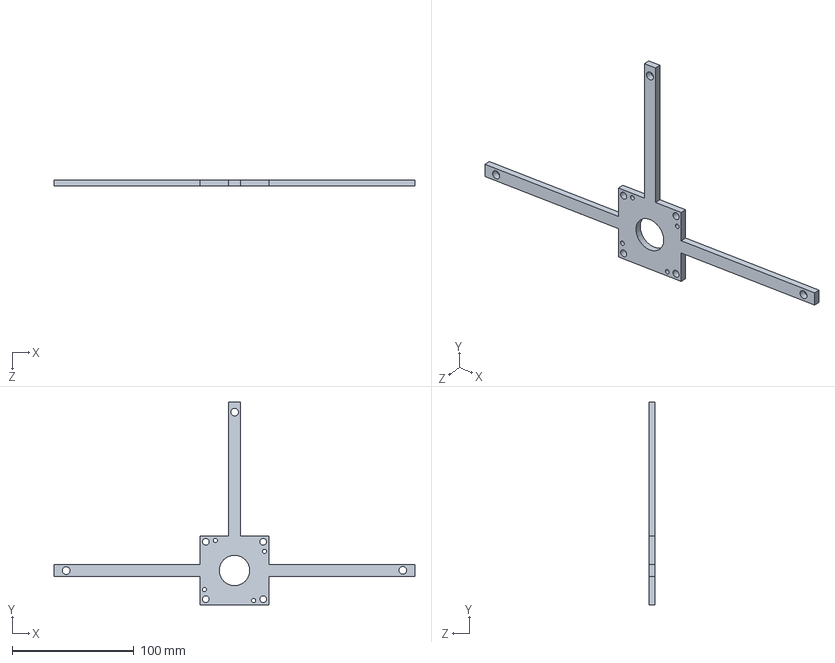
[picture p240: CAD file, 2019-11-13]
Modelado/inferior/INF06.SLDPRT
296.4 x 166.4 x 5.00 mm
