JavierPerez24/Escaner3D/Modelado/inferior/INF02.SLDPRT

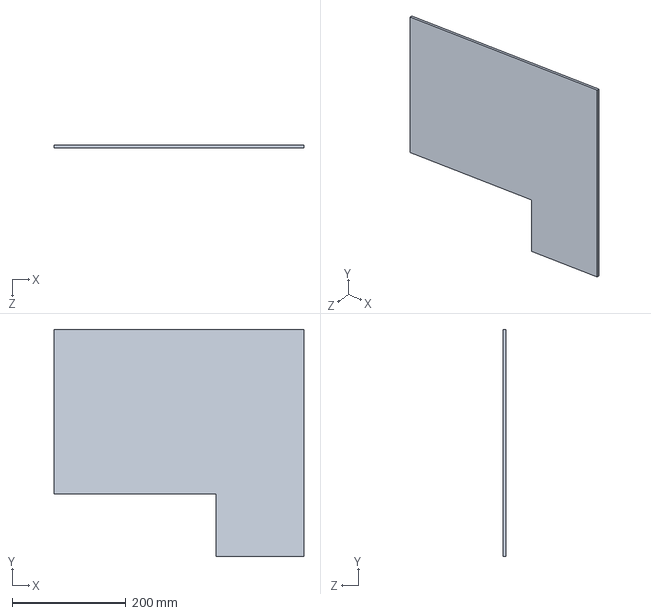
[picture p241: CAD file, 2019-11-13]
Modelado/inferior/INF02.SLDPRT
440.0 x 400.0 x 5.00 mm
