JavierPerez24/Escaner3D/Modelado/gitproyectfrontal base.SLDPRT

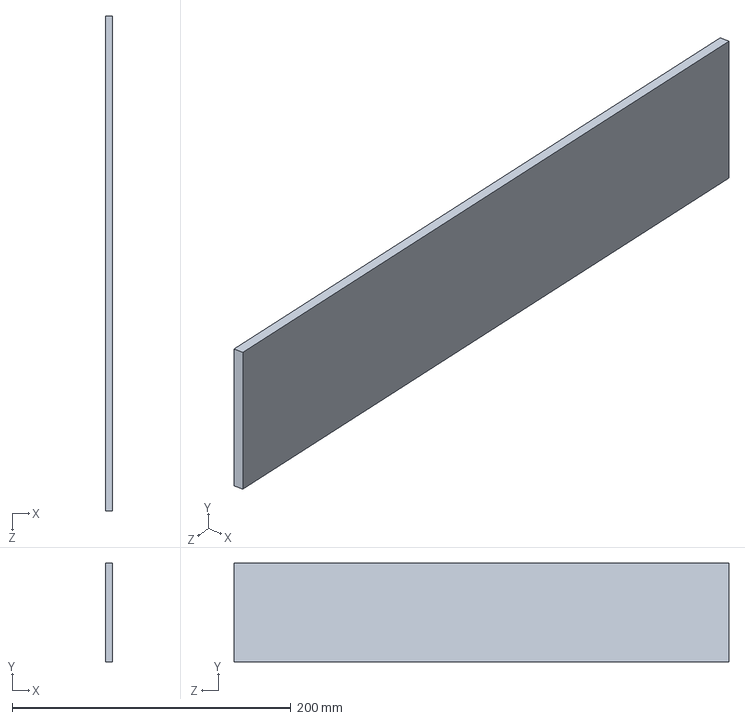
[picture p242: CAD file, 2020-02-08]
Modelado/gitproyectfrontal base.SLDPRT
5.00 x 71.0 x 355.0 mm
