JavierPerez24/Escaner3D/Modelado/inferior/INF03.SLDPRT

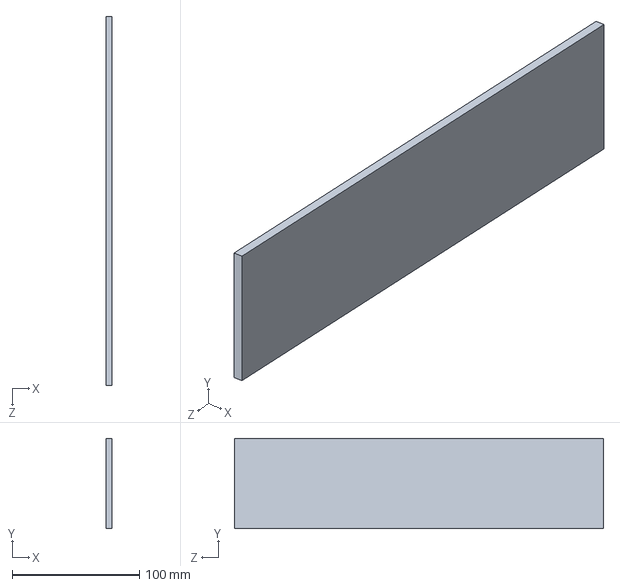
[picture p243: CAD file, 2019-11-13]
Modelado/inferior/INF03.SLDPRT
5.00 x 71.0 x 290.5 mm
