JavierPerez24/Escaner3D/Modelado/gitproyecttornillo cnc.SLDPRT

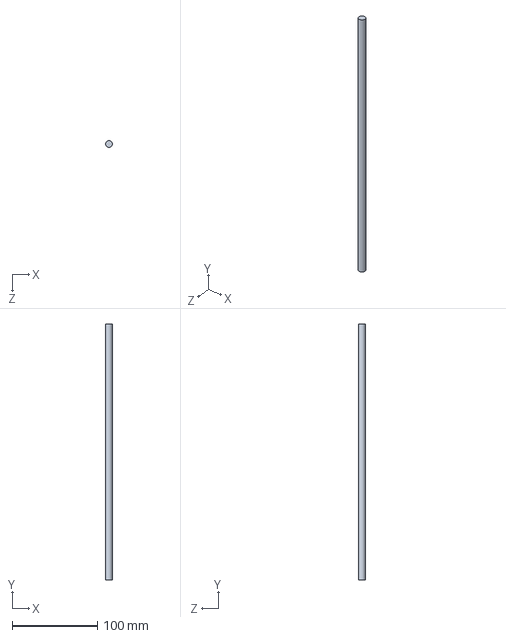
[picture p244: CAD file, 2020-02-08]
Modelado/gitproyecttornillo cnc.SLDPRT
8.00 x 300.0 x 8.00 mm
