JavierPerez24/Escaner3D/Modelado/chapas.SLDPRT

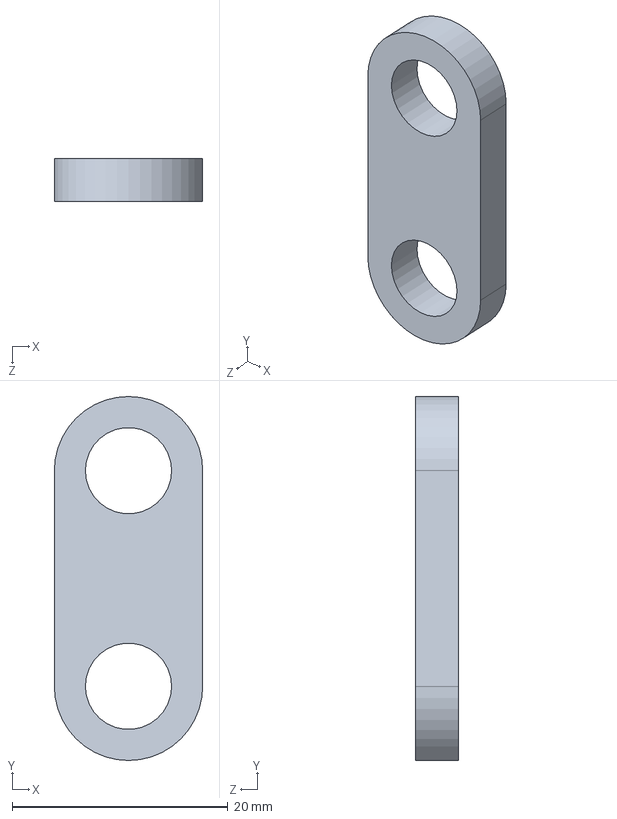
[picture p245: CAD file, 2020-02-08]
Modelado/chapas.SLDPRT
13.8 x 33.8 x 4.00 mm
