JavierPerez24/Escaner3D/Modelado/Pieza3.SLDPRT

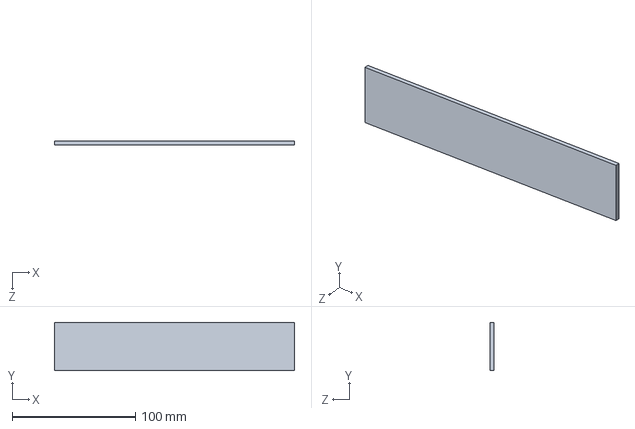
[picture p246: CAD file, 2020-02-08]
Modelado/Pieza3.SLDPRT
194.6 x 38.9 x 3.00 mm
