JavierPerez24/Escaner3D/Modelado/gitproyectcentro plato.SLDPRT

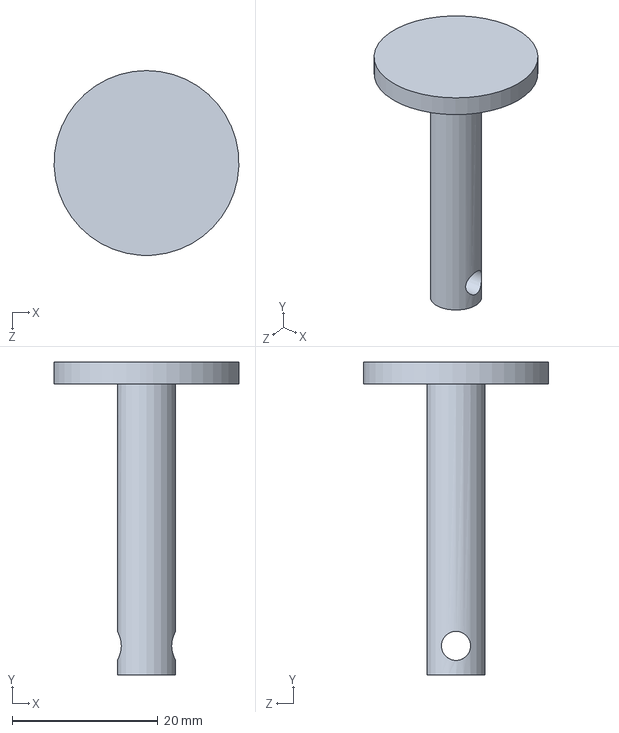
[picture p247: CAD file, 2019-11-13]
Modelado/gitproyectcentro plato.SLDPRT
25.4 x 43.0 x 25.4 mm
