JavierPerez24/Escaner3D/Modelado/gitproyectNEMA Stepper.SLDPRT

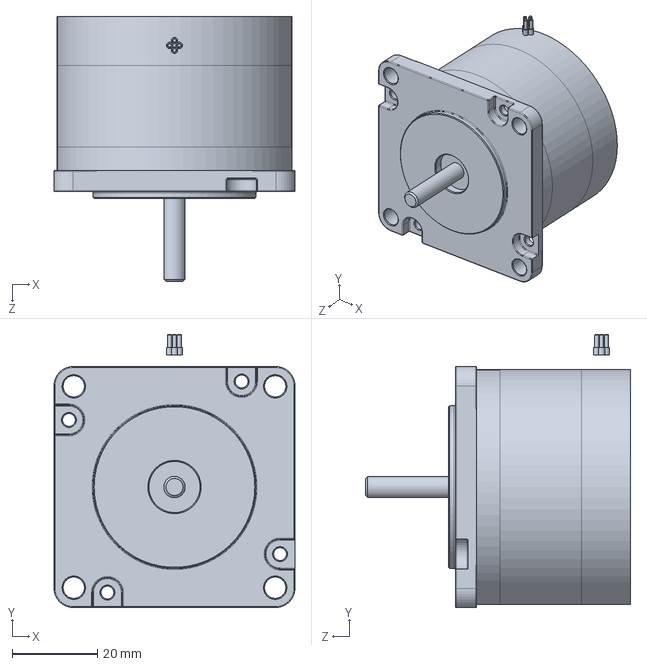
[picture p248: CAD file, 2019-11-13]
Modelado/gitproyectNEMA Stepper.SLDPRT
56.4 x 63.9 x 62.0 mm
