JavierPerez24/Escaner3D/Modelado/gitproyectpieza para celular.SLDPRT

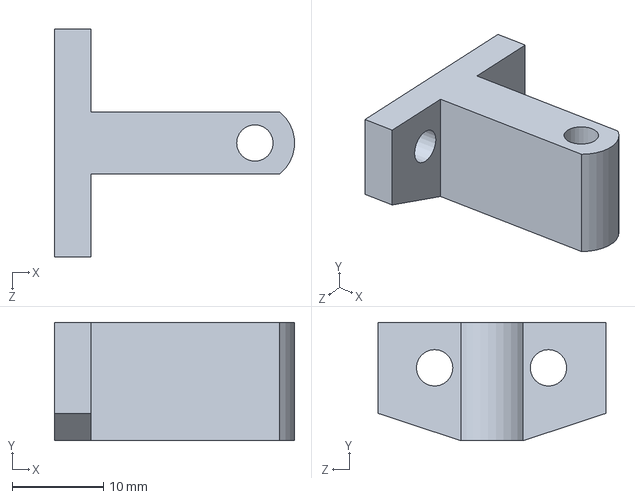
[picture p249: CAD file, 2019-11-02]
Modelado/gitproyectpieza para celular.SLDPRT
26.3 x 13.0 x 25.0 mm
