JavierPerez24/Escaner3D/Modelado/rosca base camara.SLDPRT

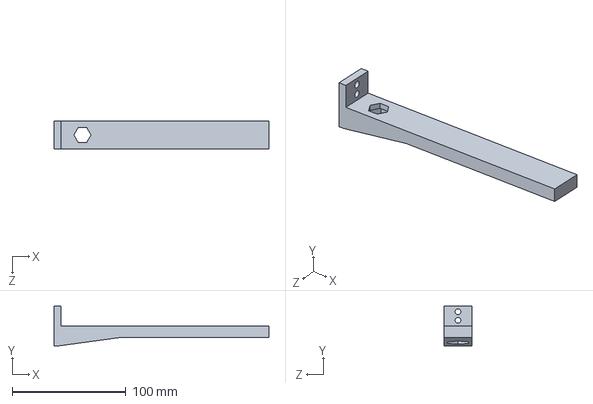
[picture p250: CAD file, 2019-11-02]
Modelado/rosca base camara.SLDPRT
189.0 x 35.0 x 25.0 mm
