JavierPerez24/Escaner3D/Modelado/gitproyectbase arduino.SLDPRT

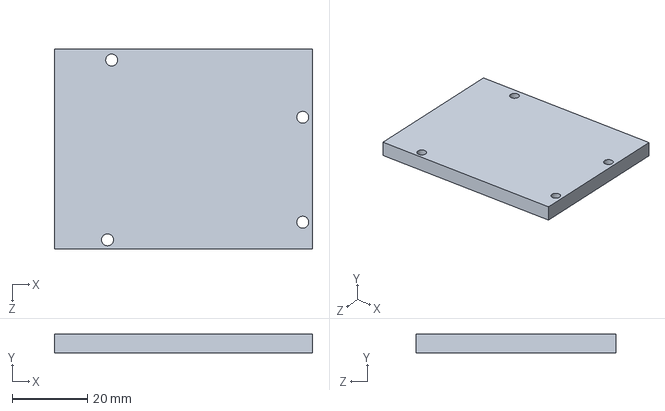
[picture p251: CAD file, 2019-11-02]
Modelado/gitproyectbase arduino.SLDPRT
68.6 x 5.00 x 53.3 mm
