JavierPerez24/Escaner3D/Modelado/gitproyectrosca con guia.SLDPRT

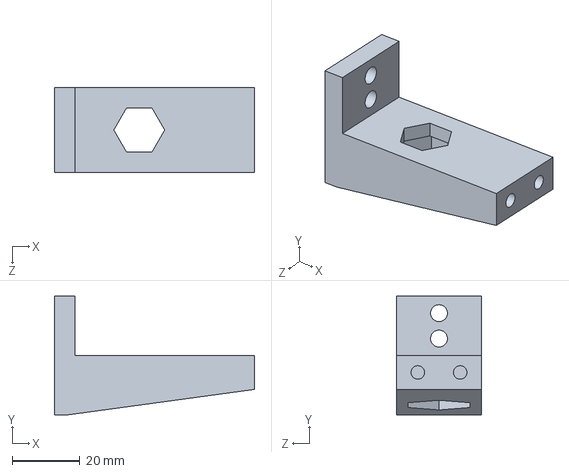
[picture p252: CAD file, 2019-11-02]
Modelado/gitproyectrosca con guia.SLDPRT
59.0 x 35.0 x 25.0 mm
