JavierPerez24/Escaner3D/Modelado/gitproyectsuup motor tornillo riel.SLDPRT

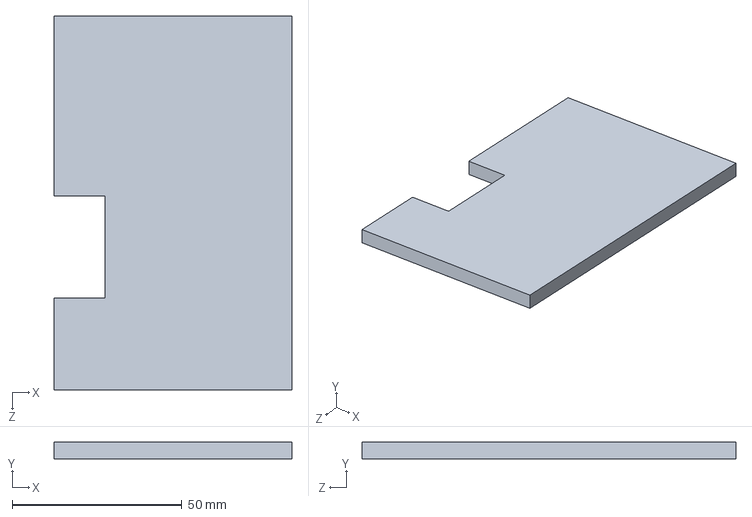
[picture p253: CAD file, 2019-11-02]
Modelado/gitproyectsuup motor tornillo riel.SLDPRT
70.0 x 5.00 x 110.0 mm
