JavierPerez24/Escaner3D/Modelado/gitproyectacople 8mmx5mm.SLDPRT

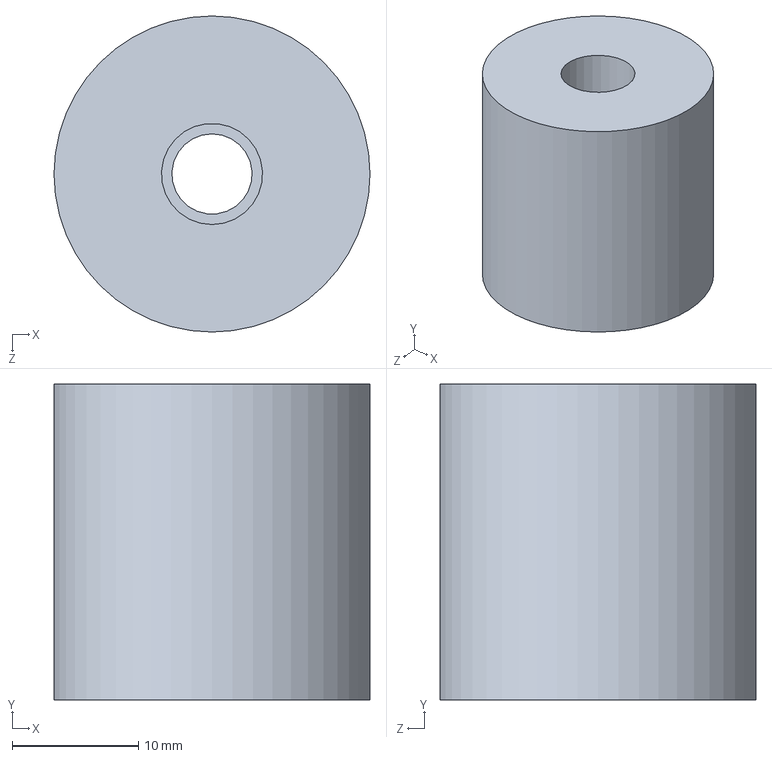
[picture p254: CAD file, 2019-11-02]
Modelado/gitproyectacople 8mmx5mm.SLDPRT
25.0 x 25.0 x 25.0 mm
