JavierPerez24/Escaner3D/Modelado/gitproyectArduino UNO.SLDPRT

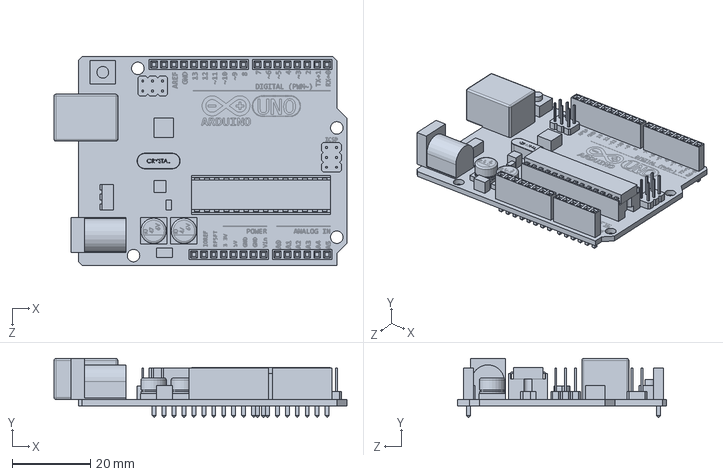
[picture p255: CAD file, 2019-11-02]
Modelado/gitproyectArduino UNO.SLDPRT
74.8 x 15.1 x 53.3 mm
