JavierPerez24/Escaner3D/Modelado/gitproyectbase motor.SLDPRT

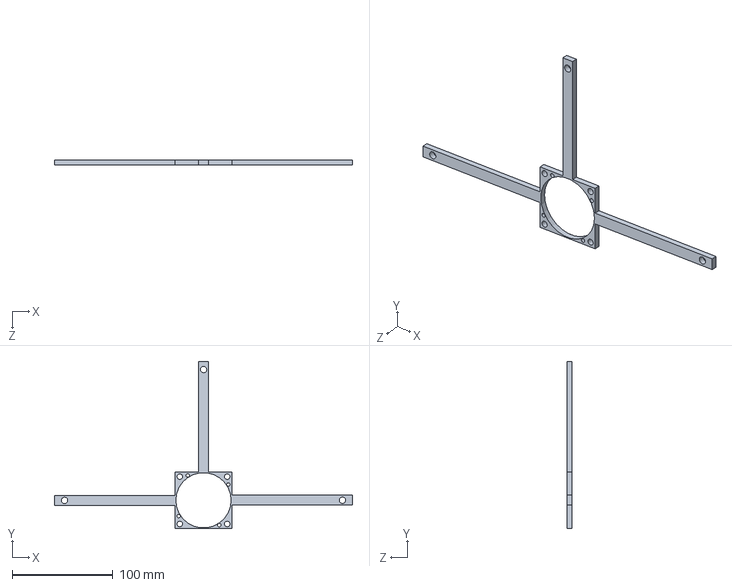
[picture p256: CAD file, 2019-11-02]
Modelado/gitproyectbase motor.SLDPRT
296.4 x 166.4 x 5.00 mm
