JavierPerez24/Escaner3D/Modelado/gitproyecttuerca1_4in.SLDPRT

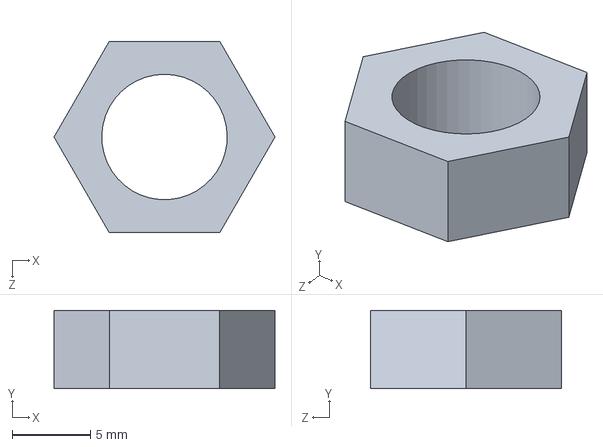
[picture p257: CAD file, 2019-11-02]
Modelado/gitproyecttuerca1_4in.SLDPRT
14.1 x 5.00 x 12.2 mm
