JavierPerez24/Escaner3D/(list of files, cad)

Other CAD files:
Modelado/gitproyectLateral ensamblajefinal.SLDPRT
Modelado/superior/SUP03.SLDPRT
Modelado/gitproyectposterior base.SLDPRT
Modelado/superior/SUP01.SLDPRT
Modelado/superior/SUP07.SLDPRT
Modelado/traslacion/gitproyectRiel.SLDPRT
Modelado/A gitproyectposterior.SLDPRT
Modelado/difusor.SLDPRT
Modelado/inferior/INF08.SLDPRT
Modelado/gitproyectpared base.SLDPRT
Modelado/A gitproyectlateralderecha posiciones.SLDPRT
Modelado/gitproyectlateral motor tornillo.SLDPRT
Modelado/A gitproyectfrontal.SLDPRT
Modelado/gitproyectsuperior base motor tornillo.SLDPRT
Modelado/gitproyectlateral base derecha.SLDPRT
Modelado/gitproyectfrontal superior.SLDPRT
Modelado/gitproyectlateral derecha posiciones.SLDPRT
Modelado/A git proyectlateral izqierda.SLDPRT
Modelado/gitbase superior.SLDPRT
Modelado/gitproyectposterior.SLDPRT
Modelado/gitproyectperno base motor.SLDPRT
Modelado/A gitproyectfrontal superior.SLDPRT
Modelado/A gtproyectlateralizquierda.SLDPRT
Modelado/gitproyectlateral izquierda.SLDPRT
Modelado/gitproyectfrontal.SLDPRT
Modelado/gitproyectparedbase.SLDPRT
Modelado/inferior/INFERIOR FINAL.SLDDRW
Modelado/inferior/Planos para corte/planos para corte inferior.SLDDRW
Modelado/inferior/inferior.SLDDRW
Modelado/inferior/planos por piezas/INF01.SLDDRW
Modelado/inferior/planos por piezas/INF02.SLDDRW
Modelado/inferior/planos por piezas/INF03.SLDDRW
Modelado/inferior/planos por piezas/INF04.SLDDRW
Modelado/inferior/planos por piezas/INF06.SLDDRW
Modelado/inferior/planos por piezas/INF07.SLDDRW
Modelado/inferior/planos por piezas/INF08.SLDDRW
Modelado/inferior/planos por piezas/INF09.SLDDRW
Modelado/inferior/planos por piezas/INF10.SLDDRW
Modelado/superior/Ensamblaje superior.SLDDRW
Modelado/superior/cortes superior/SUP01-06 cortes.SLDDRW
Modelado/superior/cortes superior/SUP07-08 cortes.SLDDRW
Modelado/superior/planos por piezas/SUP01.SLDDRW
Modelado/superior/planos por piezas/SUP02.SLDDRW
Modelado/superior/planos por piezas/SUP03.SLDDRW
Modelado/superior/planos por piezas/SUP04.SLDDRW
Modelado/superior/planos por piezas/SUP05.SLDDRW
Modelado/superior/planos por piezas/SUP06.SLDDRW
Modelado/superior/planos por piezas/SUP07.SLDDRW
Modelado/superior/planos por piezas/SUP08.SLDDRW
Modelado/traslacion/rosca.SLDDRW
