JavierPerez24/Escaner3D/imagenes libro/etapas de calibración de la cámara.PNG

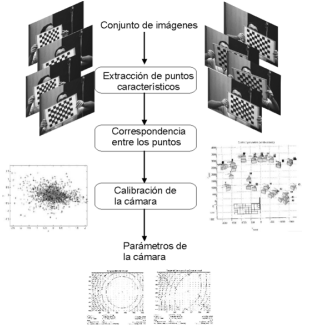
imagenes libro/etapas de calibración de la cámara.PNG
