JavierPerez24/Escaner3D/imagenes libro/etapas del metodo de calibración.PNG

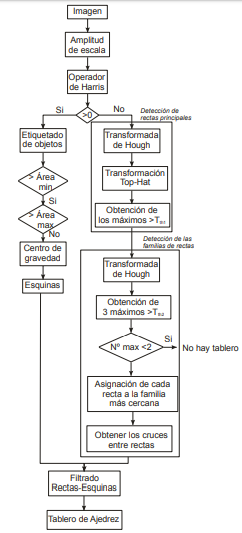
imagenes libro/etapas del metodo de calibración.PNG
