JavierPerez24/Escaner3D/Diagramas/iluminación.pdf

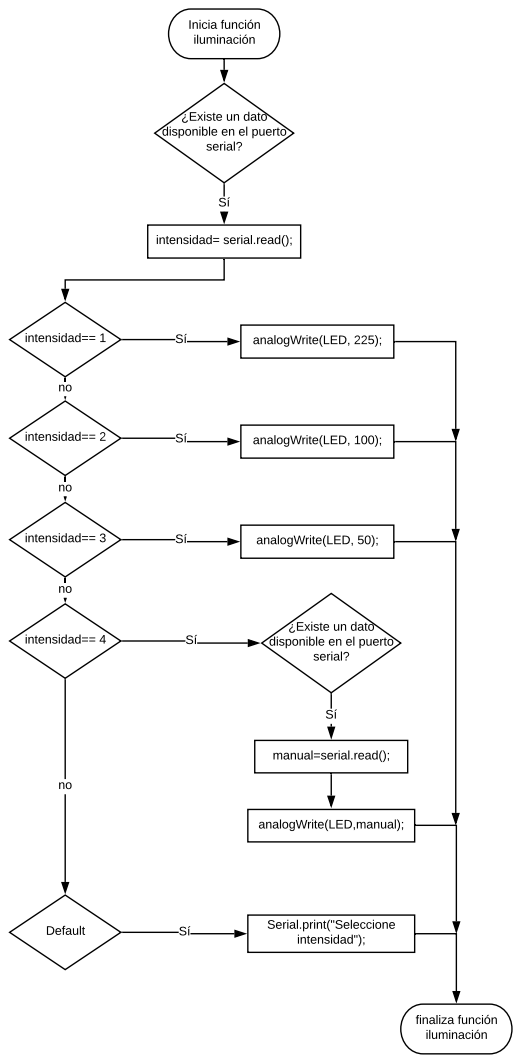
[picture p260: page 1]
Inicia función iluminación; serial?; intensidad== 1; intensidad== 2; intensidad== 3; intensidad== 4; analogWrite(LED, 225);; analogWrite(LED, 100);; analogWrite(LED, 50);; Default; finaliza función iluminación

¿Existe un dato
disponible en el puerto

intensidad= serial.read();

manual=serial.read();

analogWrite(LED,manual);

Serial.print("Seleccione
intensidad");
