JavierPerez24/Escaner3D/Modelado/inferior/acople eje NOMBRES .PDF

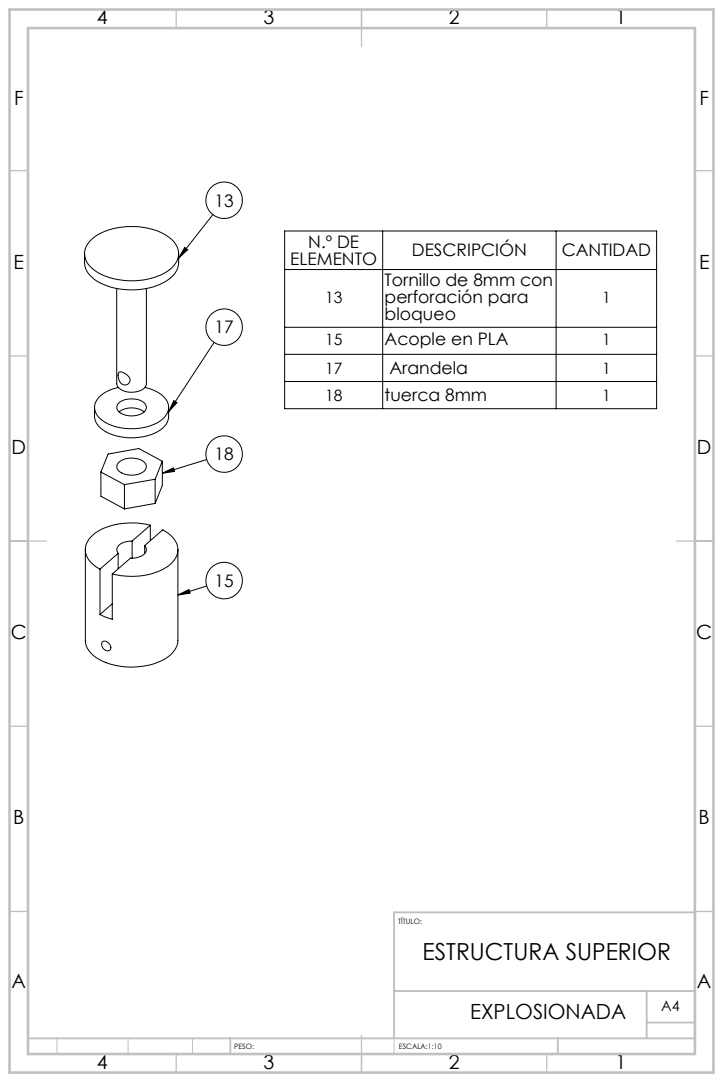
[picture p261: page 1]
ESTRUCTURA SUPERIOR

N.º DE ELEMENTO | DESCRIPCIÓN | CANTIDAD
13 | Tornillo de 8mm con perforación para bloqueo | 1

15 | Acople en PLA | 1
17 | Arandela | 1
18 | tuerca 8mm | 1
