JavierPerez24/Escaner3D/Modelado/superior/Ensamblaje superior nombres.PDF

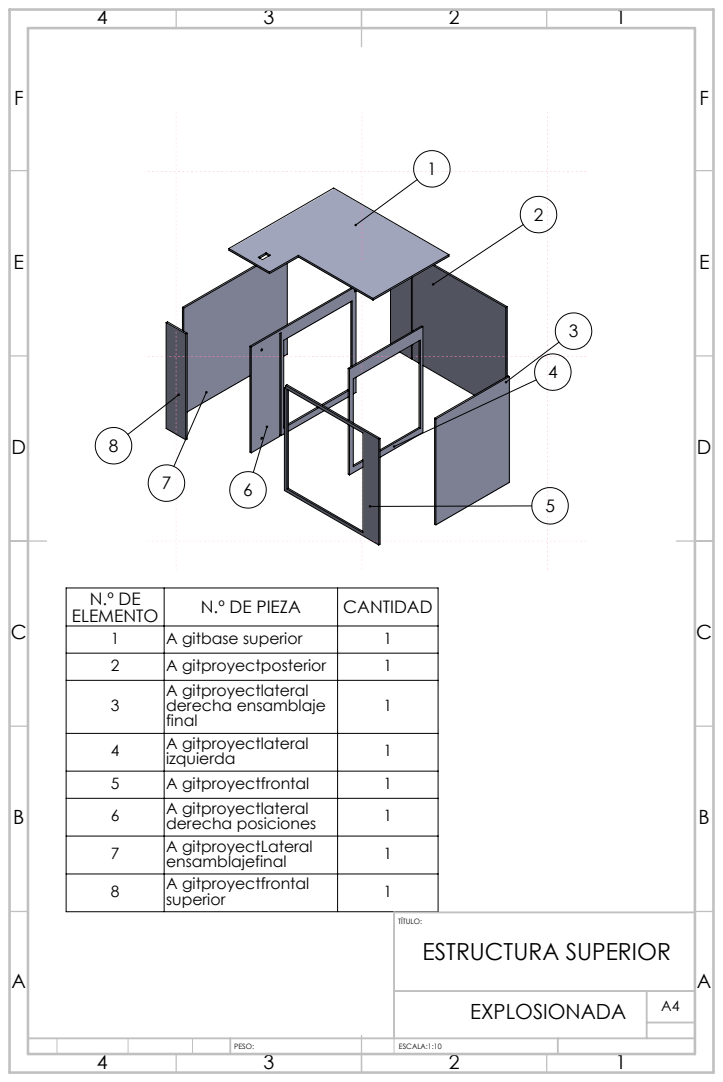
[picture p262: page 1]
ESTRUCTURA SUPERIOR

N.º DE ELEMENTO | N.º DE PIEZA | CANTIDAD
1 | A gitbase superior | 1
2 | A gitproyectposterior | 1
3 | A gitproyectlateral derecha ensamblaje final | 1

4 | A gitproyectlateral izquierda | 1
5 | A gitproyectfrontal | 1
6 | A gitproyectlateral derecha posiciones | 1
7 | A gitproyectLateral ensamblajefinal | 1
8 | A gitproyectfrontal superior | 1
