JavierPerez24/Escaner3D/Modelado/inferior/acople eje .PDF

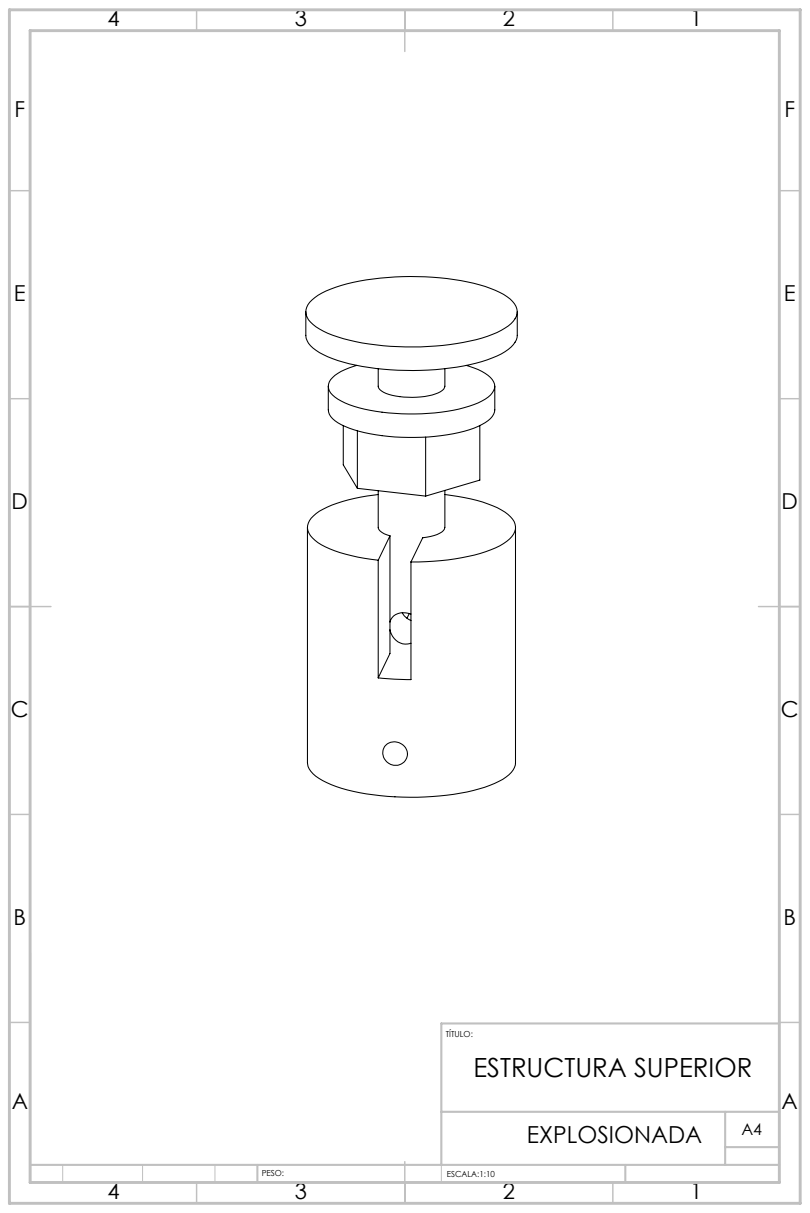
[picture p263: page 1]
ESTRUCTURA SUPERIOR
