JavierPerez24/Escaner3D/Modelado/inferior/INFERIOR FINAL.PDF

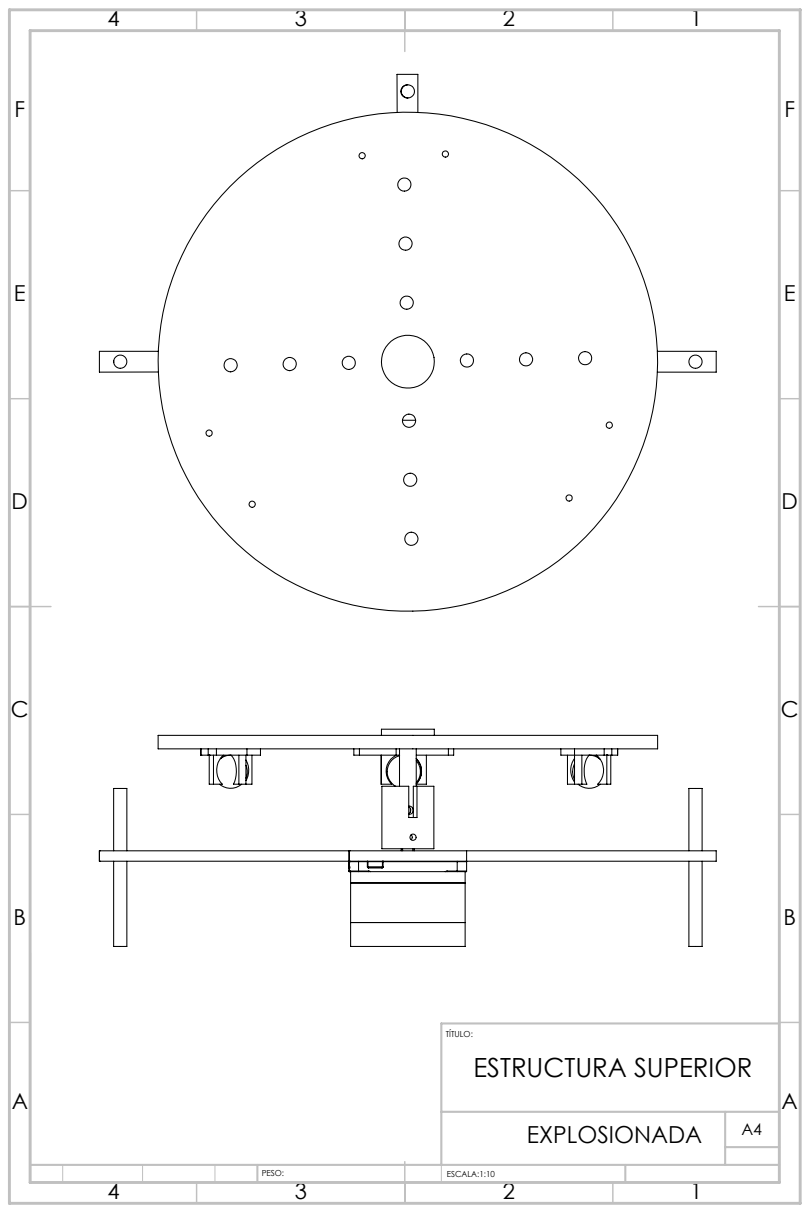
[picture p264: page 1]
ESTRUCTURA SUPERIOR
