JavierPerez24/Escaner3D/Modelado/traslacion/rosca.PDF

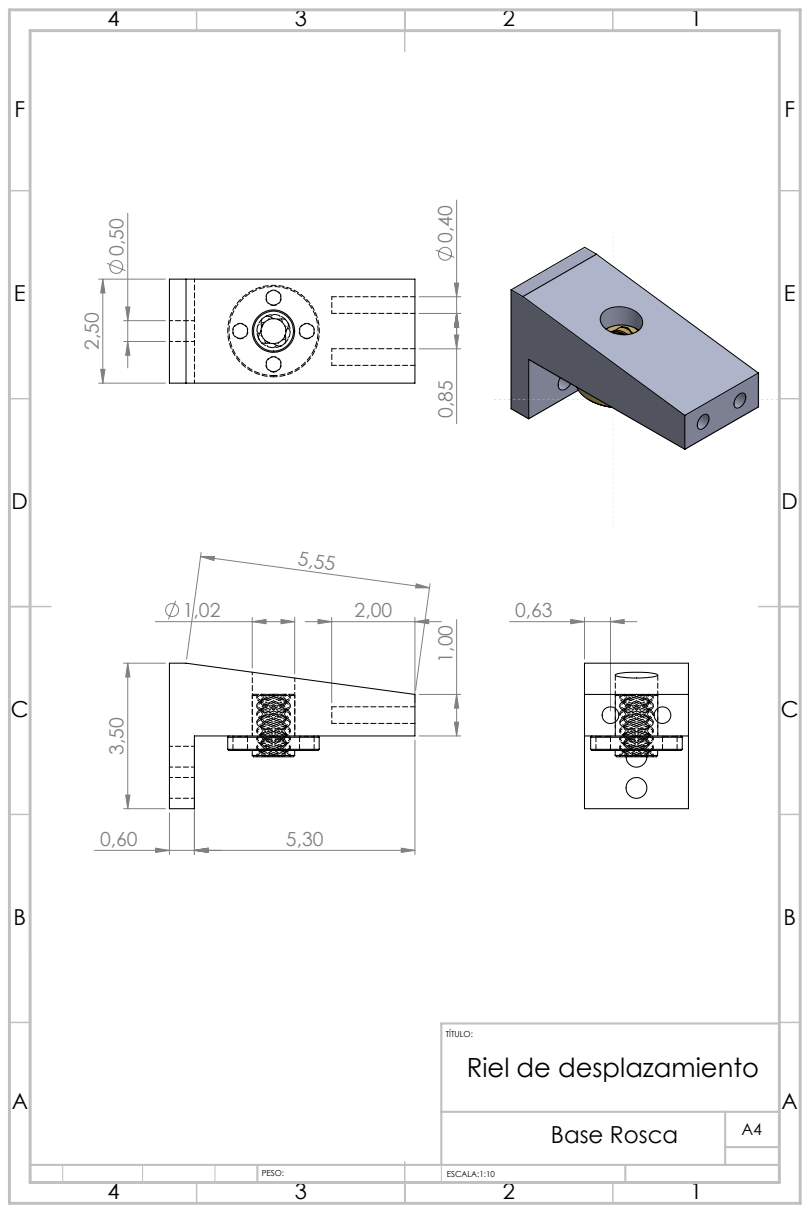
[picture p265: page 1]
Base Rosca

TÍTULO:
Riel de desplazamiento
