JavierPerez24/Escaner3D/Modelado/inferior/inferior NOMBRES.PDF

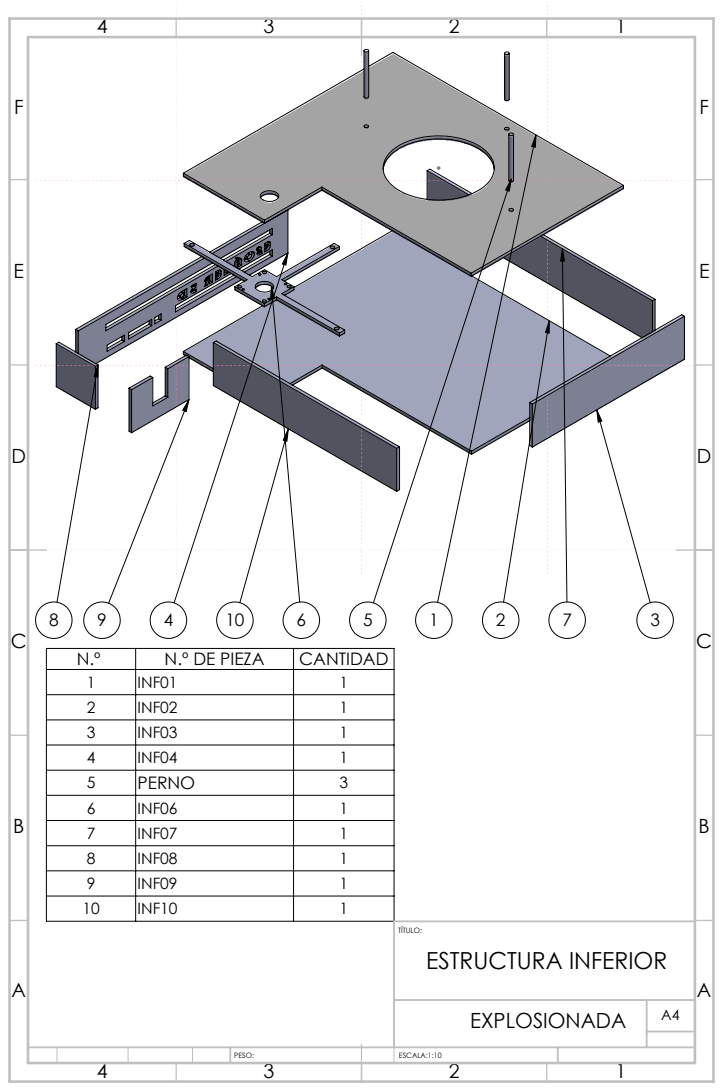
[picture p266: page 1]
ESTRUCTURA INFERIOR

N.º | N.º DE PIEZA | CANTIDAD
1 | INF01 | 1
2 | INF02 | 1
3 | INF03 | 1
4 | INF04 | 1
5 | PERNO | 3
6 | INF06 | 1
7 | INF07 | 1
8 | INF08 | 1
9 | INF09 | 1
10 | INF10 | 1
