JavierPerez24/Escaner3D/Modelado/inferior/Planos para corte/planos para corte inferior.PDF

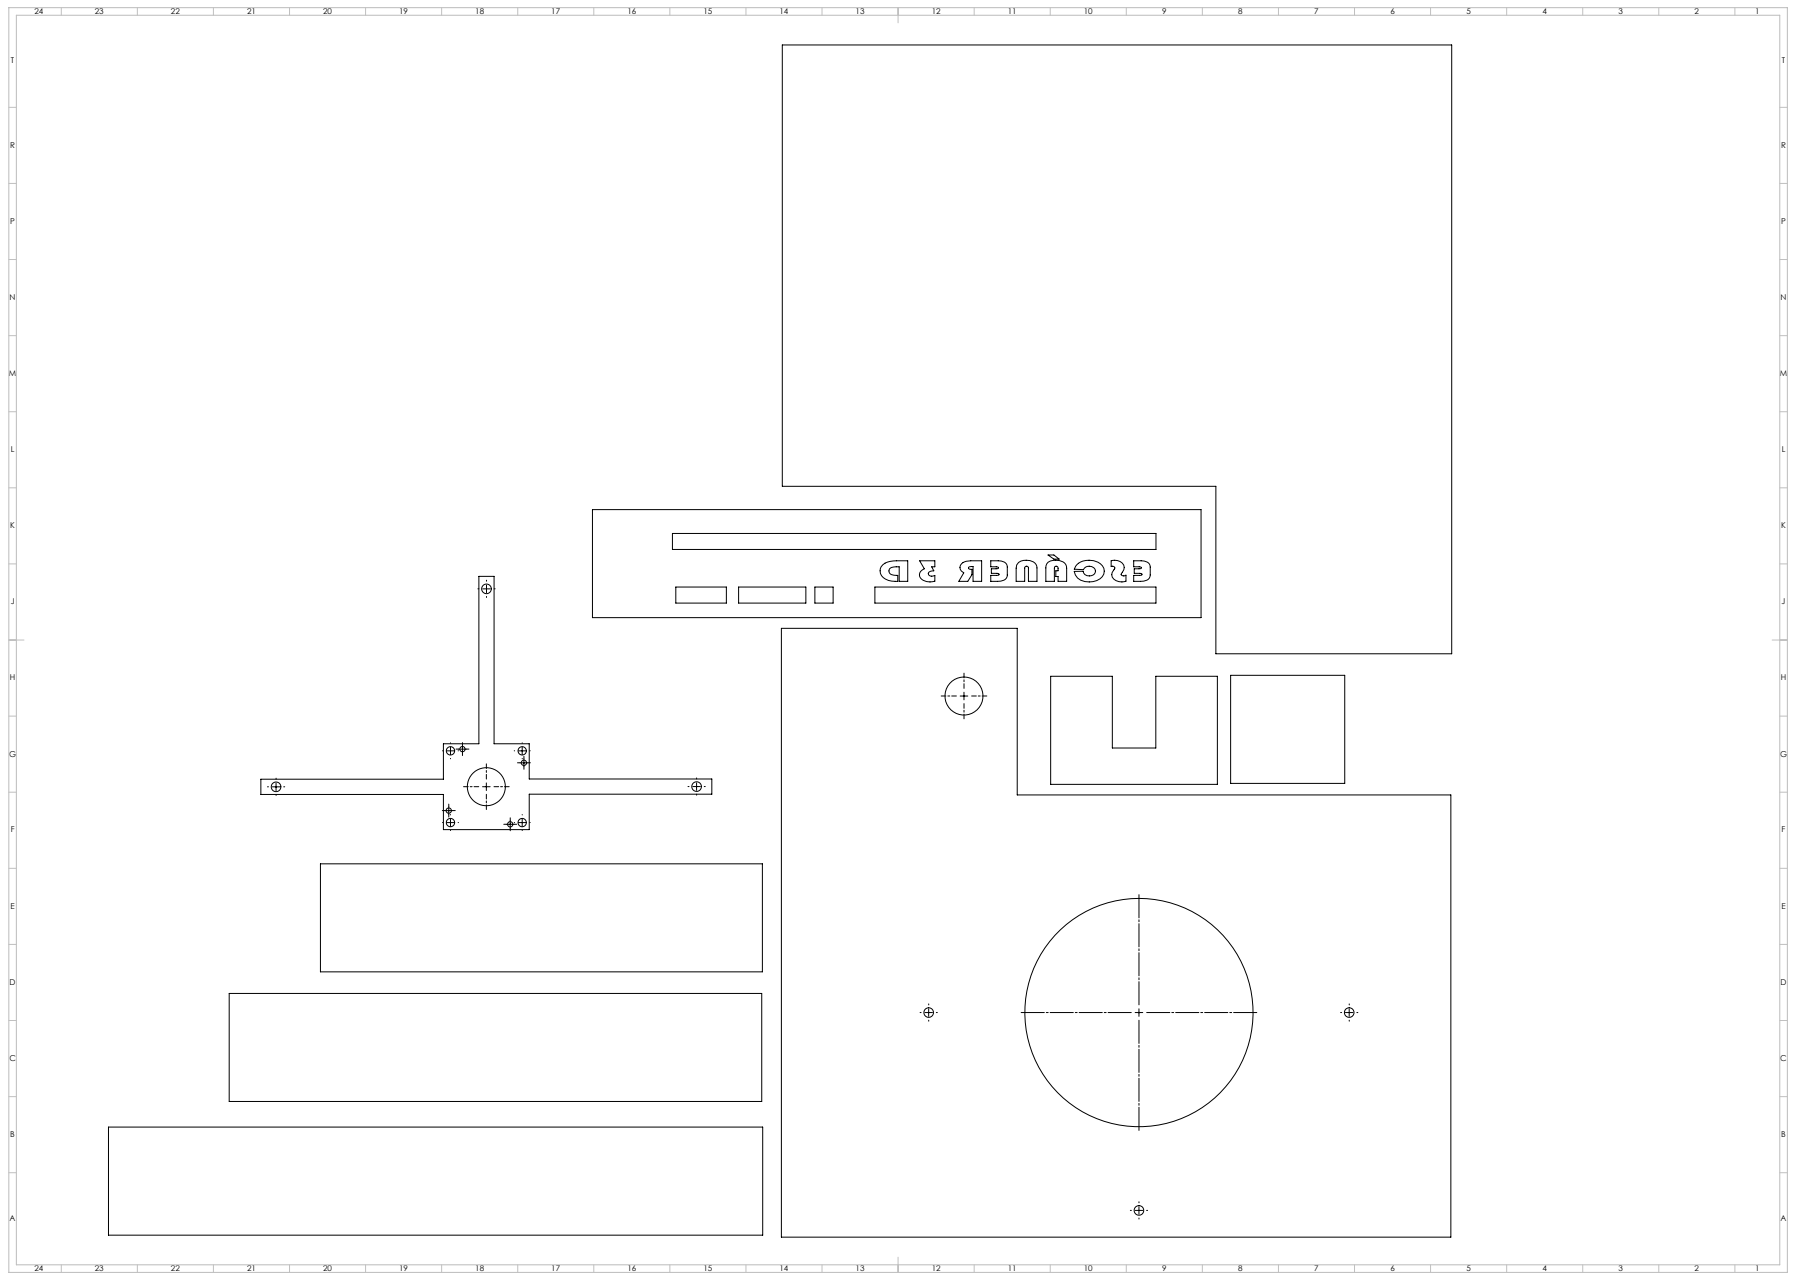
[picture p267: page 1]
