JavierPerez24/Escaner3D/Modelado/inferior/planos por piezas/INF01.PDF

ESTRUCTURA INFERIOR
