JavierPerez24/Escaner3D/Modelado/inferior/planos por piezas/INF02.PDF

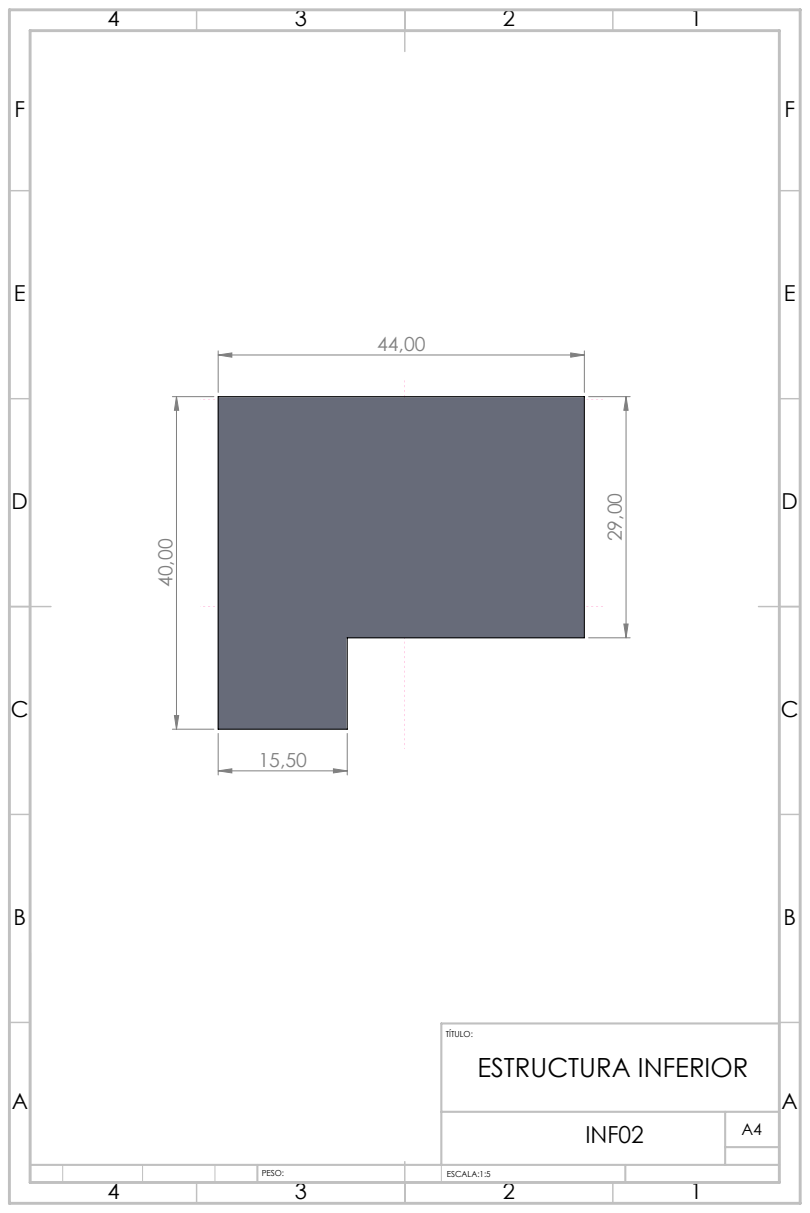
[picture p268: page 1]
ESTRUCTURA INFERIOR
