JavierPerez24/Escaner3D/Modelado/inferior/planos por piezas/INF03.PDF

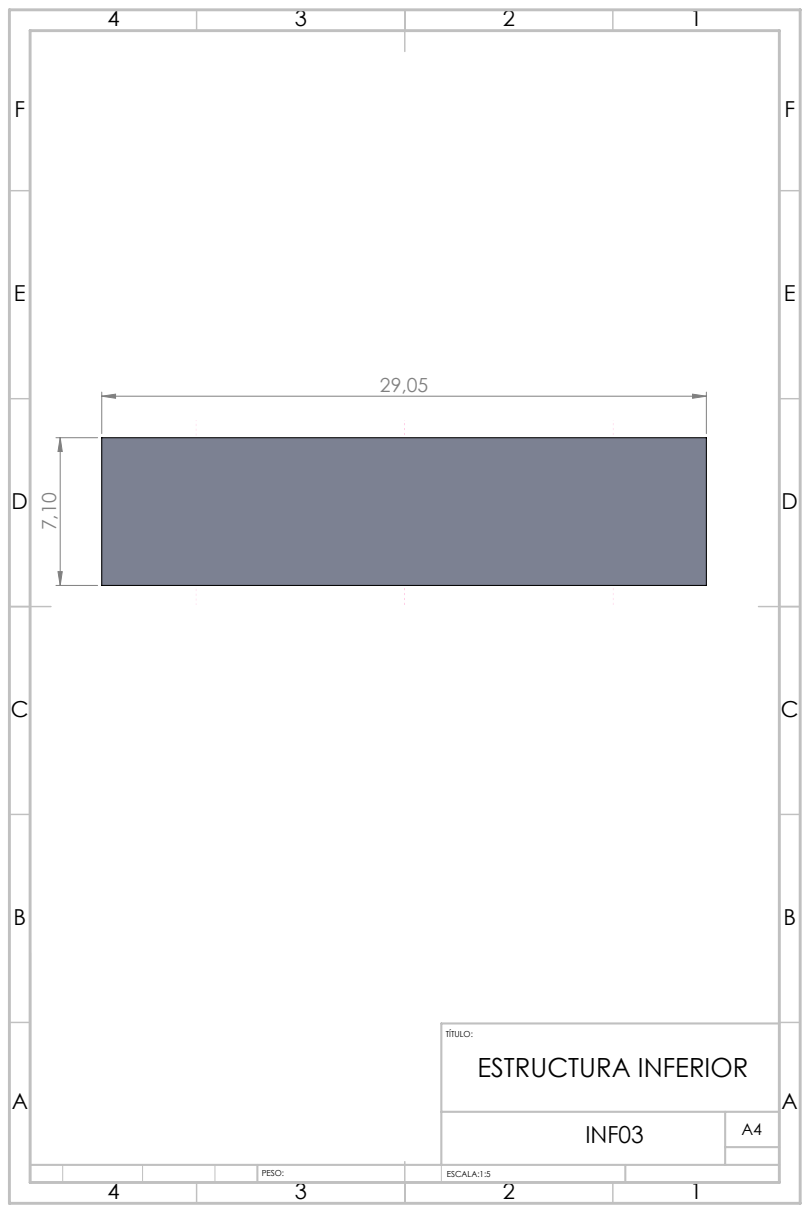
[picture p269: page 1]
ESTRUCTURA INFERIOR
