JavierPerez24/Escaner3D/Modelado/inferior/planos por piezas/INF04.PDF

ESTRUCTURA INFERIOR
