JavierPerez24/Escaner3D/Modelado/inferior/planos por piezas/INF06.PDF

ESTRUCTURA INFERIOR
