JavierPerez24/Escaner3D/Modelado/inferior/planos por piezas/INF07.PDF

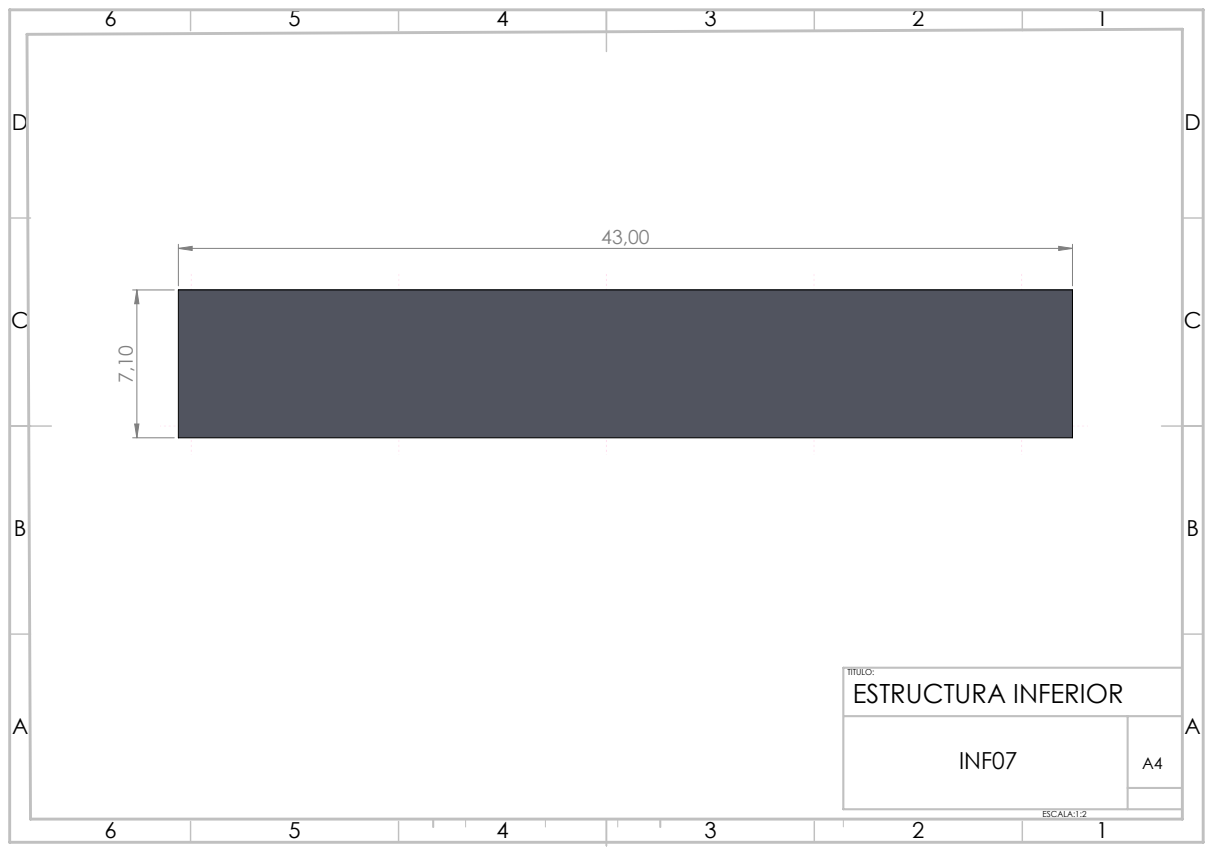
[picture p270: page 1]
ESTRUCTURA INFERIOR
