JavierPerez24/Escaner3D/Modelado/inferior/planos por piezas/INF08.PDF

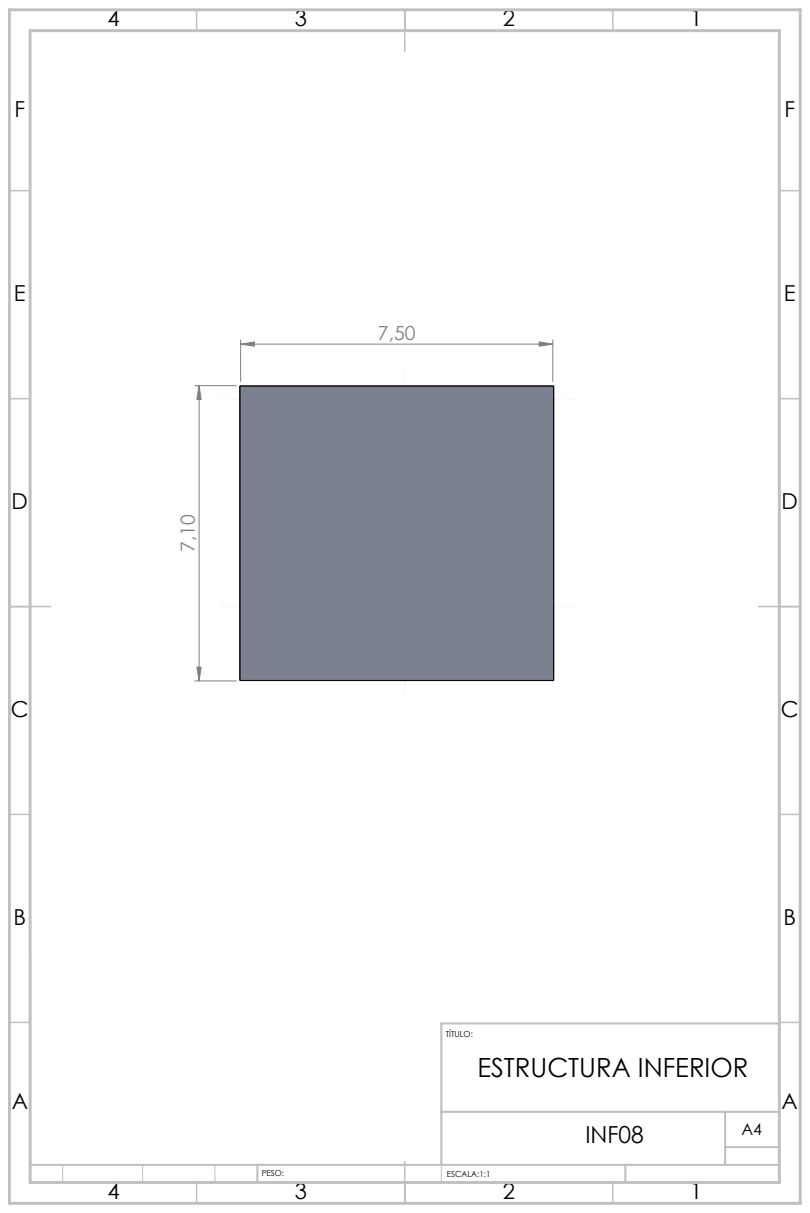
[picture p271: page 1]
ESTRUCTURA INFERIOR
