JavierPerez24/Escaner3D/Modelado/inferior/planos por piezas/INF09.PDF

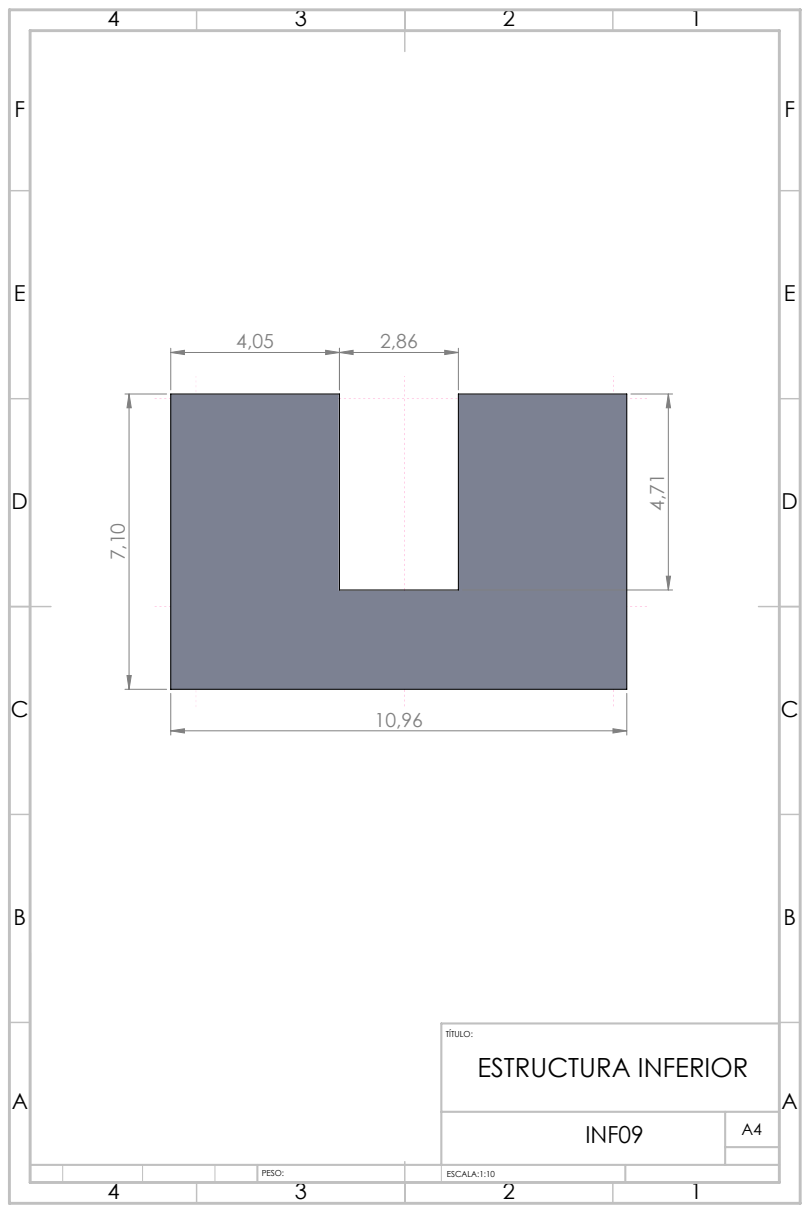
[picture p272: page 1]
ESTRUCTURA INFERIOR
