JavierPerez24/Escaner3D/Modelado/inferior/planos por piezas/INF10.PDF

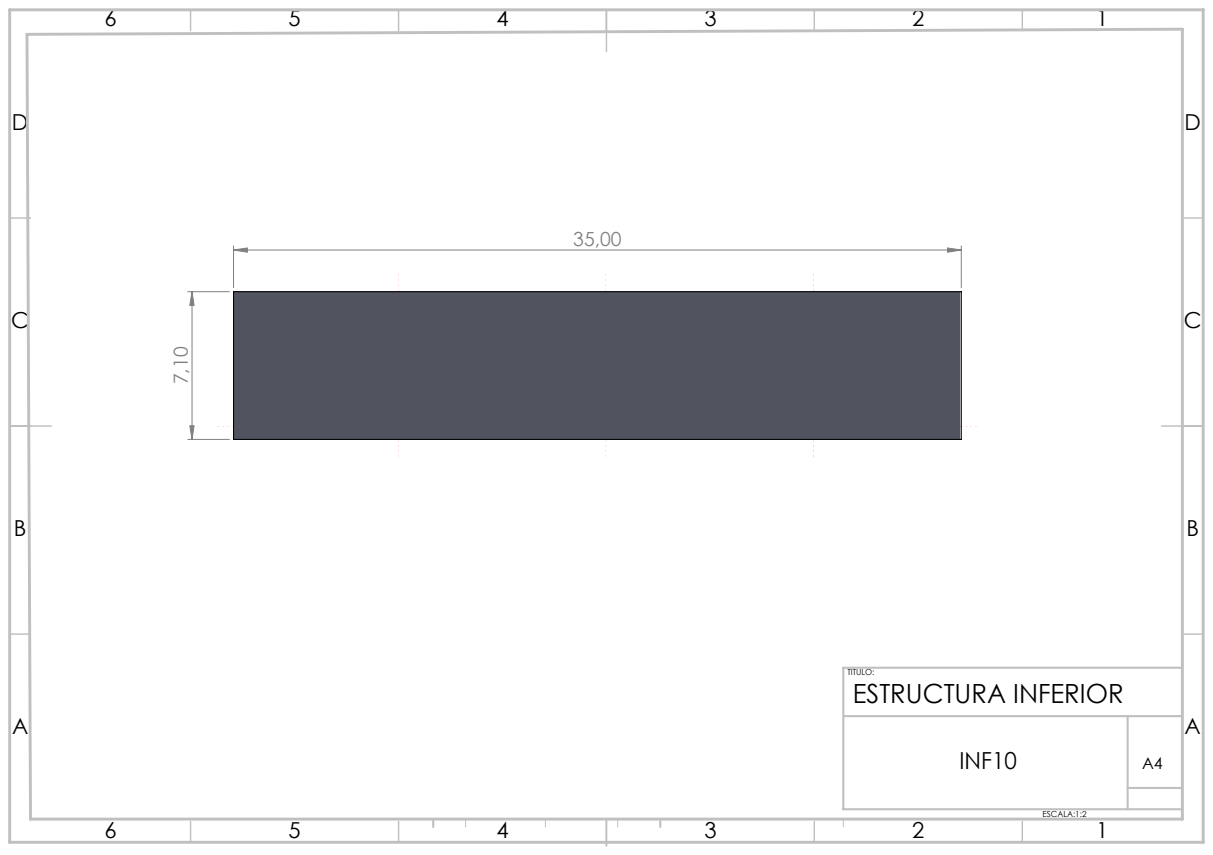
[picture p273: page 1]
ESTRUCTURA INFERIOR
