JavierPerez24/Escaner3D/Modelado/superior/cortes superior/SUP01-06 cortes.PDF

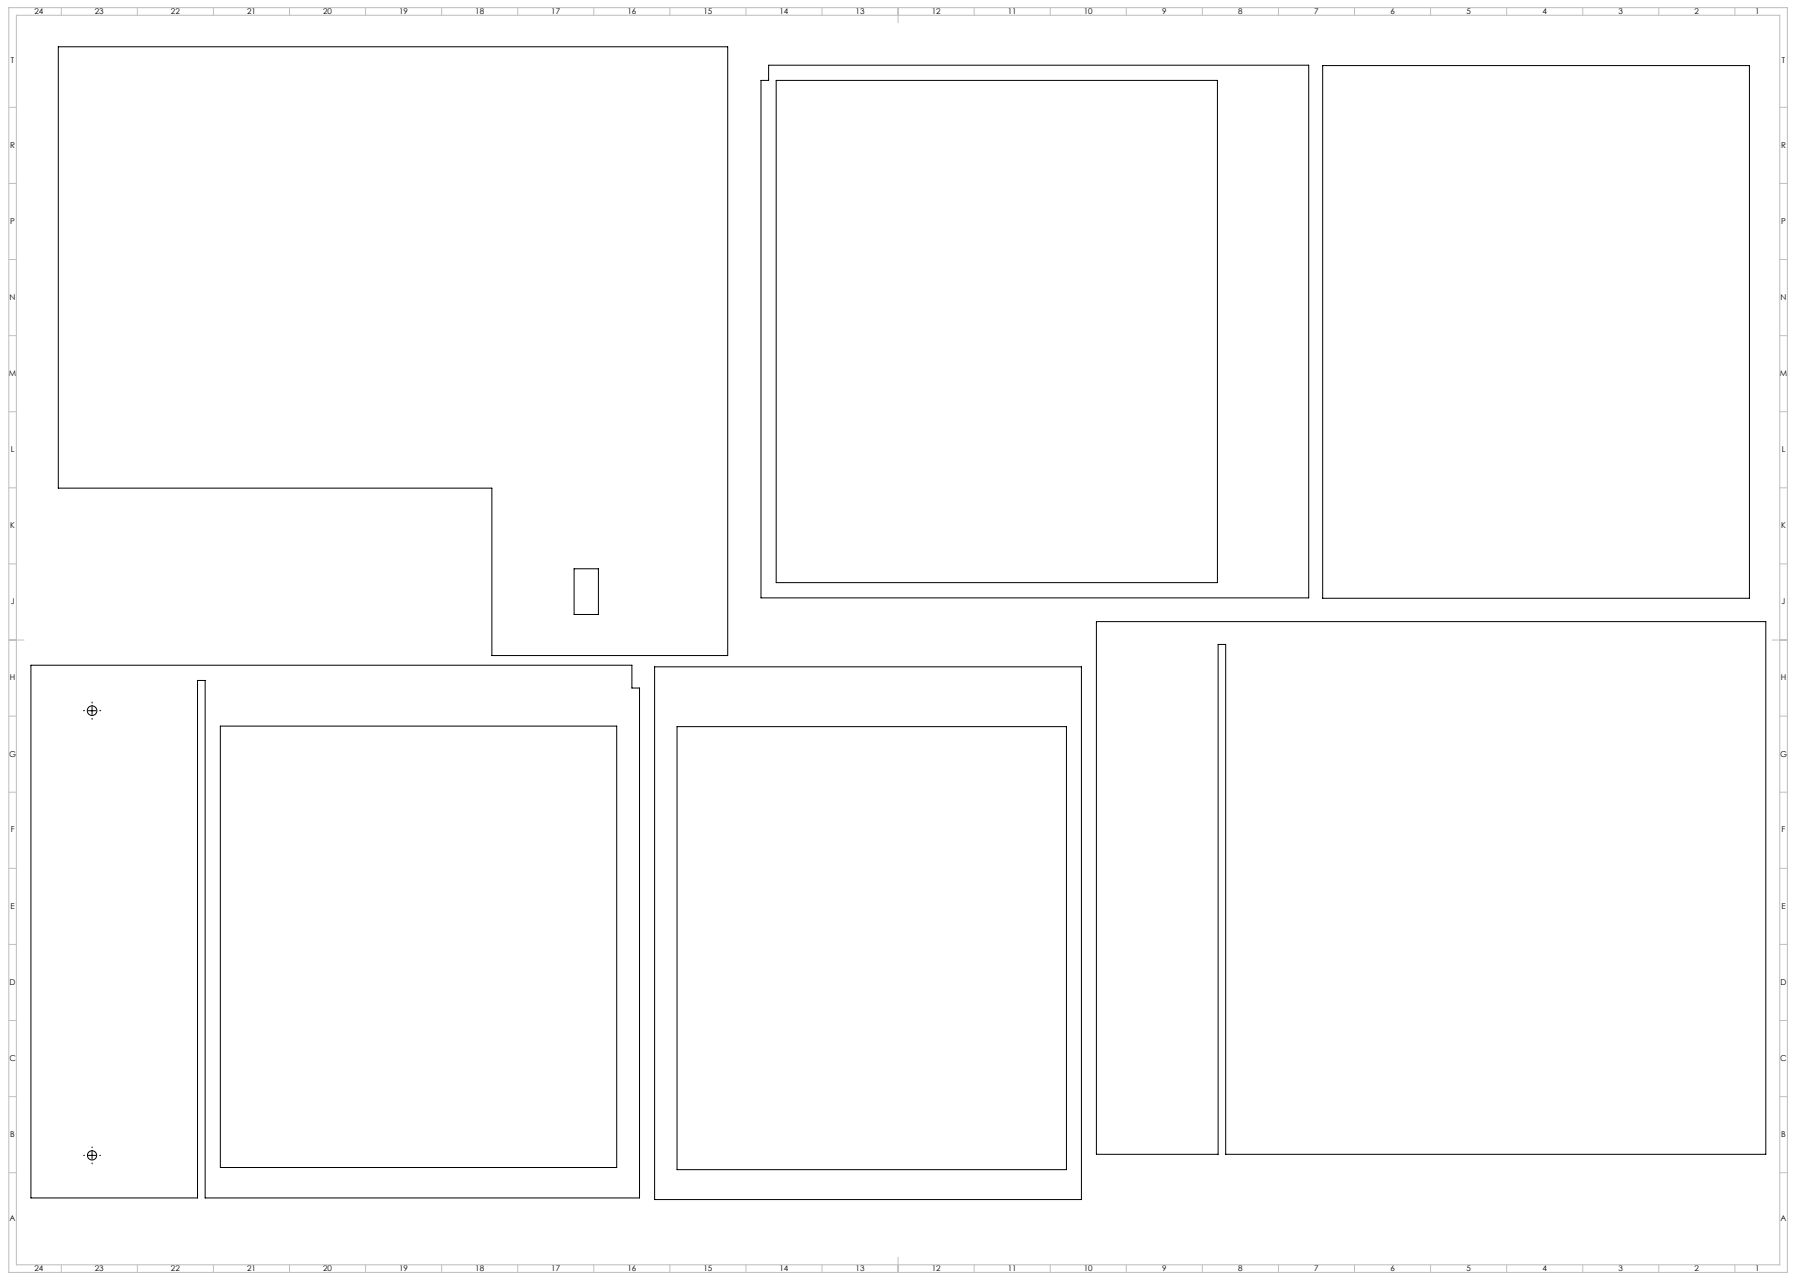
[picture p274: page 1]
