JavierPerez24/Escaner3D/Modelado/superior/cortes superior/SUP07-08 cortes.PDF

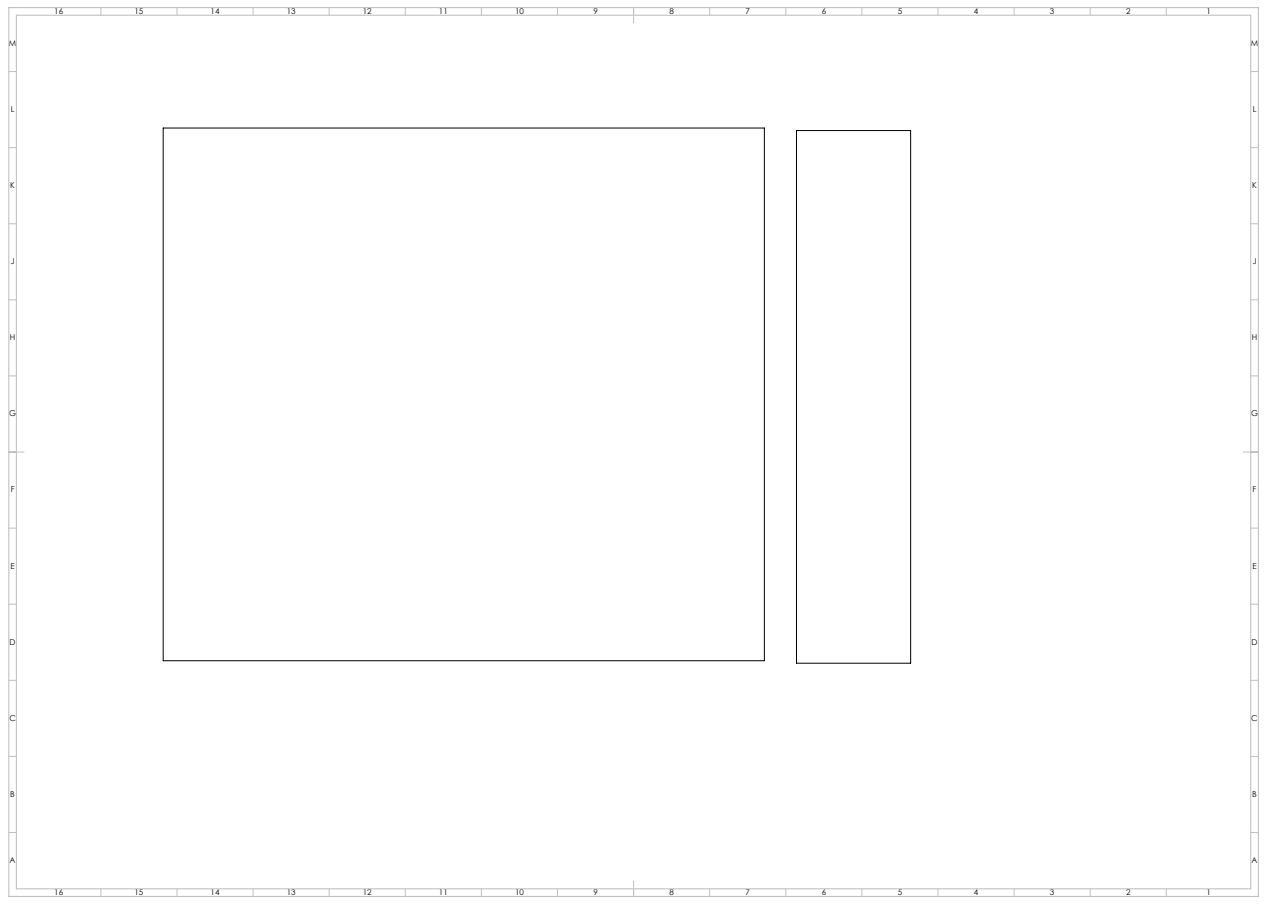
[picture p275: page 1]
