JavierPerez24/Escaner3D/Modelado/superior/planos por piezas/SUP01.PDF

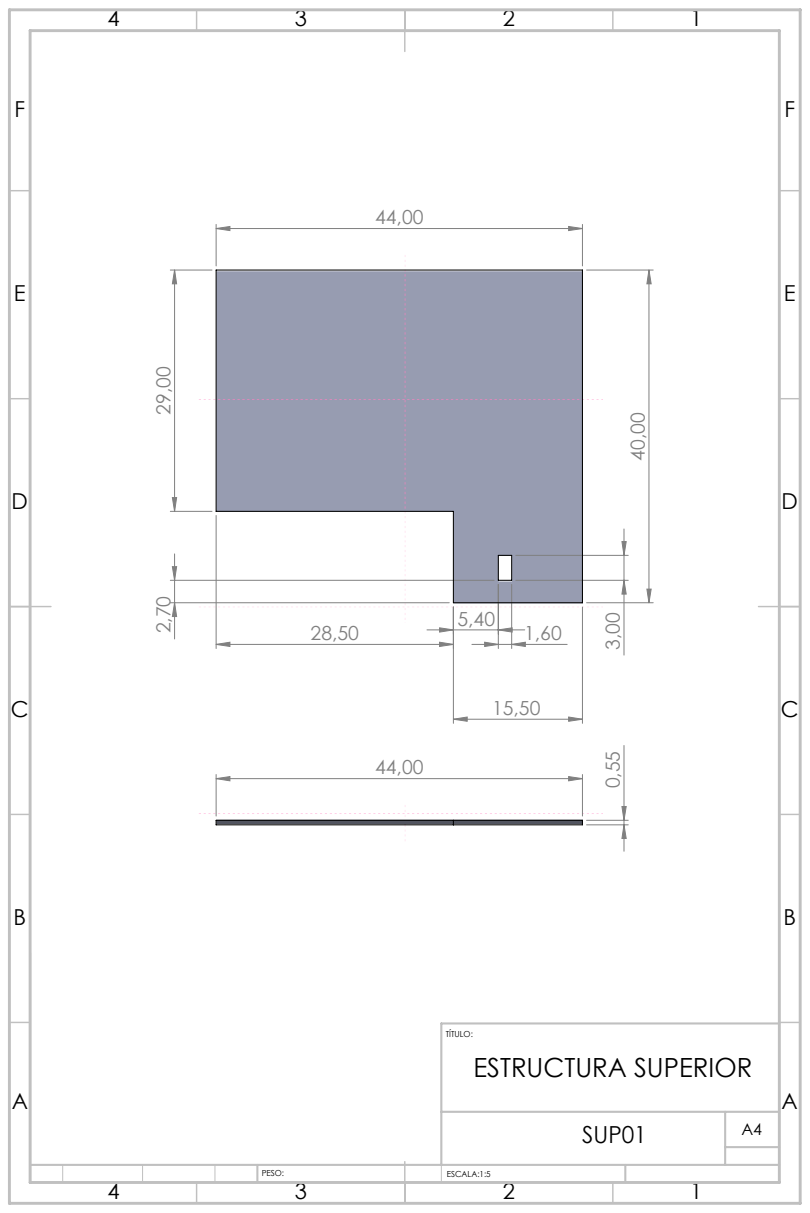
[picture p276: page 1]
ESTRUCTURA SUPERIOR
