JavierPerez24/Escaner3D/Modelado/superior/planos por piezas/SUP02.PDF

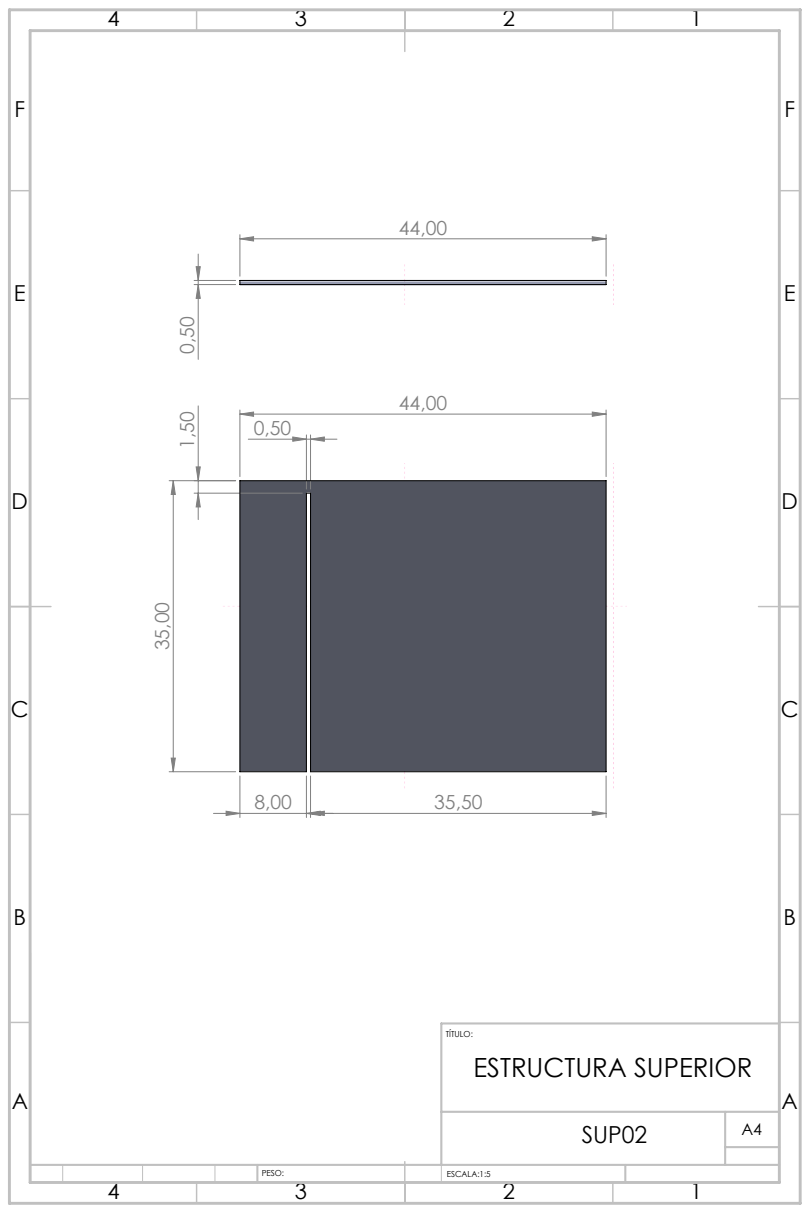
[picture p277: page 1]
ESTRUCTURA SUPERIOR
