JavierPerez24/Escaner3D/Modelado/superior/planos por piezas/SUP03.PDF

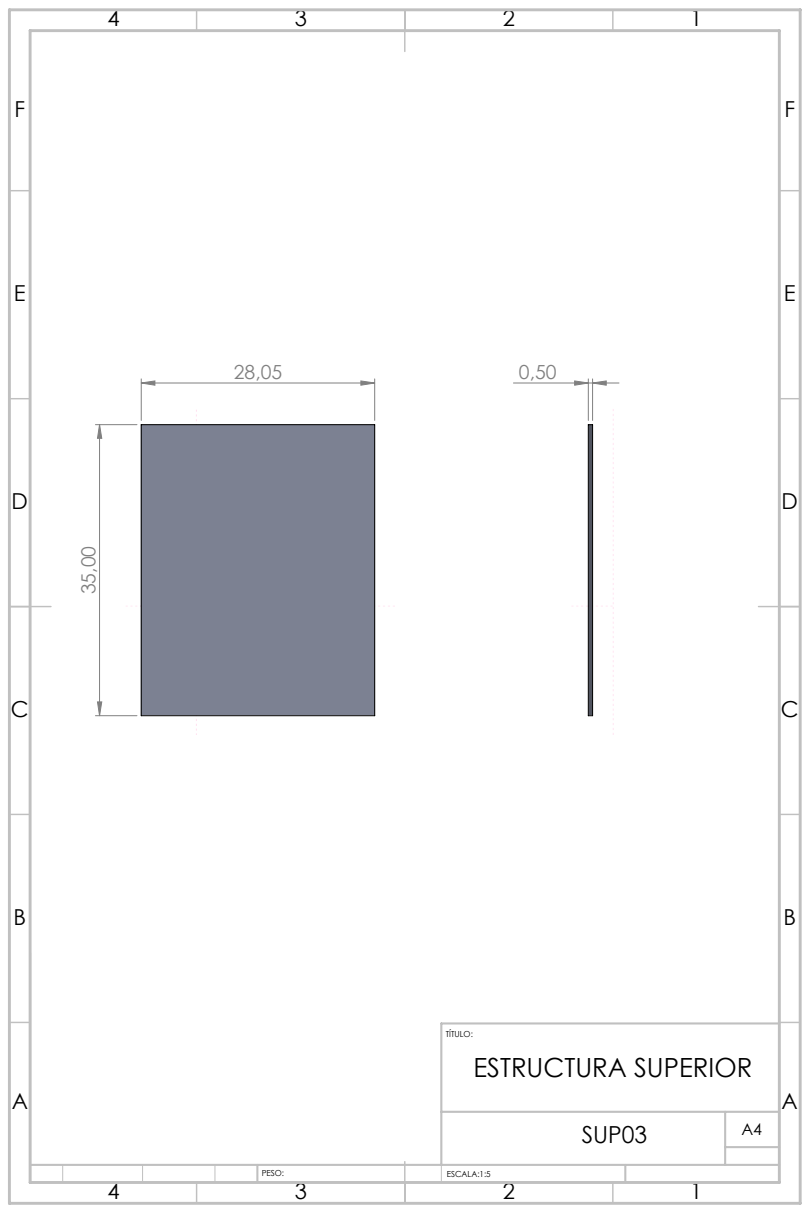
[picture p278: page 1]
ESTRUCTURA SUPERIOR
