JavierPerez24/Escaner3D/Modelado/superior/planos por piezas/SUP04.PDF

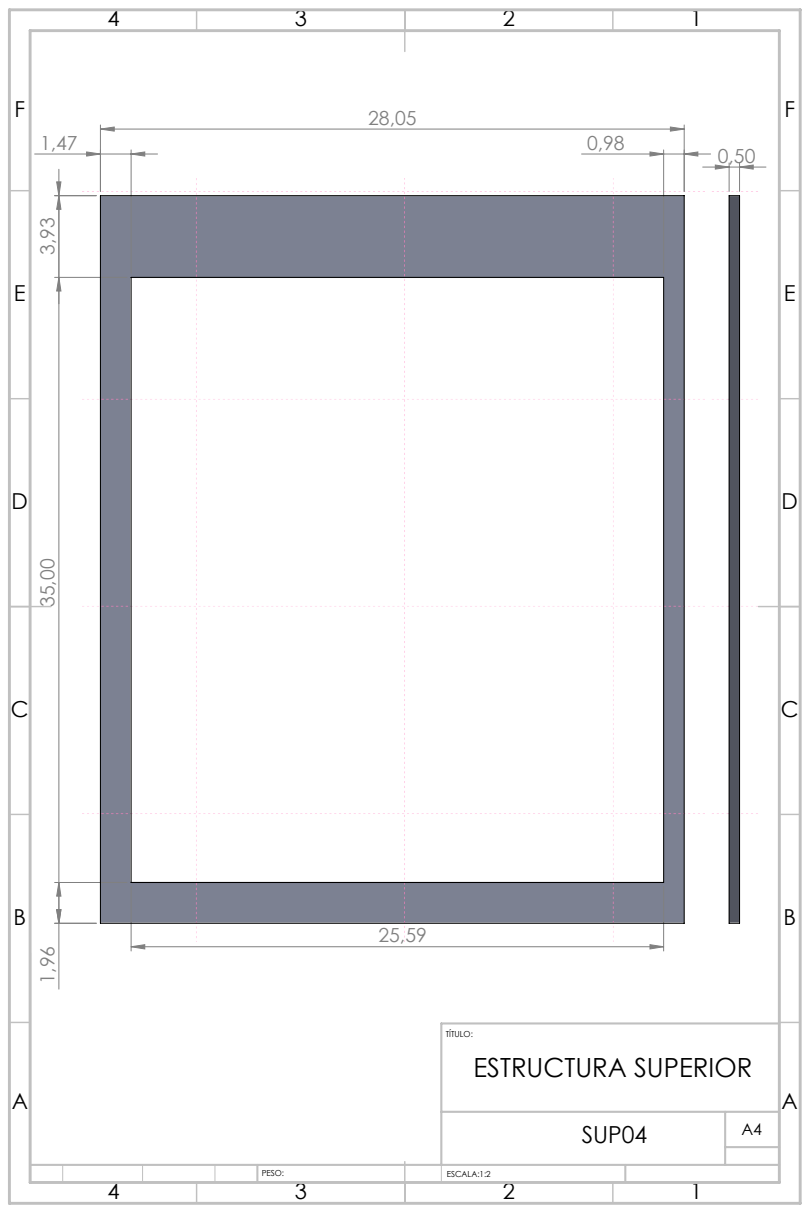
[picture p279: page 1]
ESTRUCTURA SUPERIOR
