JavierPerez24/Escaner3D/Modelado/superior/planos por piezas/SUP05.PDF

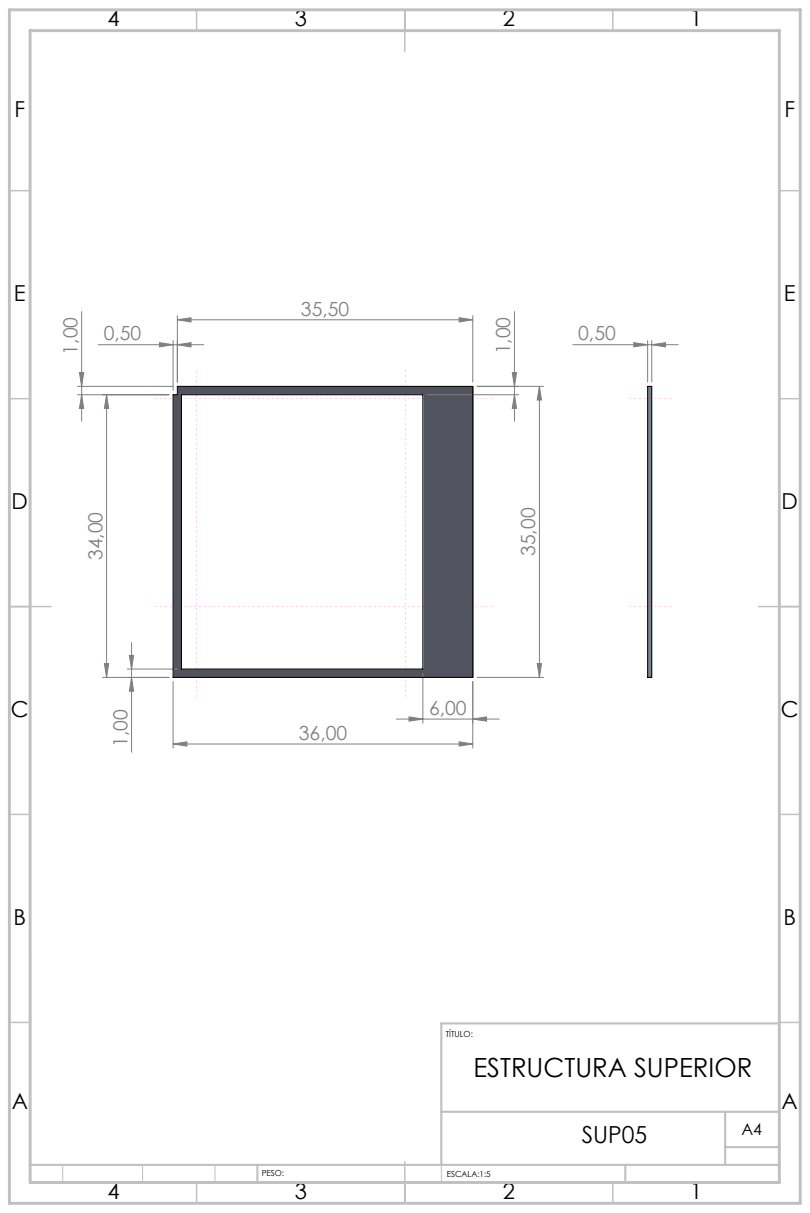
[picture p280: page 1]
ESTRUCTURA SUPERIOR
