JavierPerez24/Escaner3D/Modelado/superior/planos por piezas/SUP06.PDF

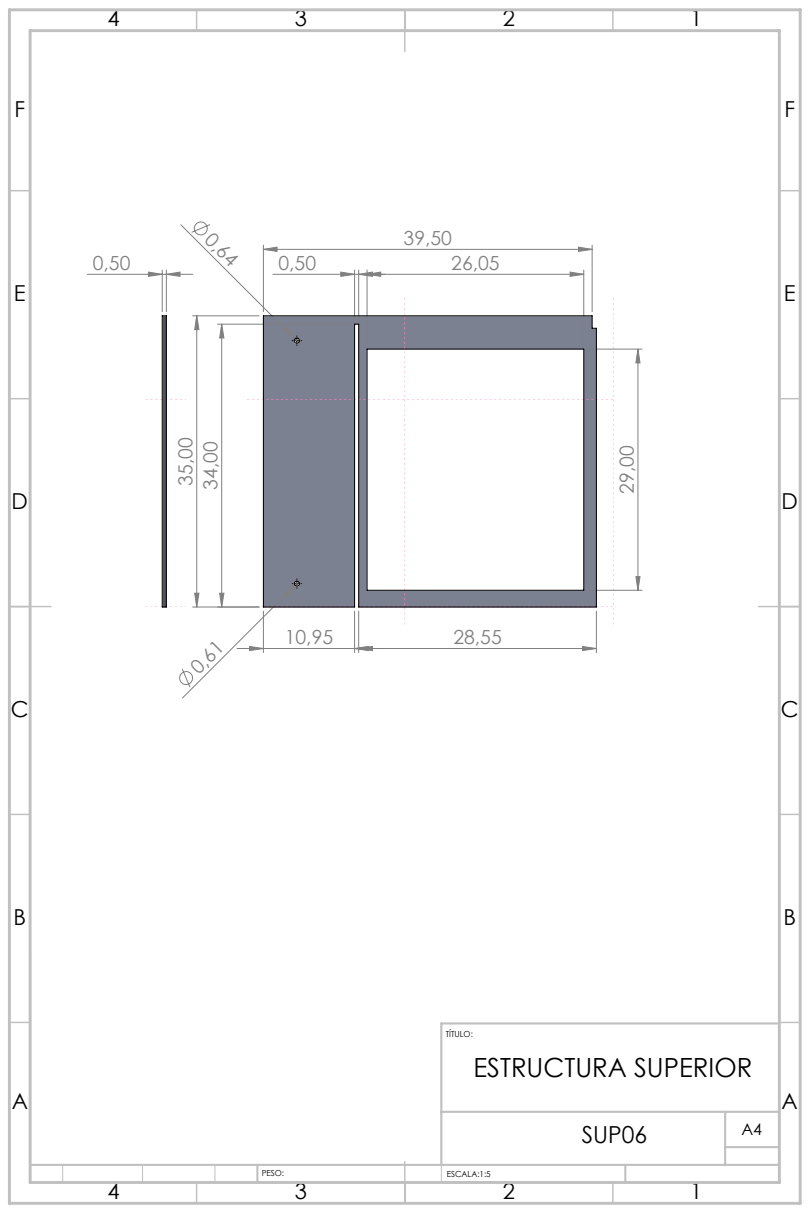
[picture p281: page 1]
ESTRUCTURA SUPERIOR
