JavierPerez24/Escaner3D/Modelado/superior/planos por piezas/SUP07.PDF

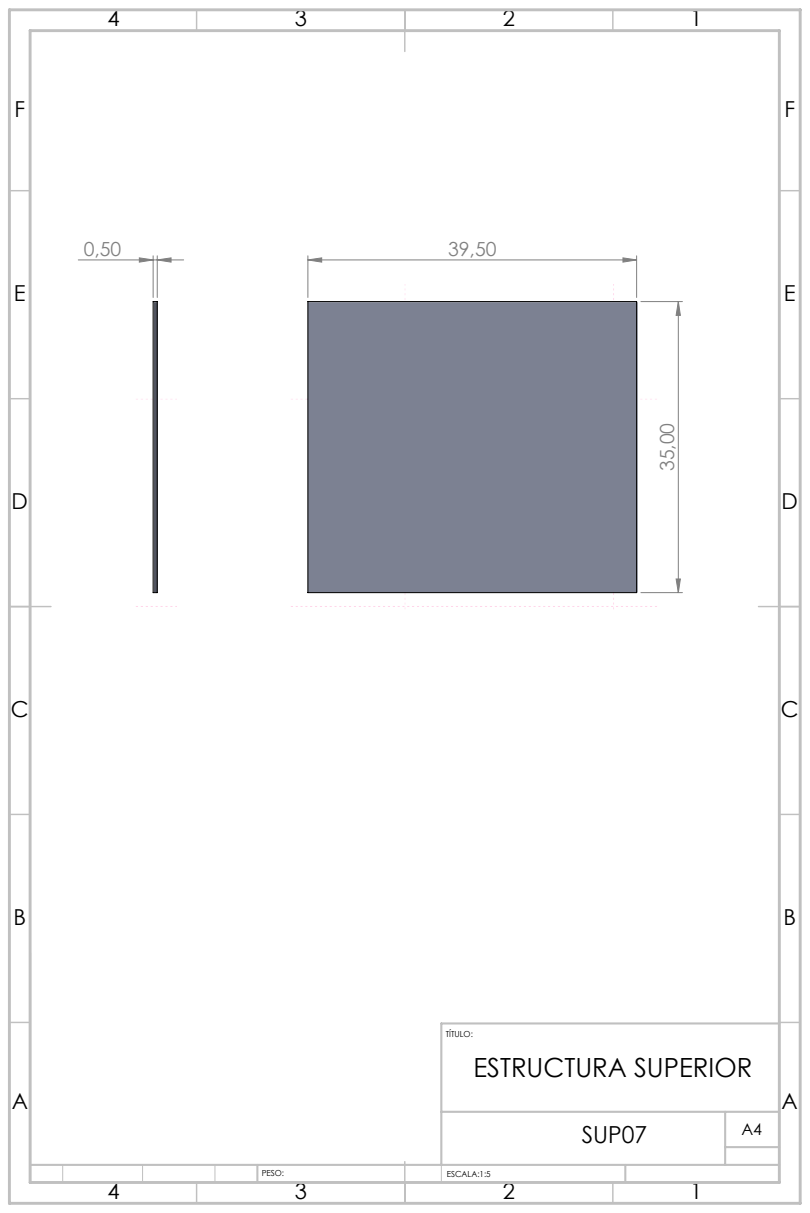
[picture p282: page 1]
ESTRUCTURA SUPERIOR
