JavierPerez24/Escaner3D/Modelado/superior/planos por piezas/SUP08.PDF

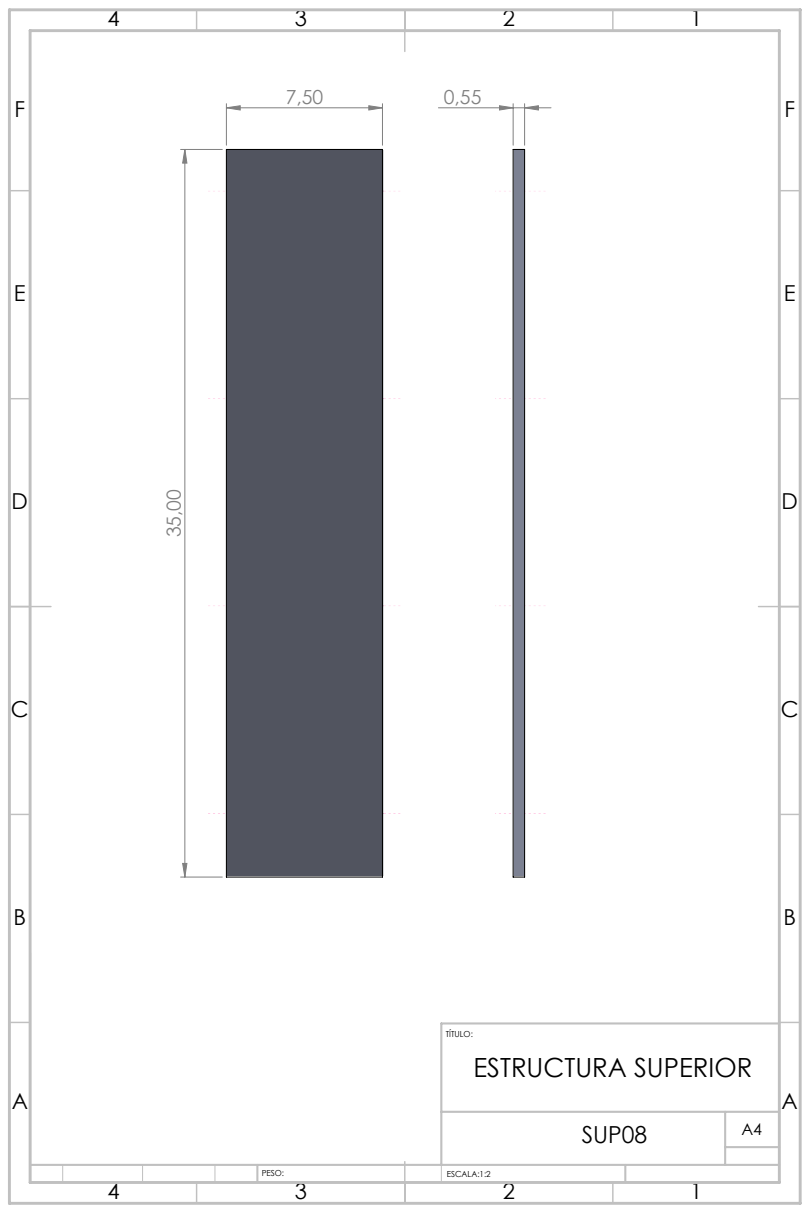
[picture p283: page 1]
ESTRUCTURA SUPERIOR
