JavierPerez24/Escaner3D/(list of files, drawings)

Other design files:
programación escaner/Trigger cam.pdsprj
proteus/EscanerPCB.pdsprj
proteus/PCB ESCANER.pdsprj
