JavierPerez24/Escaner3D/(commit log)

2019-11-02 sin comntario
    [A git proyectlateral izqierda.SLDPRT, A gitbase superior.SLDPRT, A gitproyectfrontal superior.SLDPRT, A gitproyectfrontal.SLDPRT, A gitproyectlateral ensamblajefinal.SLDPRT, A gitproyectlateralderecha posiciones.SLDPRT, A gitproyectposterior.SLDPRT, A gtproyectlateralizquierda.SLDPRT]
2019-11-03 sabado 2 de nov
    [Ensamblaje con riel.SLDASM, Tuerca ACME 5-16 (4 cuerdas).SLDPRT, base rosca.SLDPRT, gitproyectNEMA Stepper.SLDPRT, gitproyectRiel.SLDPRT, gitproyectguia riel.SLDPRT, rodamiento.SLDPRT]
2019-11-04 Libro actualizado 4 de nov
    [Ensamblaje con riel.SLDASM, Tuerca ACME 5-16 (4 cuerdas).SLDPRT, rosca.SLDASM, rosca.SLDDRW]
2019-11-13 13 nov
    [INF01.SLDPRT, INF02.SLDPRT, INF03.SLDPRT, INF04.SLDPRT, INF06.SLDPRT, INF07.SLDPRT, INF08.SLDPRT, INF09.SLDPRT]
2020-02-08 8 feb
    [A gitbase superior.SLDPRT, A gitproyectfrontal.SLDPRT, A gitproyectlateral ensamblajefinal.SLDPRT, A gitproyectlateralderecha posiciones.SLDPRT, A gitproyectposterior.SLDPRT, Ensamblaje con riel.SLDASM, Pieza3.SLDPRT, SUP03.SLDPRT]
